xopigun/Projet2A/banc-can/docs/latex/config_logicielle.tex

% ===========================================================================
%  FICHIER GÉNÉRÉ — NE PAS ÉDITER À LA MAIN
%  Produit par tools/codegen à partir des firmware/boards/*/board.h.
%  Regénérer :  python -m tools.codegen
% ===========================================================================

\begin{table}[H]
\centering\small
\begin{tabular}{lc}
\toprule
\textbf{Paramètre} & \textbf{N1--N4 (STM32G431)} \\
\midrule
Périphérique & FDCAN1, mode \emph{Classic} \\
Référence d'horloge & HSE \SI{24}{MHz} (quartz, \SI{20}{ppm}) \\
Horloge noyau CAN & \SI{80}{MHz} \\
Prescaler & 10 \\
Durée du bit & 16 tq \\
Segments (sync + 1 + 2) & 1 + 13 + 2 \\
SJW & 2 \\
Point d'échantillonnage & \SI{87.50}{\percent} \\
Tolérance d'oscillateur & \SI{0.485}{\percent} \\
Débit & \SI{500}{kbit/s} \\
\midrule
Filtres d'acceptation & aucun \\
Retransmission automatique & activée \\
Reprise après \emph{bus-off} & logicielle (\texttt{CCCR.INIT}) \\
Mode silencieux & \texttt{CCCR.MON} \\
Bouclage interne & \texttt{FDCAN\_MODE\_INTERNAL\_LOOPBACK} \\
\bottomrule
\end{tabular}
\caption{Configuration retenue du contrôleur CAN, commune aux quatre nœuds. Valeurs relues dans le \texttt{board.h} de la Nucleo-G431KB et vérifiées par \texttt{scripts/bit\_timing.py}.}
\label{tab:config-logicielle}
\end{table}
