xopigun/Projet2A/banc-can/docs/presentation/Avancement_Bus_CAN_G69.pptx

## Banc de test CAN

Point d'avancement du projet — G69-BANC-001

Groupe 69 — Conception d'une Électronique Modulaire (Bus CAN)
Samuel Gomri · Dylan Kiati · Hugo Mathoux
ENSEA — Projet 2A · novembre 2026

Notes: Présentation de l'avancement du banc de test CAN G69-BANC-001 devant l'équipe enseignante. Déroulé : où on en est, le planning, puis le détail technique (ICD, matériel, firmwares, outils, démonstration, adaptateur USB-CAN), les difficultés et la suite.

## Le besoin : un banc de test CAN générique

- Outil commun pour valider le standard CAN et les ICD écrits avec les groupes partenaires
- Aucun code propre à un partenaire : tout passe par la configuration
- Quatre projets traités au même niveau

Cobot RMD-X

Ecomarathon

Formula Student

MIR1000

Sept tests de validation

T1

Couche physique

T2

Débit et temps de bit

T3

Arbitrage ARM/GO

T4

Encodage ICD

T5

Fautes physiques

T6

Fautes logicielles

T7

Isolation galvanique

Notes: Le banc sert à tous les groupes partenaires : il ne contient rien de spécifique à l'un d'eux. Paramètres choisis : 500 kbit/s, CAN 2.0A, échantillonnage à 87,5 %. La tolérance d'horloge de 0,485 % est ce qui nous a obligés à utiliser le quartz (voir mise en route). Sept tests, de la couche physique à l'isolation galvanique ; T3, T4 et T6 sont automatisés par canbench.

## L'ICD : une seule source pour tout le monde

Code C
des firmwares

- Aucune recopie à la main : un test de CI vérifie que le code généré est à jour
- 248 vecteurs de référence : tous les encodeurs donnent le même résultat
- Formulaire ICD distribué aux groupes partenaires

bench_icd.yaml

identifiants, signaux, encodages

Générateur

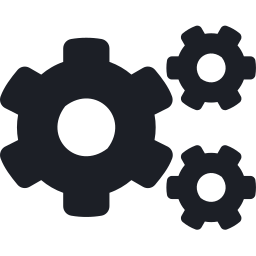
[picture p5: figure]

Python
des outils PC

Fichier DBC
pour les logiciels CAN

Tableaux LaTeX
du dossier

Exemple d'application : schéma du bus du Cobot (dossier Cobot/).

Notes: Point clé de la conception : l'ICD est décrite une seule fois, dans un fichier YAML. Un générateur en tire le code C, le Python, un DBC et les tableaux LaTeX du dossier. On ne recopie jamais d'identifiant à la main, et la CI échoue si le code généré n'est plus à jour.

## Le matériel du banc

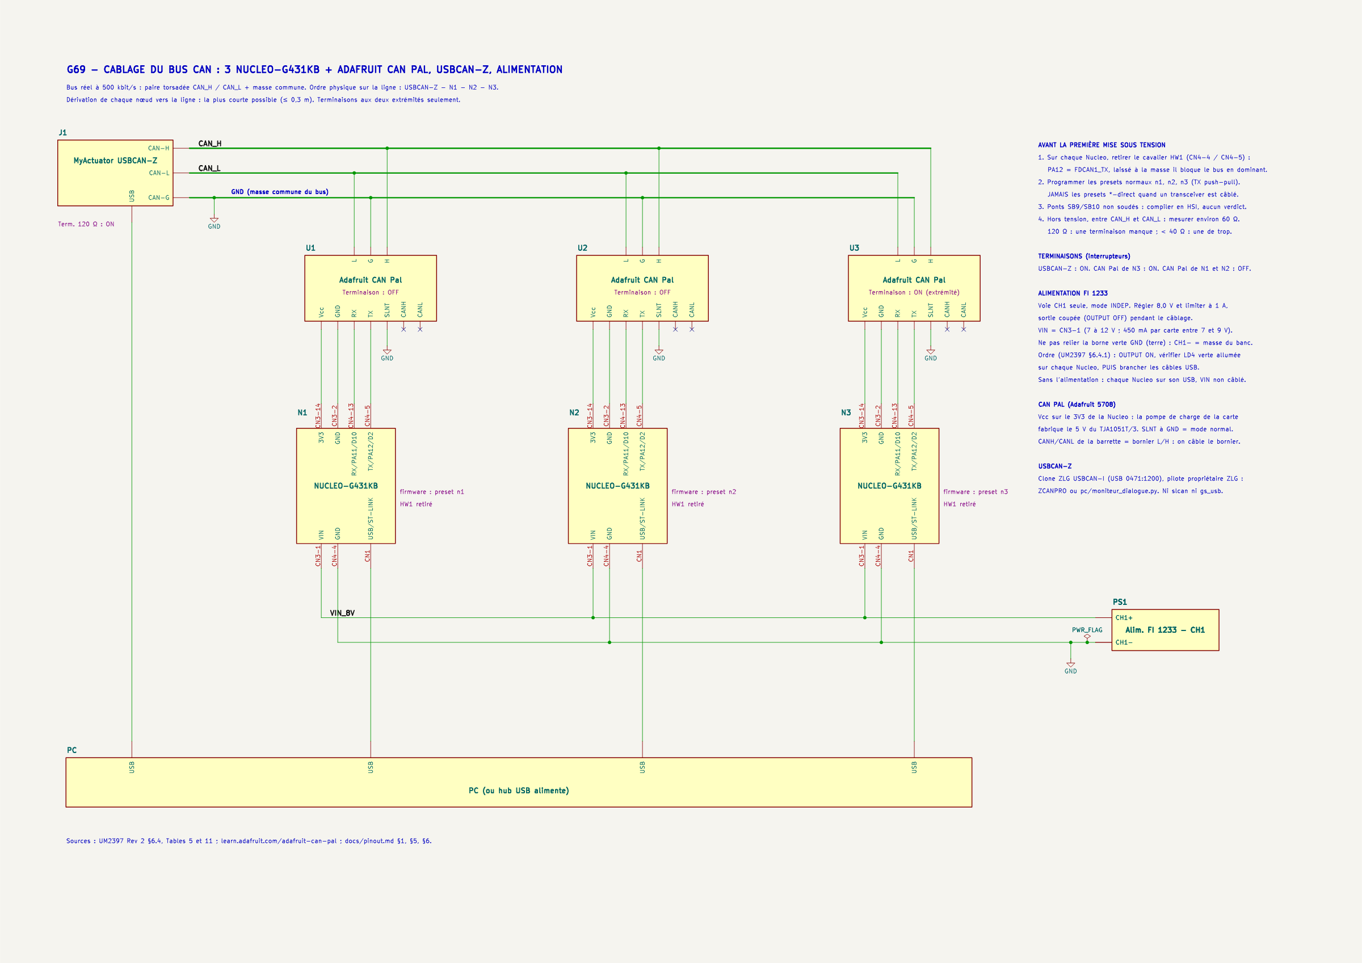
[picture p6: figure]
Schéma de câblage du bus CAN du banc (KiCad)

- 3 × NUCLEO-G431KB (N1, N2, N3), chacune avec un transceiver CAN Pal (TJA1051T/3)
- Paire torsadée CAN_H / CAN_L et masse commune
- Interface PC : USBCAN-Z, à une extrémité du bus
- 120 Ω aux deux extrémités, résistances intégrées activées par interrupteur : USBCAN-Z et CAN Pal de N3
- 4ᵉ nœud prévu : Blue Pill STM32F103 ; firmware aussi pour la Nucleo-L476RG

Notes: Schéma de câblage complet, fait sous KiCad, ERC sans erreur. Trois Nucleo G431KB avec un transceiver chacune, l'USBCAN-Z côté PC. Les deux terminaisons de 120 ohms sont bien aux deux extrémités physiques de la ligne.

## Deux modifications sur chaque Nucleo

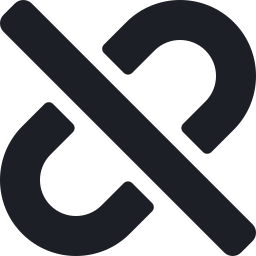
[picture p7: figure]

Retirer le cavalier HW1

Il relie PA12 (FDCAN1_TX) à la masse : le bus reste bloqué en état dominant, et le symptôme ressemble à une panne.

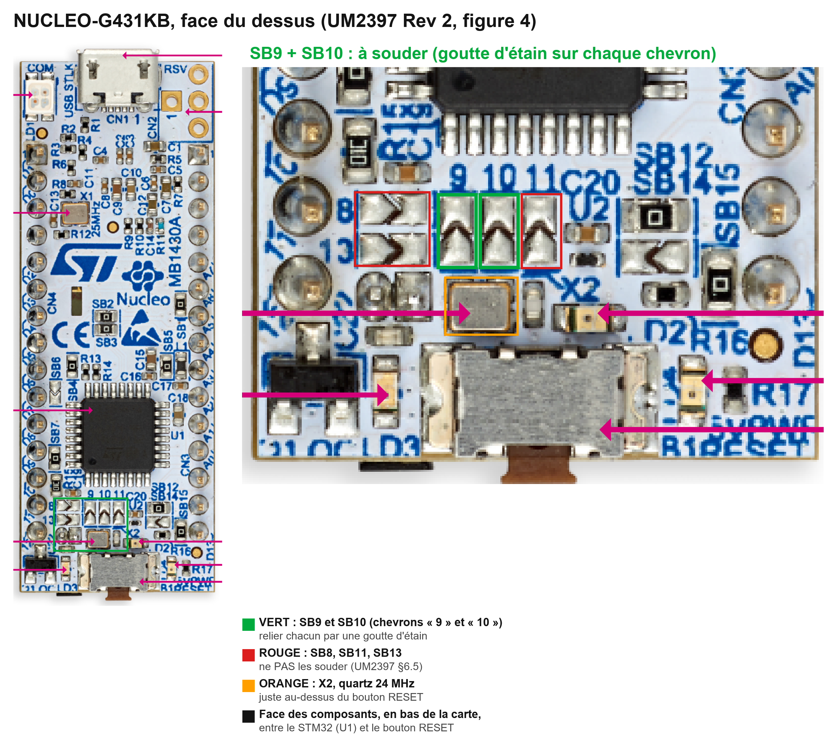
[picture p8: figure]
Emplacement des ponts SB9 et SB10
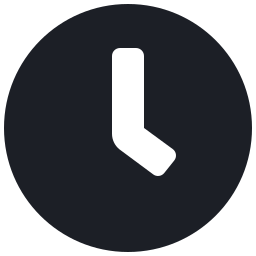
[picture p9: figure]

Souder les ponts SB9 et SB10

Ils branchent le quartz 24 MHz. L'oscillateur interne (±1 %) dépasse la tolérance CAN de 0,485 %. Fait et vérifié sur les 3 cartes : PLL à 160 MHz.

Trouvé en lisant le manuel de ST (UM2397), avant la première mise sous tension.

Notes: Deux pièges trouvés dans la documentation de ST. HW1 est un cavalier livré fermé qui met la broche TX du CAN à la masse. Et la carte démarre sur l'oscillateur interne, trop imprécis pour le CAN à 500 kbit/s : on a soudé SB9 et SB10 pour utiliser le quartz.

## Une mise en route par étapes

1

29/09 Bouclage interne

Le contrôleur CAN se parle à lui-même : 8 trames sur 8, aucune erreur. Horloge, temps de bit et encodage validés sans câblage.

20F · DLC 4 · 54 65 73 74 = « Test », CRC 1C62

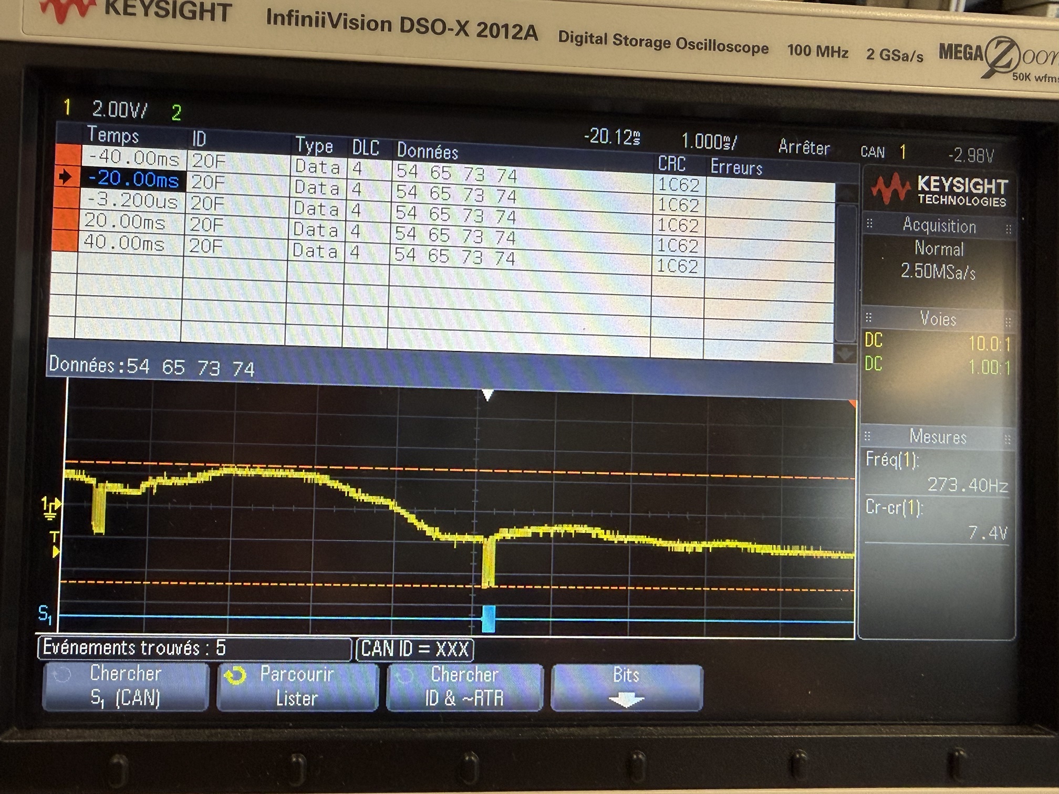
[picture p10: figure]
Oscilloscope décodant la trame CAN 0x20F « Test »

2

20/10 Bus direct + oscilloscope

Deux Nucleo reliées fil à fil, sans transceiver. La trame « Test » est décodée par l'oscilloscope.

3

03/11 Banc réel

Transceivers, paire torsadée, USBCAN-Z : dialogue entre les nœuds et appels depuis le PC.

Notes: On a avancé par étapes pour isoler les problèmes. D'abord le bouclage interne, qui valide le contrôleur sans aucun câble. Puis un bus direct entre deux cartes, observé à l'oscilloscope : on décode la trame 0x20F avec les données « Test ». Enfin le banc réel avec transceivers, le 3 novembre.

## Les firmwares : une architecture en couches

Application commune
heartbeat · arbitrage ARM/GO · fautes BENCH_CFG · afficheurs LCD

- Autotest de mise en route : bouclage interne, puis ping/pong sur le bus
- Tests unitaires sur PC, sans matériel
- Un preset CMake par nœud et par mode : autotest, scope, dialogue…
- Afficheurs LCD 16×2 : dernière trame reçue et état du contrôleur

Interface CAN abstraite
can_if.h : même API sur tous les microcontrôleurs

FDCAN
STM32G431

bxCAN
STM32F103

bxCAN
STM32L476

board.h : tout le brochage d'une carte dans un seul fichier

Notes: Architecture en couches : le code applicatif ne connaît pas le microcontrôleur. Une seule interface CAN, réalisée trois fois : FDCAN pour le G431, bxCAN pour le F103 et le L476. Le brochage est centralisé dans board.h. Le code commun est testé sur PC sans matériel.

## Les outils PC

canbench

Ligne de commande : moniteur, tests d'arbitrage, d'encodage et de fautes, charge du bus, rapports datés.

BancCAN.exe

Interface graphique : bus en direct, état des nœuds, trames décodées, tests T3, T4, T6, chronogrammes.

Moniteur de dialogue

Trames émises et reçues avec leur transcription, utilisé pour la démonstration du 03/11.

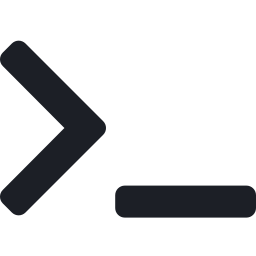
[picture p11: figure]
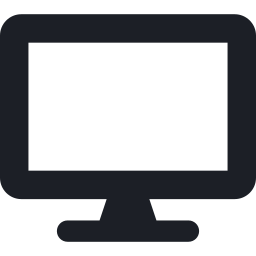
[picture p12: figure]
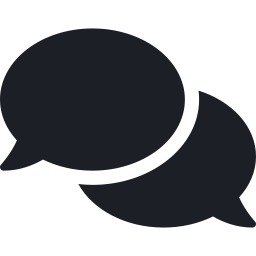
[picture p13: figure]
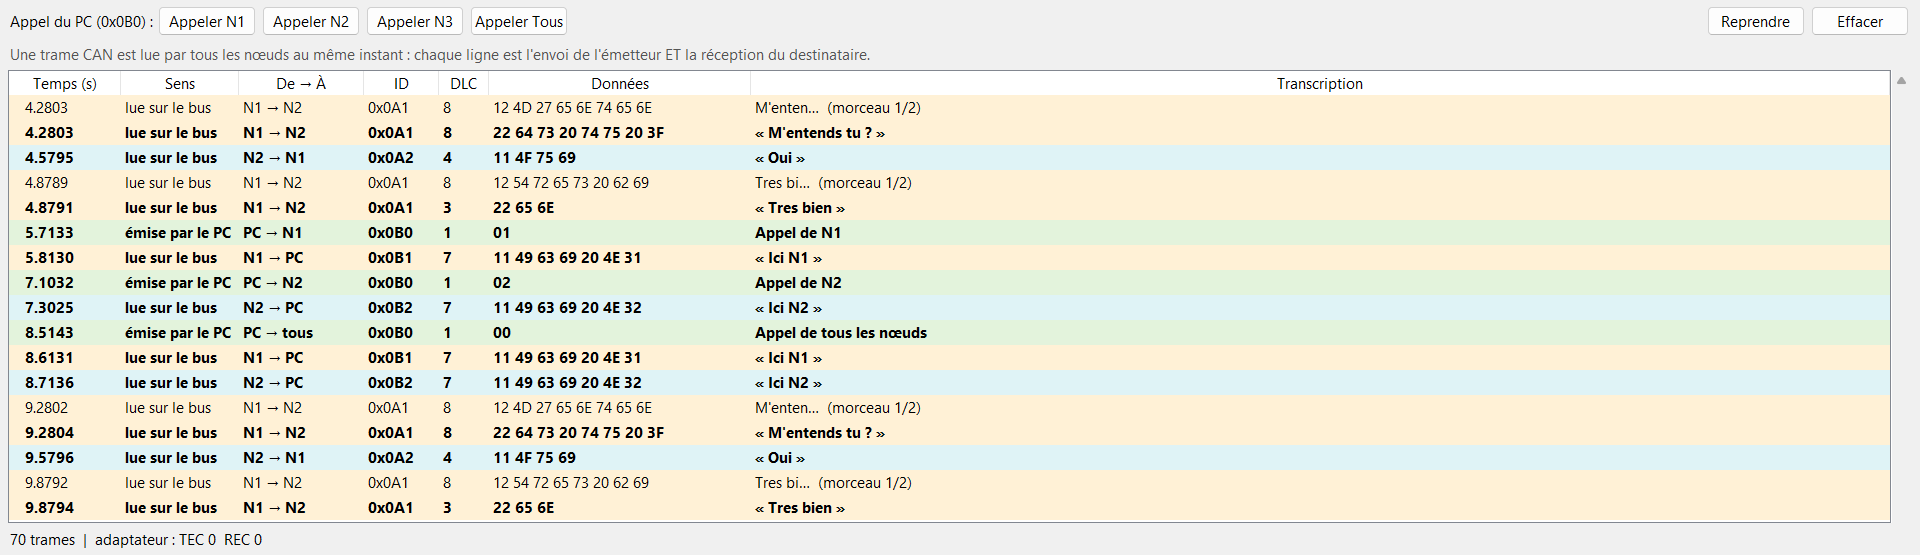
[picture p14: figure]
Moniteur de dialogue

Notes: Trois outils. canbench en ligne de commande pour les tests automatisés, avec des rapports datés et le hash git du firmware. BancCAN.exe pour piloter le banc sans ligne de commande. Tout fonctionne aussi sur un bus virtuel, mais aucun verdict n'y est prononcé.

## Démonstration du 03/11 sur le banc réel

N1 → N2 0x0A1

« M'entends tu ? »

N2 → N1 0x0A2

« Oui »

N1 → N2 0x0A1

« Tres bien »

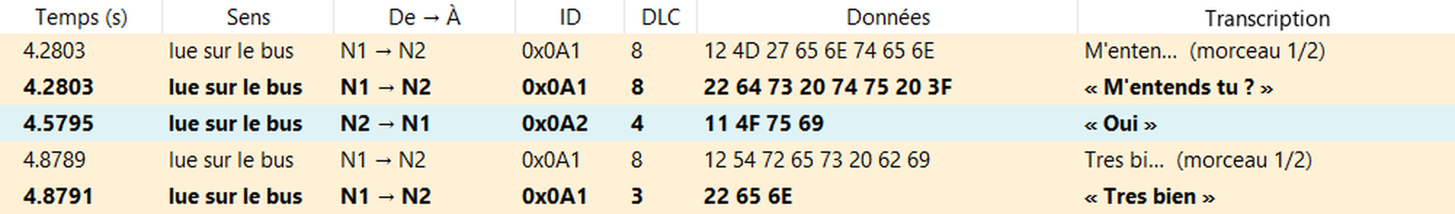
[picture p15: figure]
Dialogue entre N1 et N2

Messages découpés
7 caractères de texte par trame

Réponse en 300 ms
4,280 s → 4,580 s → 4,879 s

Appels du PC
« Ici Nn » sur 0x0B0 + n

0 erreur
TEC = REC = 0

Notes: Le 3 novembre, sur le vrai bus à 500 kbit/s : N1 demande « M'entends tu ? », N2 répond « Oui », N1 conclut. Les messages de plus de 7 caractères sont découpés en plusieurs trames. Le PC peut aussi appeler un nœud, qui répond « Ici N1 », « Ici N2 »... On a constaté les heartbeats, l'arbitrage et le dialogue, avec des compteurs d'erreurs à zéro.

## La simulation 3D du banc

- Banc complet dans le navigateur, avec les vrais modèles 3D KiCad
- Moteur CAN 2.0A au bit près : CRC-15, bourrage, arbitrage, ACK, TEC/REC, bus-off
- Interactif : interrupteurs de faute SW1 à SW3, BENCH_CFG, test T3
- Vérifiée par les 248 vecteurs et 7 scénarios rejoués

Utile pour une démonstration en direct, sans matériel.

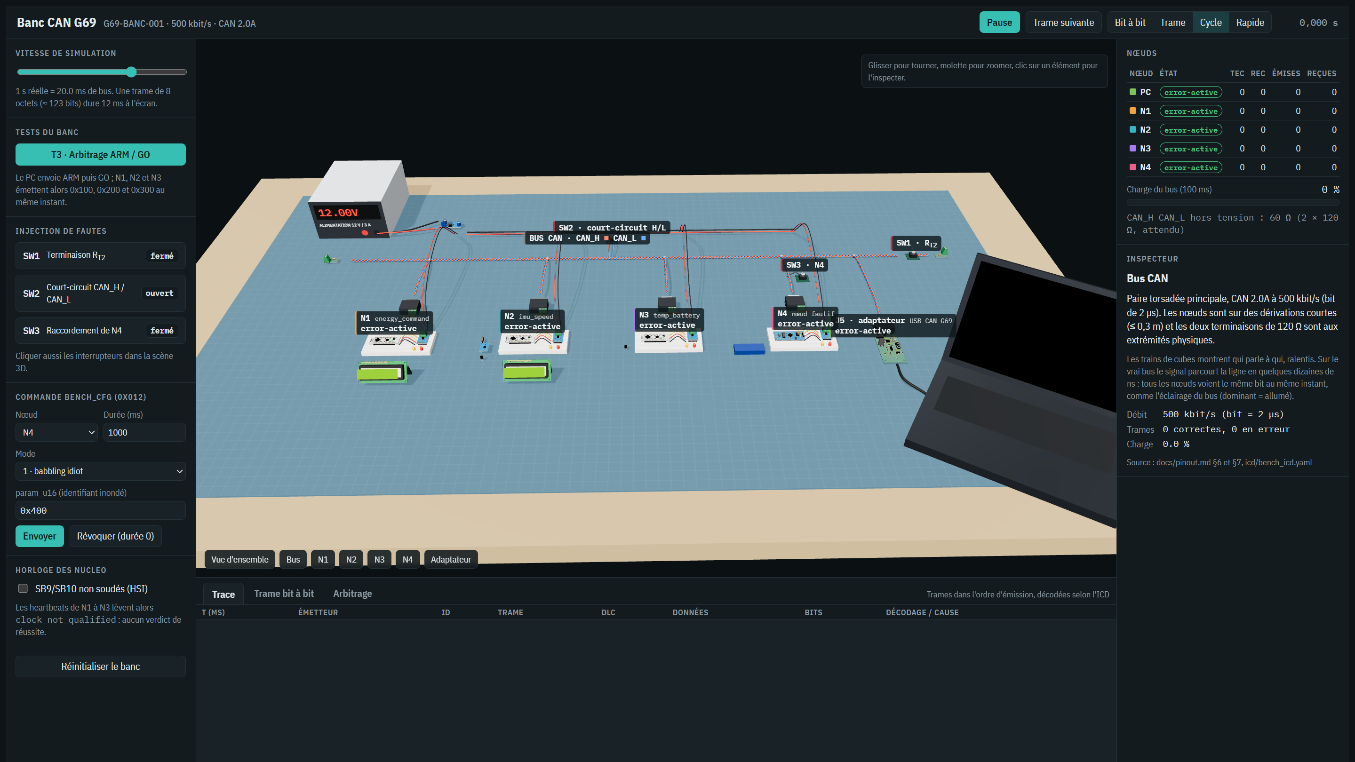
[picture p16: figure]
Simulation 3D du banc

Notes: La simulation reproduit le banc en 3D avec un vrai moteur CAN au niveau du bit. On peut provoquer des fautes et lancer le test d'arbitrage. Elle est vérifiée avec les mêmes vecteurs de référence que les firmwares. On peut la lancer en direct si vous le souhaitez.

## Notre adaptateur USB-CAN, conçu sous KiCad

Pourquoi : le CANable 2.0 prévu ne pouvait pas être commandé. On a conçu une carte équivalente, fabricable à la factory de l'ENSEA.

USB-B

ESD USBLC6

CH340C

STM32G431

TJA1051T/3

DB9

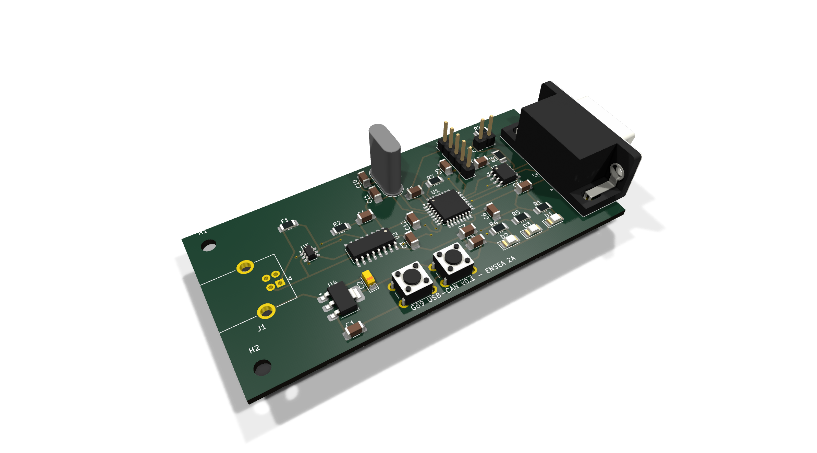
[picture p17: figure]
Vue 3D de l'adaptateur USB-CAN

87,7 × 41 mm
PCB 2 couches, règles de la factory

0 erreur
ERC et DRC

Dossier complet
Gerber, perçages, nomenclature, PCB à l'échelle 1:1

Notes: Faute de CANable, on a conçu notre propre interface USB-CAN : USB, protection ESD, pont USB-série CH340C, un STM32G431 avec son FDCAN, le transceiver et un DB9 au brochage CiA 303-1. PCB de 87,7 par 41 mm aux règles de la factory, ERC et DRC sans erreur, chaque composant vérifié contre sa datasheet. Le dossier de fabrication est prêt.

## Difficultés rencontrées et résolues

Débordement de tampon

La HAL copiait 64 octets dans un tampon de 8. Corrigé.

Nœuds figés au démarrage

Gestionnaire SysTick absent. Ajouté, vérifié à l'édition de liens.

Horodatages figés

Compteur DWT arrêté après déconnexion du débogueur. Corrigé.

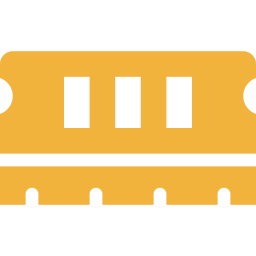
[picture p18: figure]
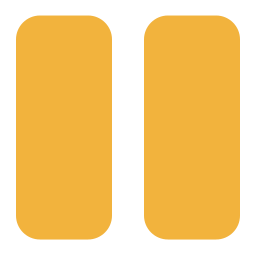
[picture p19: figure]
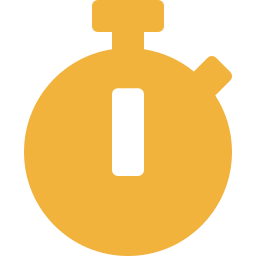
[picture p20: figure]

Problème de brochage

PB9 absent du boîtier, PA2 déjà pris par le port COM : brochage revu.

Horloge trop imprécise

HSI à ±1 % pour 0,485 % admis : passage sur le quartz (SB9/SB10).

CANable non commandable

USBCAN-Z en attendant, et adaptateur USB-CAN conçu par le groupe.

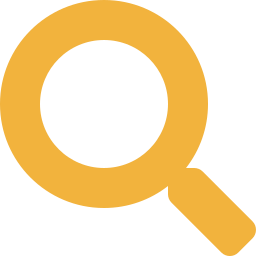
[picture p21: figure]
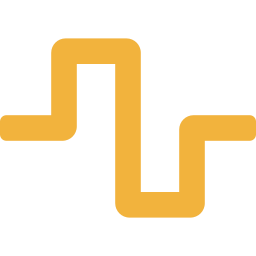
[picture p22: figure]
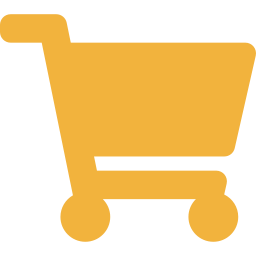
[picture p23: figure]

Notes: Les principales difficultés, toutes résolues et tracées dans le CHANGELOG. Plusieurs viennent d'écarts entre le dossier v0.1 et la réalité de la carte, trouvés en relisant la documentation de ST.

## Merci

Questions ?

Dépôt : github.com/xopigun/Projet2A

Notes: Proposer une démonstration en direct de la simulation 3D ou de BancCAN.exe si le temps le permet.
