xopigun/Projet2A/Management/RACI.pdf

Groupe 69 — Conception d’une électronique modulaire (bus CAN) | G69-GP-001 v0.1 — 22/09/2026

# Matrice RACI

Projet 2A «Conception d’une électronique modulaire (bus CAN)» — module MANAGEMENT_PROJET_S7

Référence | G69-GP-001
Version | 0.1 — proposition à valider en équipe
Date | 22 septembre 2026
Équipe | Samuel Gomri, Dylan Kiati, Hugo Mathoux
Encadrants | Yves Heckel, Julien Seigneurbieux — Référent module : Nicolas Papazoglou

# 1. Objet

Ce document formalise la matrice RACI du projet : pour chaque activité, il fixe qui la réalise, qui en répond, qui est consulté et qui est informé (compétence MC3). C’est un document vivant, revu à chaque point d’équipe et versionné à chaque évolution. Les activités reprennent le découpage en lots du planning v4.0 (L0 à L5); les risques associés sont suivis dans le registre G69-GP-002.

# 2. Matrice RACI

Légende. R Réalise — effectue le travail. | A Répond — porte la responsabilité finale et valide le résultat. | R/A réalise et répond. | C Consulté — avis sollicité
avant décision. | I Informé — tenu au courant du résultat. – non concerné.

Règles appliquées.
- Une activité a un seul A et au moins un R. Exception assumée : pour l’activité 1.6, chaque référent partenaire est A pour l’ICD de son propre projet; le groupe 69 accompagne mais ne décide pas à sa place.
- Les quatre groupes partenaires sont listés par ordre alphabétique et reçoivent des rôles identiques sur chaque ligne (parité stricte).
- Les membres de l’équipe sont listés par ordre alphabétique. Les couleurs d’en-tête reprennent le code du GANTT. La répartition proposée est équilibrée : chaque membre porte le rôle A de 9 activités.

Référents des groupes partenaires (à compléter lors du premier point de synchronisation, ordre alphabétique) :

Groupe partenaire | Référent CAN | Contact
Cobot industriel à actionneurs intégrés (RMD-X)

Ecomarathon
Formula Student
Retrofit MIR1000

1

Groupe 69 — Conception d’une électronique modulaire (bus CAN) | G69-GP-001 v0.1 — 22/09/2026
Équipe G69 | Encadrement | Référents des groupes partenaires
ID | Activité | Gomri | Kiati | Mathoux
Encadrants
Heckel,
Seigneurbieux

Réf.
module

Cobot

RMD-X | Ecomarathon Formula
Student | MIR1000

L0 — Pilotage
0.1 | Mise à jour du GANTT et suivi d’avancement | R | R/A | R | I | I | – | – | – | –
0.2 | Organisation des points de synchronisation avec les
| partenaires | R/A | C | C | I | – | C | C | C | C
0.3 | Tenue et revue du registre de risques | R | R | R/A | C | I | – | – | – | –
0.4 | Préparation des points d’avancement avec les encadrants | R/A | R | R | C | – | – | – | – | –
L1 — Standard commun et ICD
1.1 | Contraintes communes (norme CAN 2.0A, 500 kbit/s,
| topologie, terminaisons) | C | R/A | C | C | – | I | I | I | I
1.2 | Spécification transceiver (références retenues et proscrites) | C | C | R/A | C | – | I | I | I | I
1.3 | Modèle d’ICD (LaTeX, PDF remplissable, table d’encodage
| unifiée) | C | C | R/A | C | – | C | C | C | C
1.4 | Présentation du bus CAN aux groupes partenaires (réalisé) | R/A | R | R | I | – | I | I | I | I
1.5 | Diffusion de l’ICD aux groupes partenaires | R/A | I | I | I | – | I | I | I | I
1.6 | Recueil des besoins et remplissage de l’ICD de chaque projet | R | C | C | I | – | R/A | R/A | R/A | R/A
1.7 | Intégration des retours et versionnement des ICD | R | R/A | R | I | – | C | C | C | C
1.8 | Réservation des identifiants 0x010 (ARM) et 0x011 (GO)
| dans chaque ICD | C | C | R/A | I | – | C | C | C | C

L2 — Banc de test
2.1 | Dossier de définition du banc (G69-BANC-001), dont
| corrections v0.2 | C | R | R/A | C | – | – | – | – | –
2.2 | Budget et commande du matériel | R | R | R | A | I | – | – | – | –
2.3 | Assemblage physique et câblage (platine, points de mesure,
| terminaisons amovibles) | R | R/A | R | I | – | – | – | – | –
2.4 | Mise en route des cartes (phases 1 à 3 de la procédure) | R/A | R | C | I | – | – | – | – | –
L3 — Briques logicielles
3.1 | Dépôt logiciel et générateur de code depuis l’ICD du banc | C | C | R/A | I | – | – | – | – | –
3.2 | Firmware des nœuds N1 à N3 (Nucleo-G431KB) | C | R | R/A | I | – | – | – | – | –
3.3 | Firmware du nœud N4 (Blue Pill STM32F103) | C | R/A | R | I | – | – | – | – | –
3.4 | Outil PC canbench (utilisation, maintenance) | R/A | C | C | I | – | – | – | – | –
L4 — Mesures
4.1 | Bit timing FDCAN et point d’échantillonnage à 500 kbit/s | C | R/A | C | C | – | I | I | I | I
4.2 | Exécution du protocole de validation (tests T1 à T7) | R | R/A | R | I | – | I | I | I | I
4.3 | Comparatif mesuré TJA1051T/3 et SN65HVD230 | C | C | R/A | C | – | I | I | I | I
4.4 | Tests d’injection de fautes (nœud N4) | C | R/A | R | I | – | – | – | – | –
L5 — Livrables
5.1 | Rapport écrit | R/A | R | R | C | I | – | – | – | –
5.2 | Support et présentation orale | R | R/A | R | C | I | – | – | – | –
5.3 | Artefacts de gestion : RACI, registre de risques, CBDD / ACV | R | R | R/A | C | I | – | – | – | –
5.4 | Document de clôture formelle du projet | R/A | R | R | C | I | I | I | I | I
5.5 | Transfert final aux partenaires (ICD finales, protocole
| ARM/GO, recette) | R/A | R | R | I | – | I | I | I | I

2
