xopigun/Projet2A/banc-can/docs/nucleo_broches_banc.png

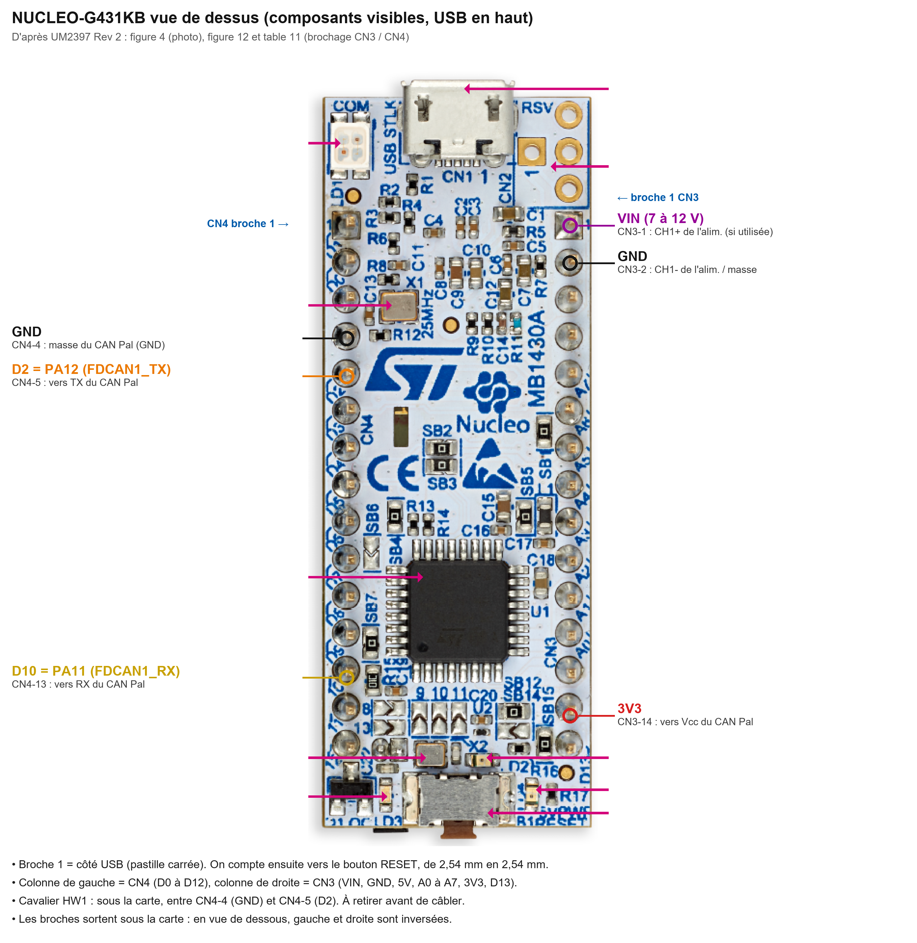
banc-can/docs/nucleo_broches_banc.png
