xopigun/Projet2A/banc-can/docs/presentation/captures/03_gros_plan_appels_du_PC.png

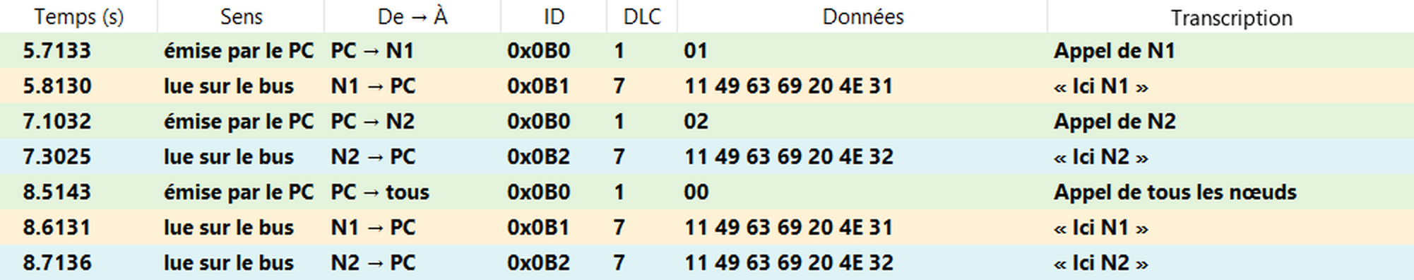
banc-can/docs/presentation/captures/03_gros_plan_appels_du_PC.png
