xopigun/Projet2A/banc-can/docs/presentation/captures/04_zcanpro_trames_brutes.jpg

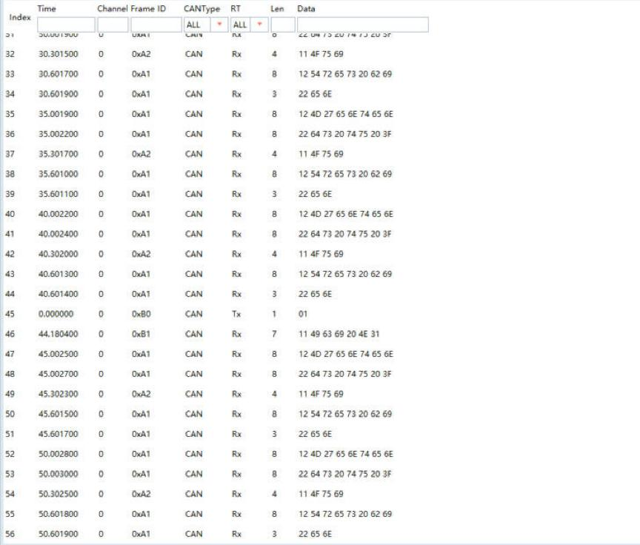
banc-can/docs/presentation/captures/04_zcanpro_trames_brutes.jpg
