xopigun/Projet2A/banc-can/docs/presentation/images/adaptateur_3d_dessous.png

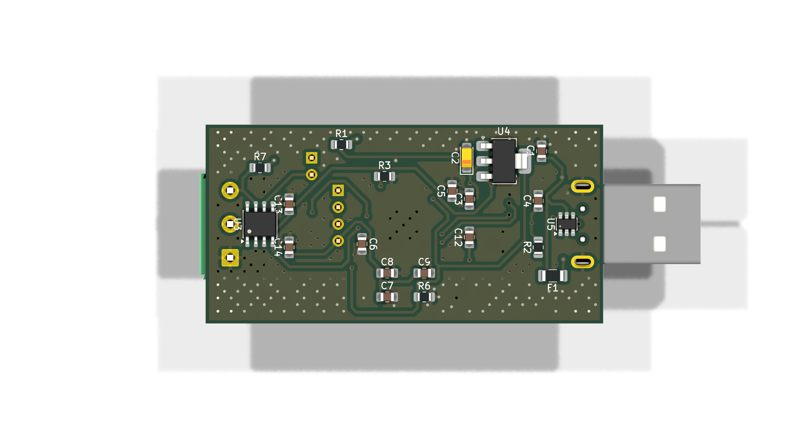
banc-can/docs/presentation/images/adaptateur_3d_dessous.png
