xopigun/Projet2A/banc-can/docs/presentation/images/adaptateur_3d_dessus.png

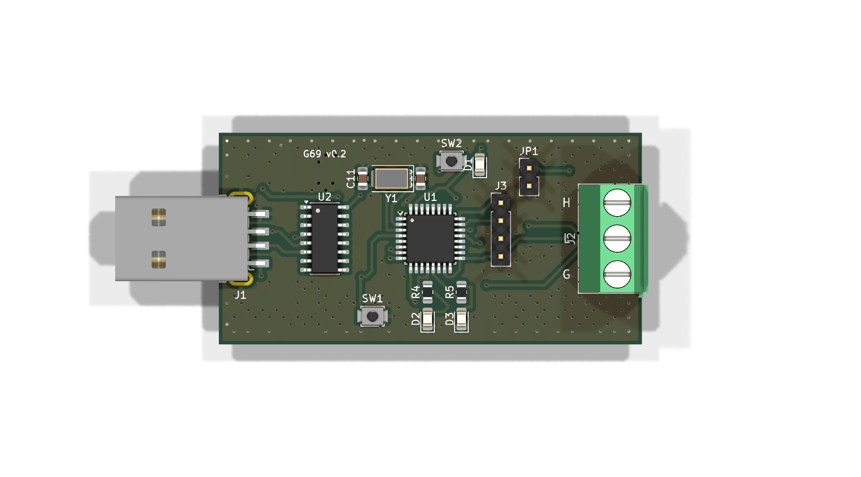
banc-can/docs/presentation/images/adaptateur_3d_dessus.png
