xopigun/Projet2A/banc-can/docs/presentation/images/adaptateur_pcb.png

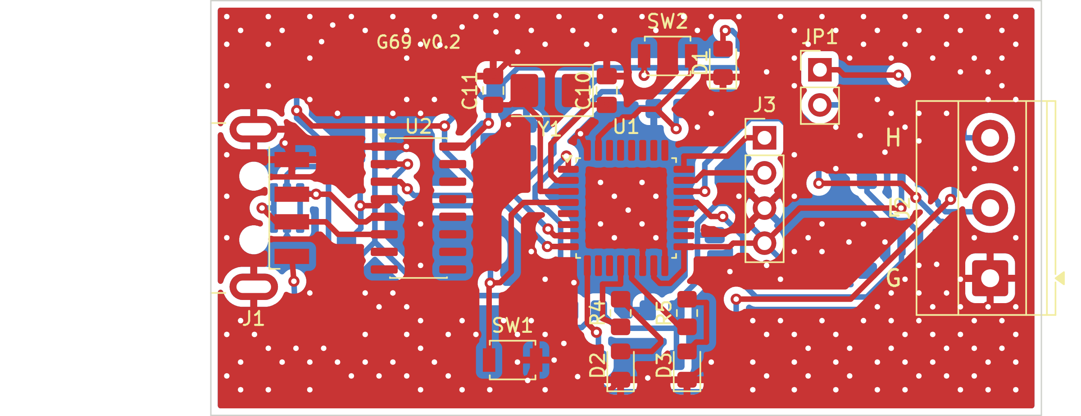
banc-can/docs/presentation/images/adaptateur_pcb.png
