xopigun/Projet2A/banc-can/docs/presentation/images/adaptateur_schema.png

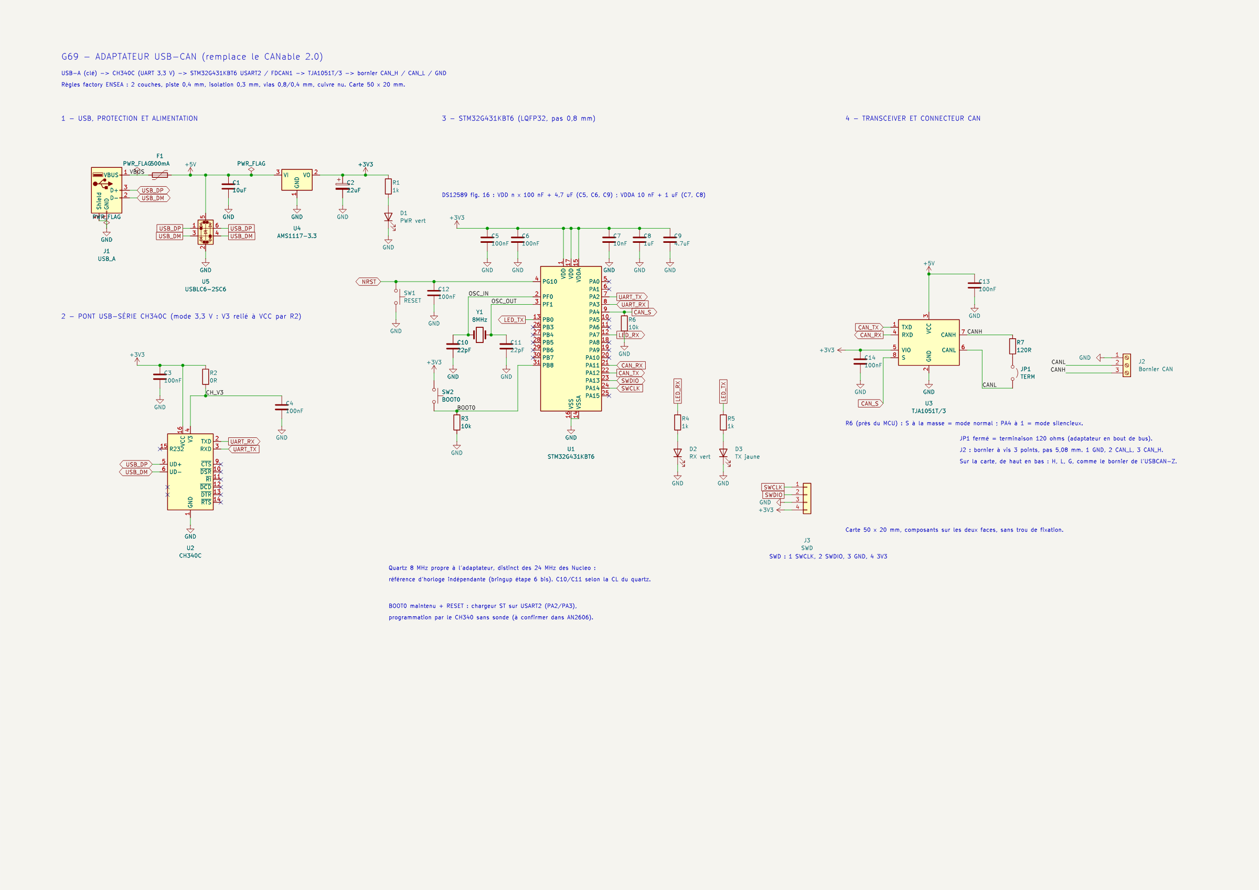
banc-can/docs/presentation/images/adaptateur_schema.png
