xopigun/Projet2A/banc-can/schema/preview.png

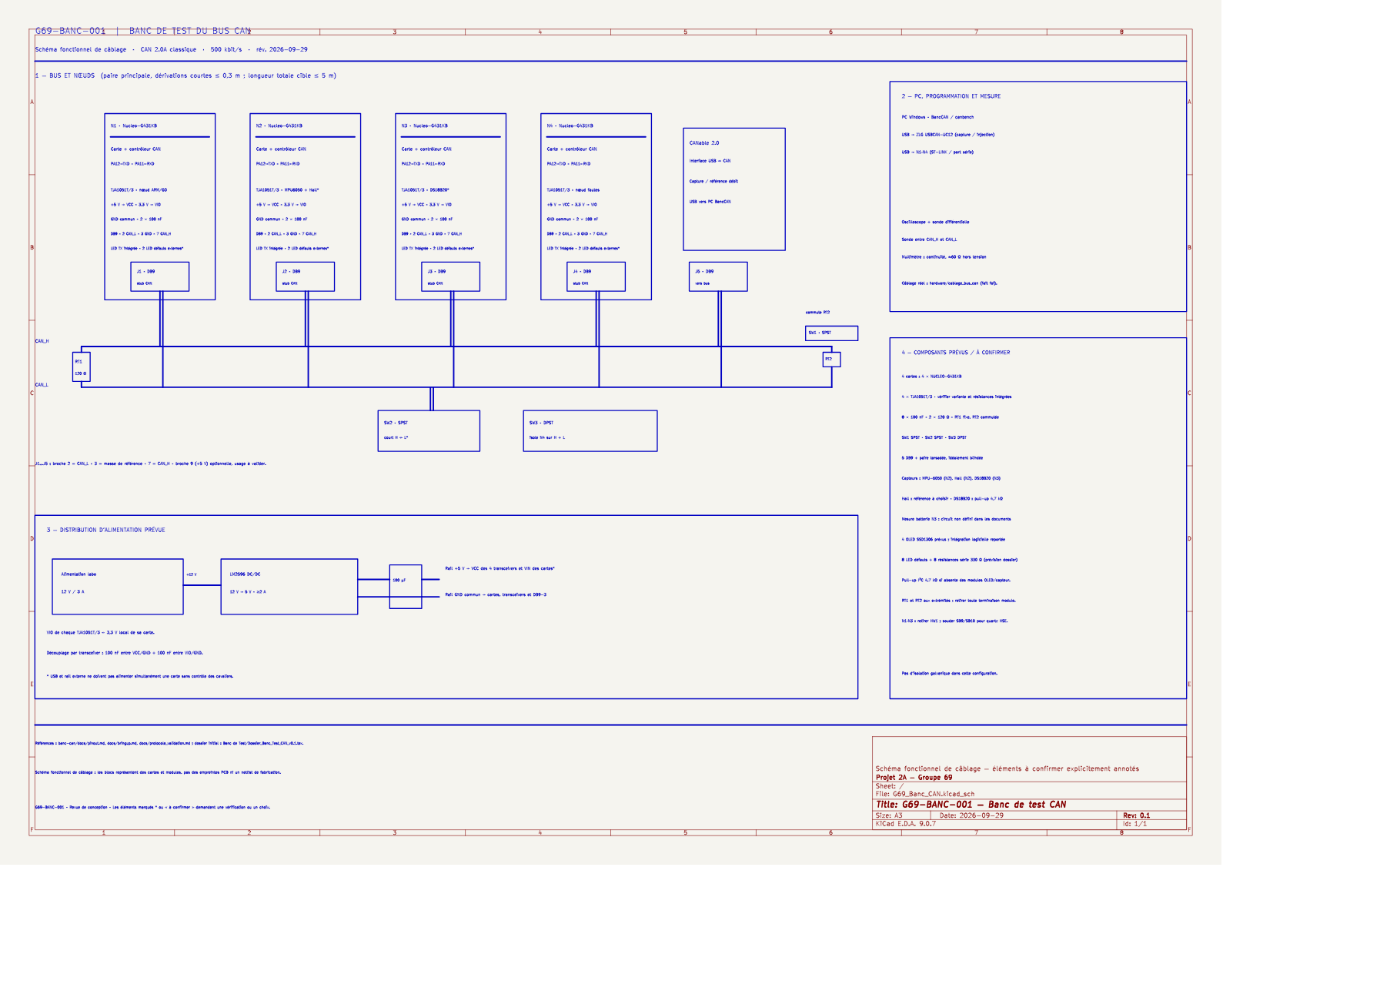
banc-can/schema/preview.png
