xopigun/Projet2A/Cobot/schema_bus_cobot.png

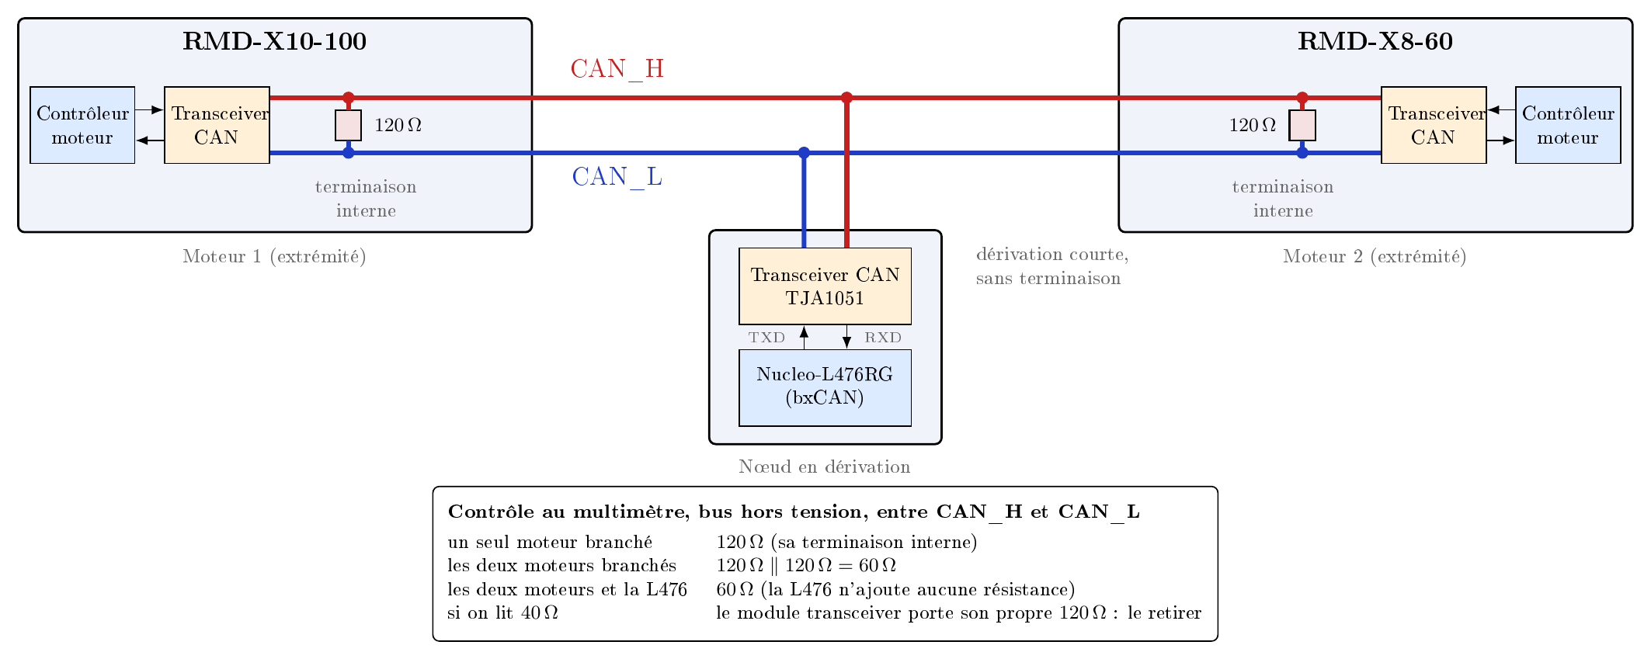
Cobot/schema_bus_cobot.png
