xopigun/Projet2A/banc-can/hardware/adaptateur_usb_can/fabrication/adaptateur_usb_can_commande.xlsx

Sheet: Composants
Adaptateur USB-CAN G69 : composants à commander
Nombre de cartes à produire |  |  | 2 | ← case jaune à modifier (les quantités totales en dépendent)
Repères | Qté / carte | Qté à commander | Désignation | Valeur | Boîtier | Fabricant | Réf. fabricant | Remarque | Farnell France | RS Components France | Mouser France | DigiKey France
C1 | 1 |  | Condensateur céramique X5R 16 V | 10uF | 0805 | au choix |  | entrée 5 V du régulateur | Rechercher (https://fr.farnell.com/search?st=condensateur+ceramique+10uF+0805) | Rechercher (https://fr.rs-online.com/web/c/?searchTerm=condensateur+ceramique+10uF+0805) | Rechercher (https://www.mouser.fr/c/?q=condensateur+ceramique+10uF+0805) | Rechercher (https://www.digikey.fr/fr/products/result?keywords=condensateur+ceramique+10uF+0805)
C10, C11 | 2 |  | Condensateur céramique C0G/NP0 50 V | 22pF | 0805 | au choix |  | à ajuster selon la CL du quartz | Rechercher (https://fr.farnell.com/search?st=condensateur+ceramique+22pF+0805) | Rechercher (https://fr.rs-online.com/web/c/?searchTerm=condensateur+ceramique+22pF+0805) | Rechercher (https://www.mouser.fr/c/?q=condensateur+ceramique+22pF+0805) | Rechercher (https://www.digikey.fr/fr/products/result?keywords=condensateur+ceramique+22pF+0805)
C2 | 1 |  | Condensateur tantale solide 22 µF 10 V, boîtier A (3216-18), polarisé | 22uF | tantale A (3216) | au choix |  | sortie de l'AMS1117 : tantale exigé pour la stabilité; polarisé : respecter le + sur la carte | Rechercher (https://fr.farnell.com/search?st=condensateur+tantale+22uF+10V+boitier+A+3216) | Rechercher (https://fr.rs-online.com/web/c/?searchTerm=condensateur+tantale+22uF+10V+boitier+A+3216) | Rechercher (https://www.mouser.fr/c/?q=condensateur+tantale+22uF+10V+boitier+A+3216) | Rechercher (https://www.digikey.fr/fr/products/result?keywords=condensateur+tantale+22uF+10V+boitier+A+3216)
C3, C4, C5, C6, C12, C13, C14 | 7 |  | Condensateur céramique X7R 50 V | 100nF | 0805 | au choix |  | découplage | Rechercher (https://fr.farnell.com/search?st=condensateur+ceramique+100nF+0805) | Rechercher (https://fr.rs-online.com/web/c/?searchTerm=condensateur+ceramique+100nF+0805) | Rechercher (https://www.mouser.fr/c/?q=condensateur+ceramique+100nF+0805) | Rechercher (https://www.digikey.fr/fr/products/result?keywords=condensateur+ceramique+100nF+0805)
C7 | 1 |  | Condensateur céramique X7R 50 V | 10nF | 0805 | au choix |  | VDDA, avec C8 | Rechercher (https://fr.farnell.com/search?st=condensateur+ceramique+10nF+0805) | Rechercher (https://fr.rs-online.com/web/c/?searchTerm=condensateur+ceramique+10nF+0805) | Rechercher (https://www.mouser.fr/c/?q=condensateur+ceramique+10nF+0805) | Rechercher (https://www.digikey.fr/fr/products/result?keywords=condensateur+ceramique+10nF+0805)
C8 | 1 |  | Condensateur céramique X7R 16 V | 1uF | 0805 | au choix |  | VDDA | Rechercher (https://fr.farnell.com/search?st=condensateur+ceramique+1uF+0805) | Rechercher (https://fr.rs-online.com/web/c/?searchTerm=condensateur+ceramique+1uF+0805) | Rechercher (https://www.mouser.fr/c/?q=condensateur+ceramique+1uF+0805) | Rechercher (https://www.digikey.fr/fr/products/result?keywords=condensateur+ceramique+1uF+0805)
C9 | 1 |  | Condensateur céramique X5R 10 V | 4.7uF | 0805 | au choix |  | réservoir 3,3 V | Rechercher (https://fr.farnell.com/search?st=condensateur+ceramique+4.7uF+0805) | Rechercher (https://fr.rs-online.com/web/c/?searchTerm=condensateur+ceramique+4.7uF+0805) | Rechercher (https://www.mouser.fr/c/?q=condensateur+ceramique+4.7uF+0805) | Rechercher (https://www.digikey.fr/fr/products/result?keywords=condensateur+ceramique+4.7uF+0805)
D1 | 1 |  | LED verte | PWR vert | 0805 | au choix |  |  | Rechercher (https://fr.farnell.com/search?st=LED+verte+0805) | Rechercher (https://fr.rs-online.com/web/c/?searchTerm=LED+verte+0805) | Rechercher (https://www.mouser.fr/c/?q=LED+verte+0805) | Rechercher (https://www.digikey.fr/fr/products/result?keywords=LED+verte+0805)
D2 | 1 |  | LED verte | RX vert | 0805 | au choix |  |  | Rechercher (https://fr.farnell.com/search?st=LED+verte+0805) | Rechercher (https://fr.rs-online.com/web/c/?searchTerm=LED+verte+0805) | Rechercher (https://www.mouser.fr/c/?q=LED+verte+0805) | Rechercher (https://www.digikey.fr/fr/products/result?keywords=LED+verte+0805)
D3 | 1 |  | LED jaune | TX jaune | 0805 | au choix |  |  | Rechercher (https://fr.farnell.com/search?st=LED+jaune+0805) | Rechercher (https://fr.rs-online.com/web/c/?searchTerm=LED+jaune+0805) | Rechercher (https://www.mouser.fr/c/?q=LED+jaune+0805) | Rechercher (https://www.digikey.fr/fr/products/result?keywords=LED+jaune+0805)
F1 | 1 |  | Fusible réarmable PTC, 500 mA maintenu, 6 V mini | 500mA | 1206 | Bourns | MF-NSMF050-2 | ou tout PTC 1206 0,5 A maintenu, ≥ 6 V | Rechercher (https://fr.farnell.com/search?st=MF-NSMF050-2) | Rechercher (https://fr.rs-online.com/web/c/?searchTerm=MF-NSMF050-2) | Rechercher (https://www.mouser.fr/c/?q=MF-NSMF050-2) | Rechercher (https://www.digikey.fr/fr/products/result?keywords=MF-NSMF050-2)
J1 | 1 |  | Fiche USB type A mâle coudée, pour CI (CNCTech 1001-011-01101) | USB_A | traversant | CNCTech | 1001-011-01101 | branchement direct sur le PC; fiche USB-A mâle coudée ; pattes de blindage dans des fentes de 2,5 × 0,9 mm | Rechercher (https://fr.farnell.com/search?st=1001-011-01101) | Rechercher (https://fr.rs-online.com/web/c/?searchTerm=1001-011-01101) | Rechercher (https://www.mouser.fr/c/?q=1001-011-01101) | Rechercher (https://www.digikey.fr/fr/products/result?keywords=1001-011-01101)
J2 | 1 |  | Bornier à vis 3 points, pas 5,08 mm, pour CI (type Phoenix MKDS 1,5/3-5,08) | Bornier CAN | traversant | Phoenix Contact | MKDS 1,5/ 3-5,08 | bus CAN : H, L, G; tout bornier 3 points au pas de 5,08 mm convient (perçages 1,3 mm) | Rechercher (https://fr.farnell.com/search?st=bornier+a+vis+3+points+5.08mm) | Rechercher (https://fr.rs-online.com/web/c/?searchTerm=bornier+a+vis+3+points+5.08mm) | Rechercher (https://www.mouser.fr/c/?q=bornier+a+vis+3+points+5.08mm) | Rechercher (https://www.digikey.fr/fr/products/result?keywords=bornier+a+vis+3+points+5.08mm)
J3 | 1 |  | Barrette mâle sécable 1 × 4, pas 2,54 mm | SWD | traversant | au choix |  | SWCLK, SWDIO, GND, 3V3; une barrette sécable couvre J3 et JP1 | Rechercher (https://fr.farnell.com/search?st=barrette+secable+male+2.54mm) | Rechercher (https://fr.rs-online.com/web/c/?searchTerm=barrette+secable+male+2.54mm) | Rechercher (https://www.mouser.fr/c/?q=barrette+secable+male+2.54mm) | Rechercher (https://www.digikey.fr/fr/products/result?keywords=barrette+secable+male+2.54mm)
JP1 | 1 |  | Barrette mâle 1 × 2, pas 2,54 mm + cavalier | TERM | traversant | au choix |  | terminaison 120 Ω; + 1 cavalier 2,54 mm | Rechercher (https://fr.farnell.com/search?st=barrette+secable+male+2.54mm) | Rechercher (https://fr.rs-online.com/web/c/?searchTerm=barrette+secable+male+2.54mm) | Rechercher (https://www.mouser.fr/c/?q=barrette+secable+male+2.54mm) | Rechercher (https://www.digikey.fr/fr/products/result?keywords=barrette+secable+male+2.54mm)
R1, R4, R5 | 3 |  | Résistance 1 %, 1/8 W | 1k | 0805 | au choix |  |  | Rechercher (https://fr.farnell.com/search?st=resistance+1k+0805) | Rechercher (https://fr.rs-online.com/web/c/?searchTerm=resistance+1k+0805) | Rechercher (https://www.mouser.fr/c/?q=resistance+1k+0805) | Rechercher (https://www.digikey.fr/fr/products/result?keywords=resistance+1k+0805)
R2 | 1 |  | Résistance 0 Ω (ou strap) | 0R | 0805 | au choix |  | CH340C en mode 3,3 V | Rechercher (https://fr.farnell.com/search?st=resistance+0R+0805) | Rechercher (https://fr.rs-online.com/web/c/?searchTerm=resistance+0R+0805) | Rechercher (https://www.mouser.fr/c/?q=resistance+0R+0805) | Rechercher (https://www.digikey.fr/fr/products/result?keywords=resistance+0R+0805)
R3, R6 | 2 |  | Résistance 1 %, 1/8 W | 10k | 0805 | au choix |  |  | Rechercher (https://fr.farnell.com/search?st=resistance+10k+0805) | Rechercher (https://fr.rs-online.com/web/c/?searchTerm=resistance+10k+0805) | Rechercher (https://www.mouser.fr/c/?q=resistance+10k+0805) | Rechercher (https://www.digikey.fr/fr/products/result?keywords=resistance+10k+0805)
R7 | 1 |  | Résistance 1 %, 1/8 W | 120R | 0805 | au choix |  | terminaison CAN | Rechercher (https://fr.farnell.com/search?st=resistance+120R+0805) | Rechercher (https://fr.rs-online.com/web/c/?searchTerm=resistance+120R+0805) | Rechercher (https://www.mouser.fr/c/?q=resistance+120R+0805) | Rechercher (https://www.digikey.fr/fr/products/result?keywords=resistance+120R+0805)
SW1 | 1 |  | Bouton poussoir CMS 3 × 2,5 mm (Omron B3U-1000P) | RESET | B3U | Omron | B3U-1000P | face avant; bouton CMS 3 × 2,5 mm | Rechercher (https://fr.farnell.com/search?st=B3U-1000P) | Rechercher (https://fr.rs-online.com/web/c/?searchTerm=B3U-1000P) | Rechercher (https://www.mouser.fr/c/?q=B3U-1000P) | Rechercher (https://www.digikey.fr/fr/products/result?keywords=B3U-1000P)
SW2 | 1 |  | Bouton poussoir CMS 3 × 2,5 mm (Omron B3U-1000P) | BOOT0 | B3U | Omron | B3U-1000P | face avant; bouton CMS 3 × 2,5 mm | Rechercher (https://fr.farnell.com/search?st=B3U-1000P) | Rechercher (https://fr.rs-online.com/web/c/?searchTerm=B3U-1000P) | Rechercher (https://www.mouser.fr/c/?q=B3U-1000P) | Rechercher (https://www.digikey.fr/fr/products/result?keywords=B3U-1000P)
U1 | 1 |  | Microcontrôleur STM32G431KBT6, LQFP32 | STM32G431KBT6 | LQFP-32 | STMicroelectronics | STM32G431KBT6 | pas 0,8 mm; boîtier LQFP32 (T6) obligatoire | Rechercher (https://fr.farnell.com/search?st=STM32G431KBT6) | Rechercher (https://fr.rs-online.com/web/c/?searchTerm=STM32G431KBT6) | Rechercher (https://www.mouser.fr/c/?q=STM32G431KBT6) | Rechercher (https://www.digikey.fr/fr/products/result?keywords=STM32G431KBT6)
U2 | 1 |  | Pont USB-UART CH340C, SOIC-16 | CH340C | SOIC-16 | WCH (Nanjing Qinheng) | CH340C | version C : sans quartz externe; peu distribué en France : LCSC (réf. C84681) si absent ailleurs | Rechercher (https://fr.farnell.com/search?st=CH340C) | Rechercher (https://fr.rs-online.com/web/c/?searchTerm=CH340C) | Rechercher (https://www.mouser.fr/c/?q=CH340C) | Rechercher (https://www.digikey.fr/fr/products/result?keywords=CH340C)
U3 | 1 |  | Transceiver CAN TJA1051T/3, SOIC-8 | TJA1051T/3 | SOIC-8 | NXP | TJA1051T/3 | suffixe /3 : broche VIO; suffixe /3 indispensable (broche VIO) | Rechercher (https://fr.farnell.com/search?st=TJA1051T%2F3) | Rechercher (https://fr.rs-online.com/web/c/?searchTerm=TJA1051T%2F3) | Rechercher (https://www.mouser.fr/c/?q=TJA1051T%2F3) | Rechercher (https://www.digikey.fr/fr/products/result?keywords=TJA1051T%2F3)
U4 | 1 |  | Régulateur linéaire 3,3 V AMS1117-3.3, SOT-223 | AMS1117-3.3 | SOT-223 | Advanced Monolithic Systems | AMS1117-3.3 | SOT-223 | Rechercher (https://fr.farnell.com/search?st=AMS1117-3.3) | Rechercher (https://fr.rs-online.com/web/c/?searchTerm=AMS1117-3.3) | Rechercher (https://www.mouser.fr/c/?q=AMS1117-3.3) | Rechercher (https://www.digikey.fr/fr/products/result?keywords=AMS1117-3.3)
U5 | 1 |  | Protection ESD USB USBLC6-2SC6, SOT-23-6 | USBLC6-2SC6 | SOT-23-6 | STMicroelectronics | USBLC6-2SC6 |  | Rechercher (https://fr.farnell.com/search?st=USBLC6-2SC6) | Rechercher (https://fr.rs-online.com/web/c/?searchTerm=USBLC6-2SC6) | Rechercher (https://www.mouser.fr/c/?q=USBLC6-2SC6) | Rechercher (https://www.digikey.fr/fr/products/result?keywords=USBLC6-2SC6)
Y1 | 1 |  | Quartz 8 MHz CMS 5 × 3,2 mm, 2 pastilles | 8MHz | 5032 | au choix |  | noter sa capacité de charge CL; boîtier 5 × 3,2 mm à 2 pastilles ; noter la capacité de charge CL (calcul de C10/C11) | Rechercher (https://fr.farnell.com/search?st=quartz+8+MHz+5032+CMS) | Rechercher (https://fr.rs-online.com/web/c/?searchTerm=quartz+8+MHz+5032+CMS) | Rechercher (https://www.mouser.fr/c/?q=quartz+8+MHz+5032+CMS) | Rechercher (https://www.digikey.fr/fr/products/result?keywords=quartz+8+MHz+5032+CMS)
Total composants
Liens « Rechercher » : recherche de la référence fabricant (ou de la description pour les composants génériques) chez chaque distributeur. Stock et prix non vérifiés. Le guide factory demande de privilégier les composants disponibles au magasin.

Sheet: Fournisseurs
Sites français où commander
Site | Adresse | Usage
Farnell France | https://fr.farnell.com | distributeur professionnel
RS Components France | https://fr.rs-online.com | distributeur professionnel ; proposé dans le ticket GLPI de commande
Mouser France | https://www.mouser.fr | distributeur professionnel
DigiKey France | https://www.digikey.fr | distributeur professionnel
Conrad France | https://www.conrad.fr | passifs, connecteurs, boutons
Gotronic | https://www.gotronic.fr | boutique française, composants courants
LCSC (Chine) | https://www.lcsc.com | fabricant-distributeur du CH340C (réf. C84681), livre en France
Rappel : Amazon Business est refusé par l'école pour les articles non vendus par Amazon (ticket GLPI 0015779).
