xopigun/Projet2A/banc-can/hardware/carte_porteuse/fabrication/carte_porteuse_commande.xlsx

Sheet: Composants
Carte porteuse G69 : composants à commander
Nombre de cartes à produire |  |  | 4 | ← case jaune à modifier (les quantités totales en dépendent)
Repères | Qté / carte | Qté à commander | Désignation | Valeur | Boîtier | Fabricant | Réf. fabricant | Remarque | Farnell France | RS Components France | Mouser France | DigiKey France
C1, C2 | 2 |  | Condensateur céramique X7R 50 V | 100nF | 0805 | au choix |  | découplage VCC et VIO du transceiver | Rechercher (https://fr.farnell.com/search?st=condensateur+ceramique+100nF+0805) | Rechercher (https://fr.rs-online.com/web/c/?searchTerm=condensateur+ceramique+100nF+0805) | Rechercher (https://www.mouser.fr/c/?q=condensateur+ceramique+100nF+0805) | Rechercher (https://www.digikey.fr/fr/products/result?keywords=condensateur+ceramique+100nF+0805)
D1 | 1 |  | LED rouge | ERR rouge | 0805 | Würth Elektronik | 150080RS75000 | error-passive; ou toute LED rouge 0805 | Rechercher (https://fr.farnell.com/search?st=150080RS75000) | Rechercher (https://fr.rs-online.com/web/c/?searchTerm=150080RS75000) | Rechercher (https://www.mouser.fr/c/?q=150080RS75000) | Rechercher (https://www.digikey.fr/fr/products/result?keywords=150080RS75000)
D2 | 1 |  | LED jaune | BUS-OFF jaune | 0805 | Würth Elektronik | 150080YS75000 | bus-off; ou toute LED jaune 0805 | Rechercher (https://fr.farnell.com/search?st=150080YS75000) | Rechercher (https://fr.rs-online.com/web/c/?searchTerm=150080YS75000) | Rechercher (https://www.mouser.fr/c/?q=150080YS75000) | Rechercher (https://www.digikey.fr/fr/products/result?keywords=150080YS75000)
J1 | 1 |  | Bornier à vis 3 points, pas 5,08 mm (type Phoenix MKDS 1,5/3-5,08) | Bus entrée | traversant | Phoenix Contact | MKDS 1,5/ 3-5,08 | bus CAN : H, L, G; tout bornier 3 points au pas de 5,08 mm convient (perçages 1,3 mm) | Rechercher (https://fr.farnell.com/search?st=bornier+a+vis+3+points+5.08mm) | Rechercher (https://fr.rs-online.com/web/c/?searchTerm=bornier+a+vis+3+points+5.08mm) | Rechercher (https://www.mouser.fr/c/?q=bornier+a+vis+3+points+5.08mm) | Rechercher (https://www.digikey.fr/fr/products/result?keywords=bornier+a+vis+3+points+5.08mm)
J2 | 1 |  | Bornier à vis 3 points, pas 5,08 mm (type Phoenix MKDS 1,5/3-5,08) | Bus sortie | traversant | Phoenix Contact | MKDS 1,5/ 3-5,08 | bus CAN : H, L, G; tout bornier 3 points au pas de 5,08 mm convient (perçages 1,3 mm) | Rechercher (https://fr.farnell.com/search?st=bornier+a+vis+3+points+5.08mm) | Rechercher (https://fr.rs-online.com/web/c/?searchTerm=bornier+a+vis+3+points+5.08mm) | Rechercher (https://www.mouser.fr/c/?q=bornier+a+vis+3+points+5.08mm) | Rechercher (https://www.digikey.fr/fr/products/result?keywords=bornier+a+vis+3+points+5.08mm)
J3 | 1 |  | Barrette femelle 1 x 15, pas 2,54 mm | Nucleo CN3 | traversant | au choix |  | reçoit la Nucleo-G431KB; ou barrette femelle sécable coupée à 15 | Rechercher (https://fr.farnell.com/search?st=barrette+femelle+15+points+2.54mm) | Rechercher (https://fr.rs-online.com/web/c/?searchTerm=barrette+femelle+15+points+2.54mm) | Rechercher (https://www.mouser.fr/c/?q=barrette+femelle+15+points+2.54mm) | Rechercher (https://www.digikey.fr/fr/products/result?keywords=barrette+femelle+15+points+2.54mm)
J4 | 1 |  | Barrette femelle 1 x 15, pas 2,54 mm | Nucleo CN4 | traversant | au choix |  | reçoit la Nucleo-G431KB; ou barrette femelle sécable coupée à 15 | Rechercher (https://fr.farnell.com/search?st=barrette+femelle+15+points+2.54mm) | Rechercher (https://fr.rs-online.com/web/c/?searchTerm=barrette+femelle+15+points+2.54mm) | Rechercher (https://www.mouser.fr/c/?q=barrette+femelle+15+points+2.54mm) | Rechercher (https://www.digikey.fr/fr/products/result?keywords=barrette+femelle+15+points+2.54mm)
J5 | 1 |  | Barrette femelle coudée 1 x 4, pas 2,54 mm | OLED coudé | traversant | au choix |  | écran OLED SSD1306 0,96" debout au bord avant; coudée à 90° : l'écran tient debout | Rechercher (https://fr.farnell.com/search?st=barrette+femelle+coudee+4+points+2.54mm) | Rechercher (https://fr.rs-online.com/web/c/?searchTerm=barrette+femelle+coudee+4+points+2.54mm) | Rechercher (https://www.mouser.fr/c/?q=barrette+femelle+coudee+4+points+2.54mm) | Rechercher (https://www.digikey.fr/fr/products/result?keywords=barrette+femelle+coudee+4+points+2.54mm)
J6 | 1 |  | Barrette femelle coudée 1 x 8, pas 2,54 mm | MPU-6050 coudé | traversant | au choix |  | module GY-521 debout au bord gauche, N2 seulement; coudée à 90° ; N2 seulement | Rechercher (https://fr.farnell.com/search?st=barrette+femelle+coudee+8+points+2.54mm) | Rechercher (https://fr.rs-online.com/web/c/?searchTerm=barrette+femelle+coudee+8+points+2.54mm) | Rechercher (https://www.mouser.fr/c/?q=barrette+femelle+coudee+8+points+2.54mm) | Rechercher (https://www.digikey.fr/fr/products/result?keywords=barrette+femelle+coudee+8+points+2.54mm)
J7 | 1 |  | Barrette mâle 1 x 2, pas 2,54 mm + cavalier | TERM | traversant | au choix |  | terminaison 120 ohms ; sur N4, câblée vers SW1; + 1 cavalier 2,54 mm (N4 : câble vers SW1) | Rechercher (https://fr.farnell.com/search?st=barrette+secable+male+2.54mm) | Rechercher (https://fr.rs-online.com/web/c/?searchTerm=barrette+secable+male+2.54mm) | Rechercher (https://www.mouser.fr/c/?q=barrette+secable+male+2.54mm) | Rechercher (https://www.digikey.fr/fr/products/result?keywords=barrette+secable+male+2.54mm)
R1 | 1 |  | Résistance 1 %, 1/8 W | 120R | 0805 | au choix |  | terminaison CAN, active avec un cavalier sur TERM | Rechercher (https://fr.farnell.com/search?st=resistance+120R+0805) | Rechercher (https://fr.rs-online.com/web/c/?searchTerm=resistance+120R+0805) | Rechercher (https://www.mouser.fr/c/?q=resistance+120R+0805) | Rechercher (https://www.digikey.fr/fr/products/result?keywords=resistance+120R+0805)
R2, R3 | 2 |  | Résistance 1 %, 1/8 W | 1k | 0805 | au choix |  | LED | Rechercher (https://fr.farnell.com/search?st=resistance+1k+0805) | Rechercher (https://fr.rs-online.com/web/c/?searchTerm=resistance+1k+0805) | Rechercher (https://www.mouser.fr/c/?q=resistance+1k+0805) | Rechercher (https://www.digikey.fr/fr/products/result?keywords=resistance+1k+0805)
R7, R9, R10 | 3 |  | Résistance 0 ohm (ou strap) | 0R | 0805 | au choix |  | R7 : broche S à la masse ; R9, R10 : ordre GND/VCC de l'OLED (à vérifier) | Rechercher (https://fr.farnell.com/search?st=resistance+0R+0805) | Rechercher (https://fr.rs-online.com/web/c/?searchTerm=resistance+0R+0805) | Rechercher (https://www.mouser.fr/c/?q=resistance+0R+0805) | Rechercher (https://www.digikey.fr/fr/products/result?keywords=resistance+0R+0805)
U1 | 1 |  | Transceiver CAN TJA1051T/3, SOIC-8 | TJA1051T/3 | SOIC-8 | NXP | TJA1051T/3 | suffixe /3 : broche VIO (3,3 V); 6 en stock (10 reçus, 4 sur les adaptateurs SOP8) : rien à commander pour 4 cartes | Rechercher (https://fr.farnell.com/search?st=TJA1051T%2F3) | Rechercher (https://fr.rs-online.com/web/c/?searchTerm=TJA1051T%2F3) | Rechercher (https://www.mouser.fr/c/?q=TJA1051T%2F3) | Rechercher (https://www.digikey.fr/fr/products/result?keywords=TJA1051T%2F3)
Total composants
Liens « Rechercher » : recherche de la référence fabricant (ou de la description pour les composants génériques) chez chaque distributeur. Stock et prix non vérifiés. Le guide factory demande de privilégier les composants disponibles au magasin.

Sheet: Fournisseurs
Sites français où commander
Site | Adresse | Usage
Farnell France | https://fr.farnell.com | distributeur professionnel
RS Components France | https://fr.rs-online.com | distributeur professionnel ; proposé dans le ticket GLPI de commande
Mouser France | https://www.mouser.fr | distributeur professionnel
DigiKey France | https://www.digikey.fr | distributeur professionnel
Conrad France | https://www.conrad.fr | passifs, connecteurs, boutons
Gotronic | https://www.gotronic.fr | boutique française, composants courants
LCSC (Chine) | https://www.lcsc.com | fabricant-distributeur du CH340C (réf. C84681), livre en France
Rappel : Amazon Business est refusé par l'école pour les articles non vendus par Amazon (ticket GLPI 0015779).
