xopigun/Projet2A/banc-can/hardware/adaptateur_usb_can/boitier/fond.stl

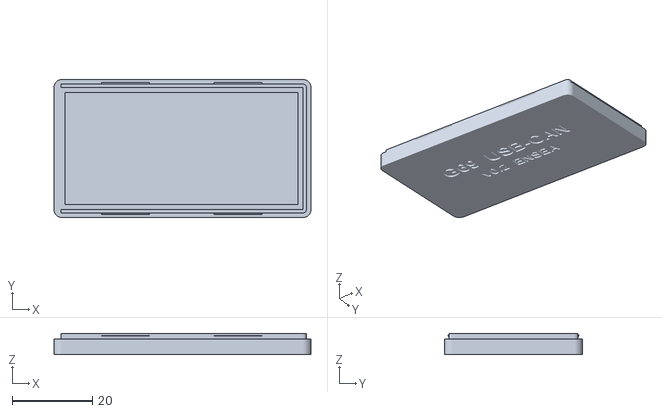
[picture p36: CAD file, 2026-11-13]
banc-can/hardware/adaptateur_usb_can/boitier/fond.stl
64.0 x 34.4 x 5.30
