xopigun/Projet2A/banc-can/hardware/adaptateur_usb_can/boitier/capot.stl

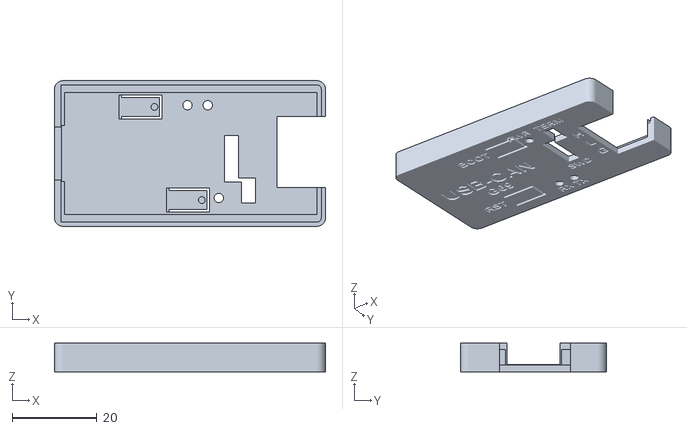
[picture p37: CAD file, 2026-11-13]
banc-can/hardware/adaptateur_usb_can/boitier/capot.stl
64.0 x 34.4 x 6.80
