xopigun/Projet2A/banc-can/hardware/adaptateur_usb_can/boitier/boitier_X1C_PLA.3mf

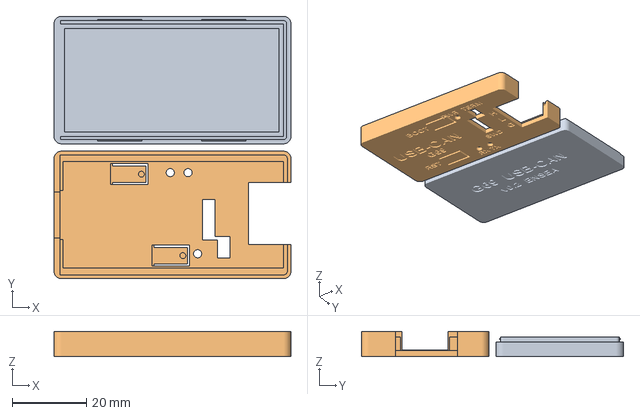
[picture p38: CAD file, 2026-11-13]
banc-can/hardware/adaptateur_usb_can/boitier/boitier_X1C_PLA.3mf
64.0 x 70.8 x 6.80 mm
fond.stl
capot.stl
