xopigun/Projet2A/Dossier_Banc_Test_CAN_v0.1.pdf

ENSEA 2e année MANAGEMENT_PROJET_S7

Projet 2A Conception d'une Électronique Modulaire (Bus CAN)

# Dossier de dénition

### Banc de test CAN

Référence | G69-BANC-001
Version | v0.1
Date | 22/09/2026
Statut | Brouillon schémas uniquement
Groupe | 69
Auteurs | Samuel GOMRI, Dylan KIATI, Hugo MATHOUX
Encadrants | Yves HECKEL, Julien SEIGNEURBIEUX

Documents liés ICD des groupes partenaires (documents distincts, cycles de vie propres)

Ce document décrit l'outil interne du groupe 69 servant à valider le standard CAN commun et les ICD produits avec les groupes partenaires. Il est distinct des ICD : ceux-ci décrivent l'interface convenue avec chaque projet, tandis que le présent dossier dénit le moyen de la vérier. Le banc est générique et ne privilégie aucun projet : chaque groupe partenaire est traité au même niveau, les besoins spéciques étant couverts par des variantes de conguration et non par une conception dédiée. Document vivant, versionné à chaque évolution.

Banc de test CAN Dossier de dénition | G69-BANC-001 v0.1

## Contents

1 Objet et périmètre | 1
2 Architecture de principe | 1
3 Nomenclature | 2
4 Schémas électriques | 2
5 Tableau de câblage | 7
6 Conguration logicielle minimale | 7
7 Protocole de validation | 7
8 Historique des versions | 7
Groupe 69 ENSEA 2A | Page i/7

## 1 Objet et périmètre

[À rédiger : rédaction complète du périmètre]
| Le banc de test doit permettre de démontrer les six fonctions suivantes, qui structurent le pro-
tocole de validation (7) :
1. Validation de la couche physique (niveaux diérentiels, terminaisons, débit 500 kbit/s) ;
2. Démonstration de l'arbitrage entre au moins trois n÷uds émetteurs simultanés ;
3. Validation de l'encodage des messages dénis dans l'ICD ;
4. Tests de robustesse par injection de fautes ;
5. Démonstration pédagogique à destination de l'ensemble des groupes partenaires, sans distinc-
| tion de projet ;
6. Validation de l'isolation galvanique, pour toute intégration à proximité d'électronique de puis-
| sance.
2 | Architecture de principe

Le banc est constitué d'un noyau fonctionnel (n÷uds + couche physique + câblage) sur lequel se greent des équipements de mesure et de visualisation branchés en dérivation.

2.1 Schéma bloc

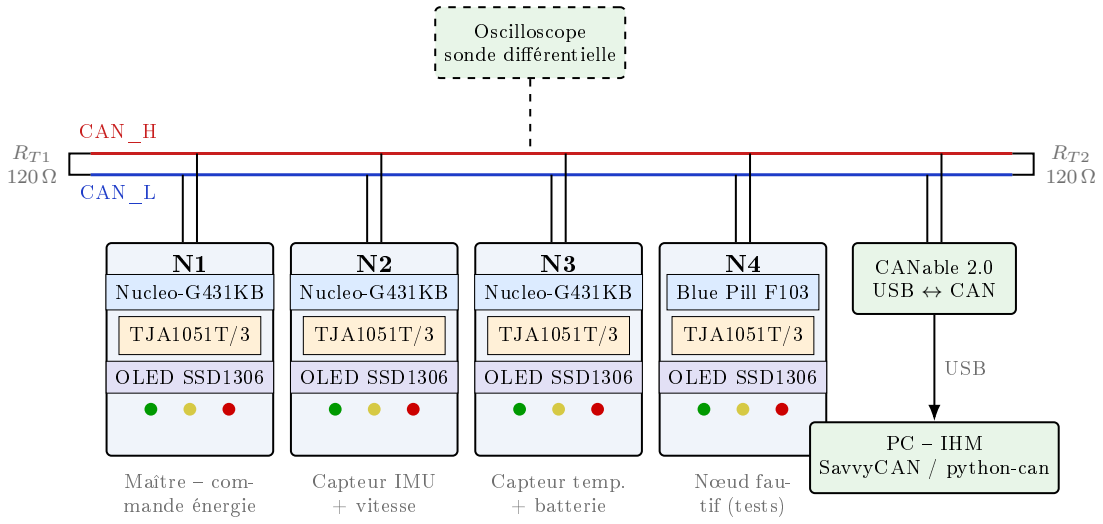
[picture p39: figure]
CAN_H; CAN_L; Nucleo-G431KB; TJA1051T/3; OLED SSD1306; Maître  com- mande énergie; Capteur IMU + vitesse; Capteur temp. + batterie; Blue Pill F103; N÷ud fau- tif (tests); CANable 2.0 USB ↔ CAN; PC  IHM SavvyCAN / python-can; USB; Oscilloscope sonde diérentielle

Légende | CAN_H | CAN_L | MCU | Transceiver
IHM locale (écran) | • TX • erreur • bus-o | Instrument branché en dérivation

Figure 1: Architecture de principe du banc : quatre n÷uds sur un bus terminé aux deux extrémités. Chaque n÷ud porte sa propre IHM locale (écran et LEDs) ; instrumentation et IHM PC sont en dérivation.

2.2 Principe de lecture

Chaque n÷ud est composé d'un microcontrôleur (contrôleur CAN intégré) et d'un transceiver qui réalise l'interface électrique avec le bus.
Le bus est une paire torsadée terminée par 120 Ω à chacune de ses deux extrémités, et uniquement là.
Groupe 69 ENSEA 2A | Page 1/7

Le snier CANable est un n÷ud passif supplémentaire : il acquitte les trames mais n'en émet pas hors phases d'injection volontaire.
L'oscilloscope observe le signal diérentiel sans charger le bus.

2.3 Choix des composants structurants

Microcontrôleur STM32 (Nucleo-G431KB), aligné sur la cible des groupes partenaires. Le périphérique FDCAN est conguré en mode Classic (CAN 2.0A, identiants 11 bits, 500 kbit/s) ; la capacité CAN FD reste disponible sans changement matériel.
Transceiver TJA1051T/3 : alimentation VCC = 5 V pour des niveaux diérentiels conformes ISO 11898-2, broche VIO = 3,3 V pour une interface logique directe avec le STM32 sans adaptation de niveau. Ce choix répond au point soulevé par l'encadrement sur la tension d'alimentation.

## 3 Nomenclature

[À rédiger : BOM détaillée par lot avec références fournisseur et coûts]

## 4 Schémas électriques

4.1 Schéma type d'un n÷ud (Nucleo-G431KB + TJA1051T/3)

Le schéma ci-dessous est identique pour N1, N2 et N3. Le n÷ud N4 (Blue Pill STM32F103) suit le même principe avec les broches PA11/PA12 du bxCAN.

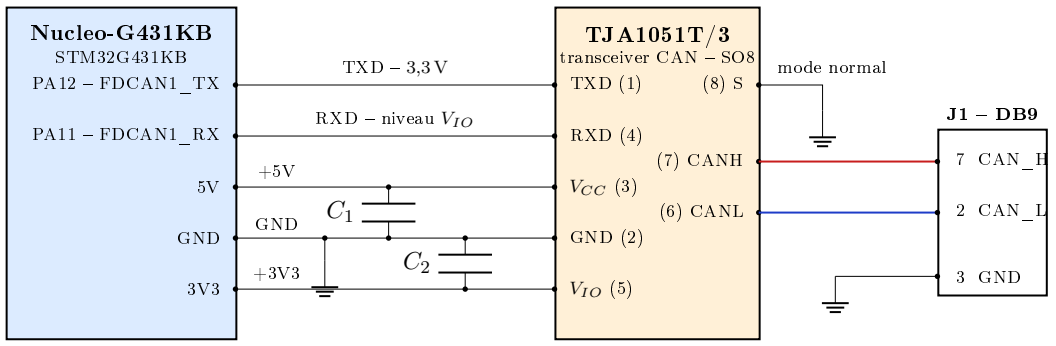
[picture p40: figure]
Nucleo-G431KB; STM32G431KB; PA12  FDCAN1_TX; PA11  FDCAN1_RX; GND; TJA1051T/3; transceiver CAN  SO8; TXD (1); RXD (4); VCC (3); GND (2); VIO (5); (7) CANH; (6) CANL; TXD  3,3 V; RXD  niveau VIO; mode normal; 7 CAN_H; 2 CAN_L; 3 GND

Figure 2: Schéma électrique d'un n÷ud : le STM32 dialogue en 3,3 V avec le transceiver via VIO ; le transceiver est alimenté en 5 V côté bus. Broche S à la masse pour le mode normal (haute vitesse).

Nucleo-G431KB | TJA1051T/3 | Fonction | Remarque
PA12 (FDCAN1_TX) | 1 TXD | Données MCU → bus | niveau 3,3 V
PA11 (FDCAN1_RX) | 4 RXD | Données bus → MCU | niveau VIO
3V3 | 5 VIO | Référence logique | xe le seuil TXD/RXD
5V | 3 VCC | Alimentation étage bus | 4,5 V à 5,5 V
GND | 2 GND | Masse commune | reliée au GND du bus (DB9-3)
| 8 S | Sélection de mode | à GND = normal ; à VIO = silencieux
| 7 CANH | Bus | DB9 broche 7
| 6 CANL | Bus | DB9 broche 2

Table 1: Correspondance des broches pour un n÷ud. Les repères Arduino Nano des broches PA11/PA12 sur la Nucleo-32 sont à conrmer sur le manuel UM2397 avant câblage.

Points de conception.
La broche S permet, si elle est reliée à une GPIO au lieu de GND, de placer le n÷ud en mode silencieux (écoute seule) par logiciel : utile pour le protocole de validation (n÷ud témoin) sans recâblage.
Les condensateurs de découplage C1 (sur VCC) et C2 (sur VIO) valent 100 nF chacun et sont placés au plus près des broches du transceiver.
Le 5 V peut être pris sur la broche 5V du Nucleo (alimenté par USB) ou sur le rail 5 V du banc (4.3). Ne pas connecter les deux sources simultanément.

4.2 Schéma du bus complet

CAN_H

CAN_L

RT1 120 Ω | RT2 120 Ω
J1 DB9 | J2 DB9 | J3 DB9 | J4 DB9 | J5 DB9
N1 | N2 | N3 | N4 | CANable

longueur totale L ≤ 5 m (banc) Lmax = 100 m à 500 kbit/s

stubs ≤ 0,3 m

Blindage / GND de référence relié à la masse en un seul point

Figure 3: Topologie du bus : ligne principale terminée aux deux extrémités, cinq points de raccordement en dérivation courte. Le CANable occupe le dernier connecteur.

Brochage DB9 (CiA 303-1). Tous les connecteurs du banc utilisent le même brochage an qu'un n÷ud puisse être branché sur n'importe quel point sans risque d'erreur.

Broche DB9 | Signal | Couleur préconisée
2 | CAN_L | bleu
3 | GND (référence) | noir
7 | CAN_H | rouge (ou blanc)
9 | +5V (optionnel, alimentation d'un n÷ud) | rouge
1, 4, 5, 6, 8 | non connectés |

Table 2: Brochage des connecteurs J1 à J5.

Règles de topologie.
Deux terminaisons exactement, aux deux extrémités physiques de la ligne.
Dérivations (stubs) les plus courtes possible ; aucun n÷ud en bout de stub long .
Le blindage du câble est relié à la masse en un seul point (éviter les boucles de masse) ; ce point est à reprendre au cas par cas lors de chaque intégration (isolation galvanique).

4.3 Distribution d'alimentation

Bilan de puissance (ordre de grandeur). Les valeurs ci-dessous sont des estimations à con-rmer par la mesure lors de la recette du banc.

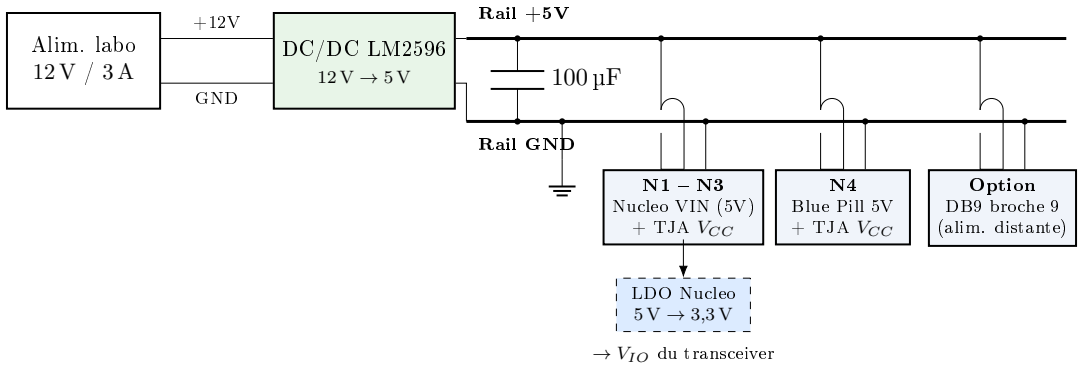
[picture p41: figure]
Alim. labo 12 V / 3 A; GND; Rail +5V; Rail GND; N1  N3 Nucleo VIN (5V) + TJA VCC; N4 Blue Pill 5V + TJA VCC; Option DB9 broche 9 (alim. distante); LDO Nucleo 5 V → 3,3 V; → VIO du transceiver

Figure 4: Distribution d'alimentation : un rail 5 V unique issu d'un convertisseur DC/DC, le 3,3 V de chaque n÷ud est produit localement par le régulateur de sa carte.

Consommateur | Courant typ. | Qté | Total
Nucleo-G431KB (5 V) | 60 mA | 3 | 180 mA
Blue Pill F103 (5 V) | 40 mA | 1 | 40 mA
TJA1051T/3 en émission | 50 mA | 4 | 200 mA
Capteurs (IMU, Hall, DS18B20) | 20 mA | | 40 mA
Total estimé | ≈ 0,5 A

Table 3: Bilan de puissance : un convertisseur 2 A ore une marge confortable.

Règles.
Un n÷ud est alimenté soit par le rail 5 V du banc (VIN), soit par son USB (programmation/débogage), jamais les deux à la fois. Sur Nucleo, retirer le cavalier idoine si les deux sources doivent coexister (voir UM2397).
Masse unique : le GND du rail d'alimentation est aussi le GND de référence du bus (DB9 broche 3).
Pour l'étude d'isolation galvanique, un n÷ud sera doté d'un transceiver isolé (ISO1050 / ADM3053) avec alimentation séparée ; cette variante sera ajoutée en v0.1+1.

4.4 Circuit d'injection de fautes

Trois interrupteurs à bascule permettent de reproduire les défauts les plus courants d'un bus CAN sans démonter le banc. Ils sont regroupés sur un boîtier de commande à l'extrémité RT2.

Rep. | Faute simulée | Position nominale | Eet attendu (à mesurer)
SW1 | Perte d'une terminaison | fermé | Dégradation du signal, hausse du taux d'erreur
SW2 | Court-circuit CAN_H/CAN_L | ouvert | Erreurs de bit, passage des n÷uds en bus-o
SW3 | Retrait d'un n÷ud à chaud | fermé | Le reste du bus continue de fonctionner

Table 4: Fonctions d'injection de fautes. Les critères de réussite sont détaillés au 7.

Précautions. SW2 ne doit être fermé que brièvement : le TJA1051T/3 est protégé contre les courts-circuits sur le bus (limitation de courant interne) mais le maintien prolongé échaue le composant. Ne jamais actionner SW2 pendant que le n÷ud isolé galvaniquement (variante future) est sous tension côté puissance.

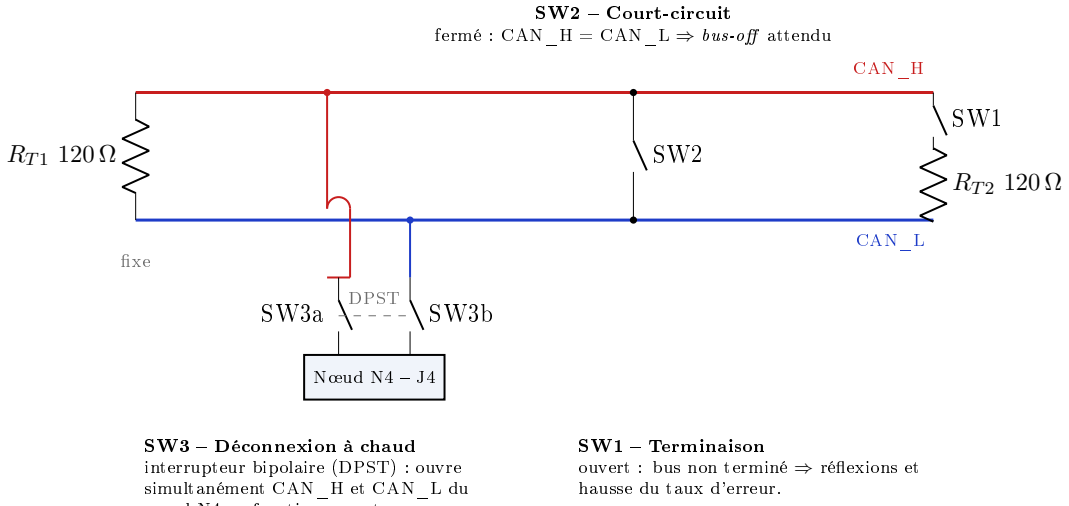
[picture p42: figure]
CAN_H; CAN_L; SW3b DPST; SW2  Court-circuit fermé : CAN_H = CAN_L ⇒ bus-o attendu; SW3  Déconnexion à chaud interrupteur bipolaire (DPST) : ouvre simultanément CAN_H et CAN_L du; SW1  Terminaison ouvert : bus non terminé ⇒ réexions et hausse du taux d'erreur.

n÷ud N4 en fonctionnement.

Figure 5: Circuit d'injection de fautes : SW1 retire la terminaison RT2, SW2 court-circuite les deux lignes, SW3 (bipolaire) déconnecte le n÷ud N4 en fonctionnement.

4.5 IHM locale d'un n÷ud

Chaque n÷ud porte son propre acheur et ses propres indicateurs. Cette IHM locale est ce qui permet de prouver qu'un n÷ud donné a bien reçu et décodé un message : l'IHM PC, branchée en dérivation, ne démontre que le passage de la trame sur le bus.

+3V3 (Rp 4,7 kW si absentes des modules)

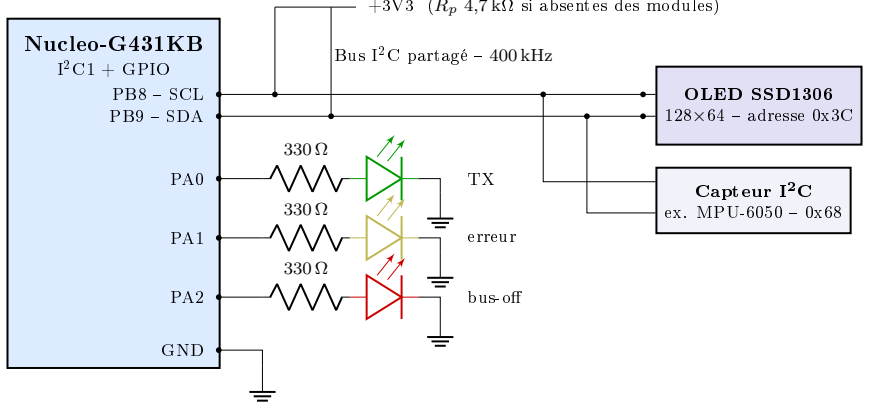
[picture p43: figure]
Nucleo-G431KB; 2C1 + GPIO; PB8  SCL PB9  SDA; GND; Bus I²C partagé  400 kHz; OLED SSD1306 128×64  adresse 0x3C; Capteur I²C ex. MPU-6050  0x68; erreur; bus-o

Figure 6: IHM locale : l'écran OLED partage le bus I²C avec le capteur du n÷ud (adresses distinctes), ce qui ne consomme aucune broche supplémentaire. Trois LEDs donnent l'état en temps réel.

Contenu aché. L'écran est organisé en trois zones, dont le contenu constitue la preuve visuelle recherchée pour chaque test du 7 :

Zone | Contenu | Ce que cela démontre
Identité | Nom du n÷ud, débit, état du
| contrôleur (error-active / error-
| passive / bus-o ) | Le n÷ud est conguré comme prévu et
| | son état d'erreur est observable sans PC
Dernier reçu | Identiant, octets bruts, puis
| valeur décodée selon l'ICD | L'encodage octet par octet de l'ICD est
| | correct de bout en bout
Compteurs | Trames émises et reçues, TEC,
| REC, arbitrages perdus, ARM
| reçus | Comportement cumulé : arbitrage et
| | gestion d'erreur

Table 5: Organisation de l'achage local.

Sources des informations. L'état du contrôleur et les compteurs d'erreur TEC/REC sont lus directement dans les registres du périphérique FDCAN (registres PSR et ECR) : aucune logique de comptage n'est à écrire, ce qui garantit que l'achage reète le comportement réel du matériel et non une interprétation logicielle.

Contrainte de temps d'exécution. Le rafraîchissement d'une image complète en I²C à 400 kHz demande environ 10 ms, soit l'équivalent d'une vingtaine de trames à 500 kbit/s. Le rafraîchissement ne doit donc jamais être eectué dans la routine d'interruption de réception : celle-ci se limite à recopier la trame dans un tampon, la boucle principale rafraîchissant l'écran à cadence xe (5 Hz to 10 Hz). Faute de quoi la le de réception déborde et le banc mesure ses propres défauts logiciels au lieu du comportement du bus.

4.6 Protocole de synchronisation ARM/GO

Pour que le test d'arbitrage ait valeur de preuve, les n÷uds contendants doivent émettre réellement au même instant. Trois programmes indépendants émettant à peu près en même temps ne démontrent rien.
La synchronisation est obtenue par le bus lui-même, sans aucun signal externe, en exploitant une propriété du contrôleur CAN : lorsque plusieurs n÷uds ont une trame en attente dans leur boîte d'émission alors que le bus est occupé, tous démarrent leur émission au même bit dès que le bus redevient libre, après les trois bits d'intermission. L'alignement est réalisé par le matériel, pas par le logiciel.

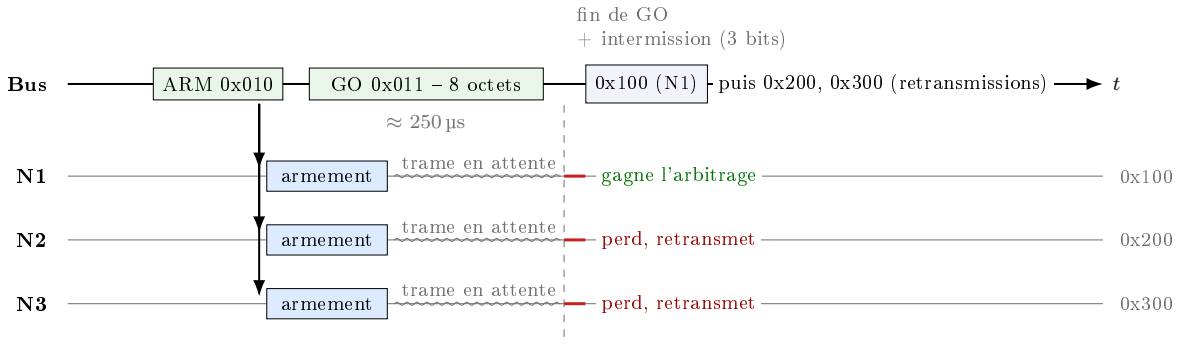
[picture p44: figure]
Bus; ARM 0x010; GO 0x011  8 octets; n de GO + intermission (3 bits); puis 0x200, 0x300 (retransmissions); armement; trame en attente; gagne l'arbitrage; perd, retransmet

Les trois n÷uds arment leur émission pendant que la trame GO occupe le bus. La durée de GO (≈ 250 µs) est supérieure de deux ordres de grandeur à la latence d'interruption, ce qui garantit que tous sont armés avant la libération du bus. Le départ simultané est alors imposé par le
matériel.

Figure 7: Protocole ARM/GO : la trame GO sert de fenêtre d'occupation du bus, pendant laquelle les contendants arment leur émission. L'arbitrage qui suit est donc réel.

Identiant | Nom | Rôle
0x010 | ARM | Ordre d'armement. À sa réception, chaque contendant
place sa trame de test dans sa boîte d'émission et incrémente son compteur ARM reçus.
0x011 | GO | Trame de 8 octets sans contenu utile : elle occupe le
bus le temps que tous les contendants aient armé.

Table 6: Identiants de service à réserver. Ces deux identiants doivent être déclarés comme réservés dans les ICD, faute de quoi un groupe partenaire pourrait les réutiliser pour un signal applicatif.

Contrôle de validité du test. Si un n÷ud arme trop tard (interruption masquée, traitement bloquant), il rate la fenêtre et émet seul juste après : il apparaîtrait alors comme vainqueur sans avoir aronté personne, et le résultat serait faux sans que rien ne le signale. La parade est le compteur ARM reçus aché sur chaque écran : avant de lire le classement, on vérie que tous les contendants achent la même valeur. En cas d'écart, le test est invalide et doit être rejoué.

Résultat attendu. Après 1000 cycles, les acheurs doivent montrer un classement conforme à l'ordre des identiants, l'identiant le plus faible étant le plus prioritaire :

N÷ud | Identiant | Gagnés | Perdus | ARM reçus
N1 | 0x100 | 1000 | 0 | 1000
N2 | 0x200 | 0 | 1000 | 1000
N3 | 0x300 | 0 | 1000 | 1000

Table 7: Résultat attendu du test d'arbitrage. Tout écart sur la colonne ARM reçus invalide le test.

Réutilisabilité. Le protocole ARM/GO n'utilise que des trames CAN standard et aucun signal hors bus. Il constitue donc une brique que les groupes partenaires peuvent reprendre telle quelle pour vérier l'arbitrage sur leur propre réseau.

## 5 Tableau de câblage

[À rédiger : tableau exhaustif broche à broche pour les cinq connecteurs et le boîtier de fautes]

## 6 Conguration logicielle minimale

[À rédiger : paramètres FDCAN pour 500 kbit/s en mode Classic (horloge, prescaler, segments), broches, bibliothèque HAL]

## 7 Protocole de validation

[À rédiger : sept tests au format objectif / montage / procédure / critère de réussite / résultat]

8 | Historique des versions
Version | Date | Modications
v0.1 | 22/09/2026 | Création. Architecture de principe et schémas électriques (2, 4). Autres sections en squelette.
