xopigun/Projet2A/banc-can/hardware/adaptateur_usb_can/fabrication/schema.pdf

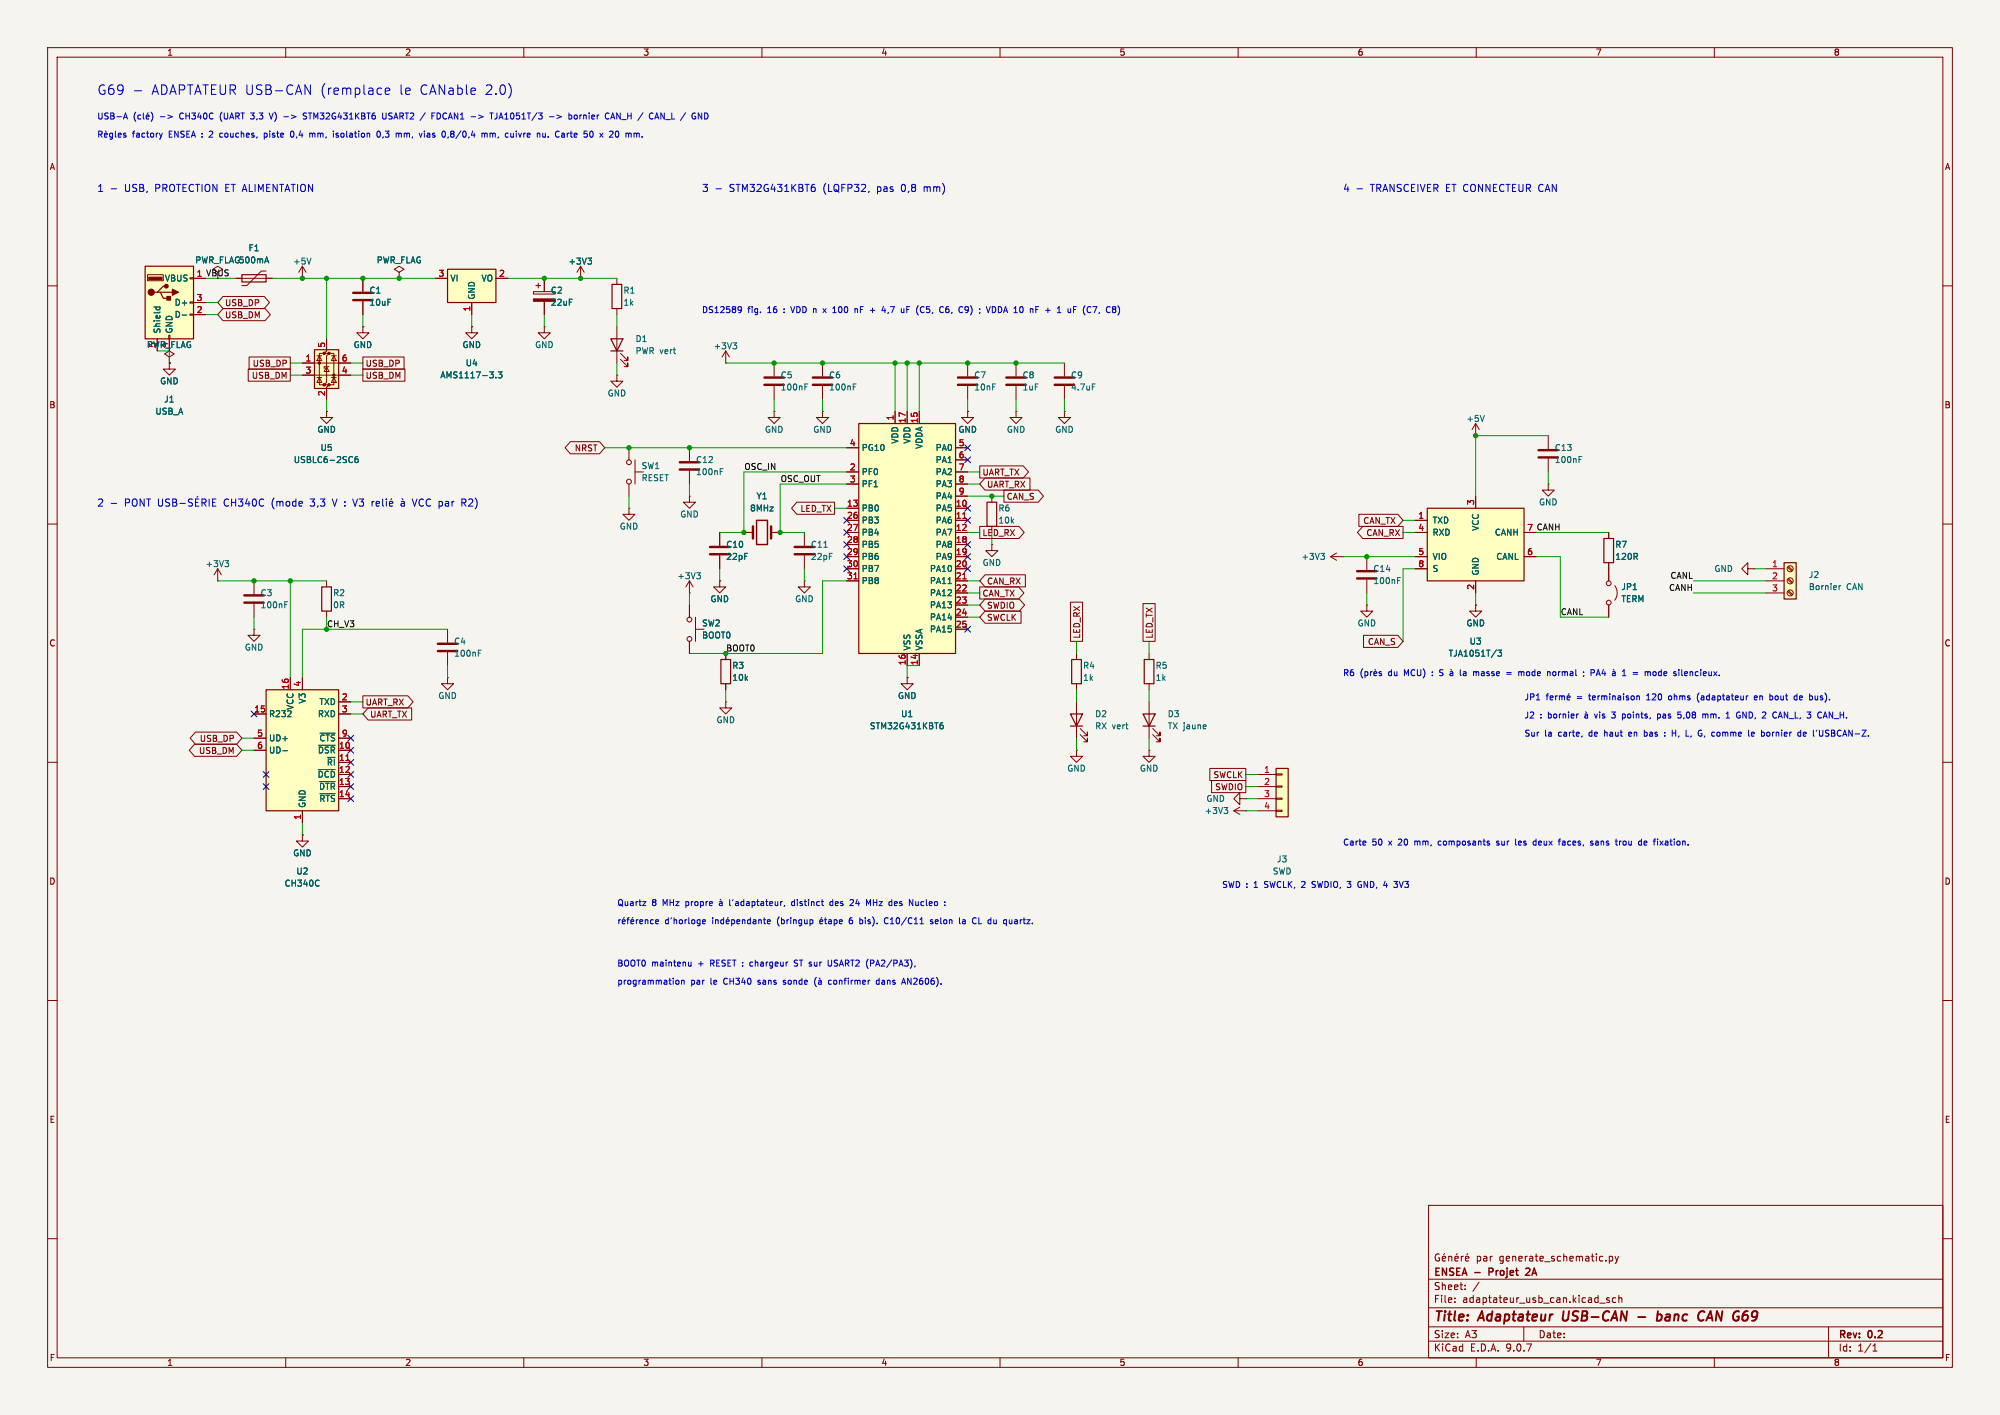
[picture p48: page 1]

2 - PONT þÿUSB-SÉRIE CH340C (mode 3,3 V : V3 þÿrelié þÿàVCC par R2) 1 - USB, PROTECTION ET ALIMENTATION

DS12589 fig. 16 : VDD n x 100 nF + 4,7 uF (C5, C6, C9) ; VDDA 10 nF + 1 uF (C7, C8)

1 VDD 17 VSS 16 VDDA 15 VSSA 14 PA0 5 PA1 6 PA2 7 PA3 8 PA4 9 PA5 10 PA6 11 PA7 12 PA8 18 PA9 19 PA10 20 PA11 21 PA12 22 PA13 23 PA14 24 PA15 25 U1 STM32G431KBT6 GND

1 VDD 17 VSS 16 VDDA 15 VSSA 14 PA0 5 PA1 6 PA2 7 PA3 8 PA4 9 PA5 10 PA6 11 PA7 12 PA8 18 PA9 19 PA10 20 PA11 21 PA12 22 PA13 23 PA14 24 PA15 25GND

1 TXD 2 RXD 3 ~{CTS}9 ~{DSR} 10 ~{RI} 11 ~{DCD} 12 ~{DTR} 13 ~{RTS} 14 SW2 BOOT0 R3

1 TXD 2 RXD 3 ~{CTS}9 ~{DSR} 10 ~{RI} 11 ~{DCD} 12 ~{DTR} 13 ~{RTS} 14 U2 CH340C

SWD : 1 SWCLK, 2 SWDIO, 3 GND, 4 3V3

Id: 1/1 Title: Adaptateur USB-CAN - banc CAN G69
