xopigun/Projet2A/banc-can/hardware/carte_porteuse/fabrication/pcb_echelle_1.pdf

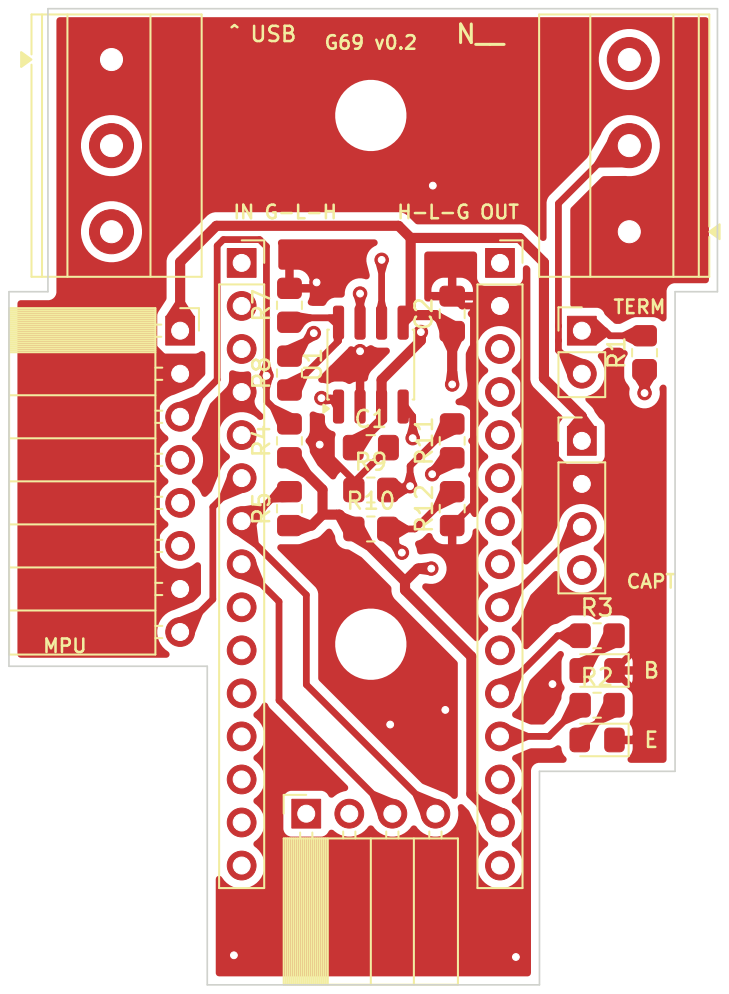
[picture p49: page 1]
D Date: KiCad; E.D.A. 9.0.7 Size: A4; Rev:; N__ MPU; ^ USB; TERM; OUT; CAPT R¹¹ R⁷; R¹²R10 C1

Id: 1/1 Title: File: carte_porteuse.kicad_pcb Sheet:

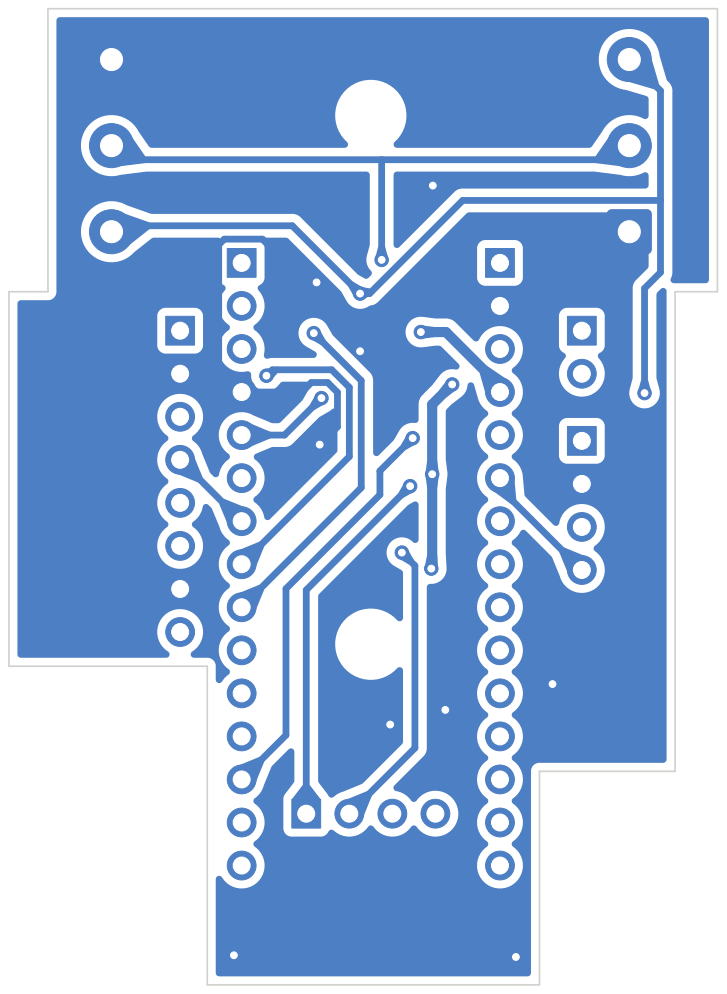
[picture p50: page 2]
D Date: KiCad; E.D.A. 9.0.7 Size: A4; Rev:

Id: 1/1 Title: File: carte_porteuse.kicad_pcb Sheet:
