xopigun/Projet2A/banc-can/hardware/carte_porteuse/fabrication/schema.pdf

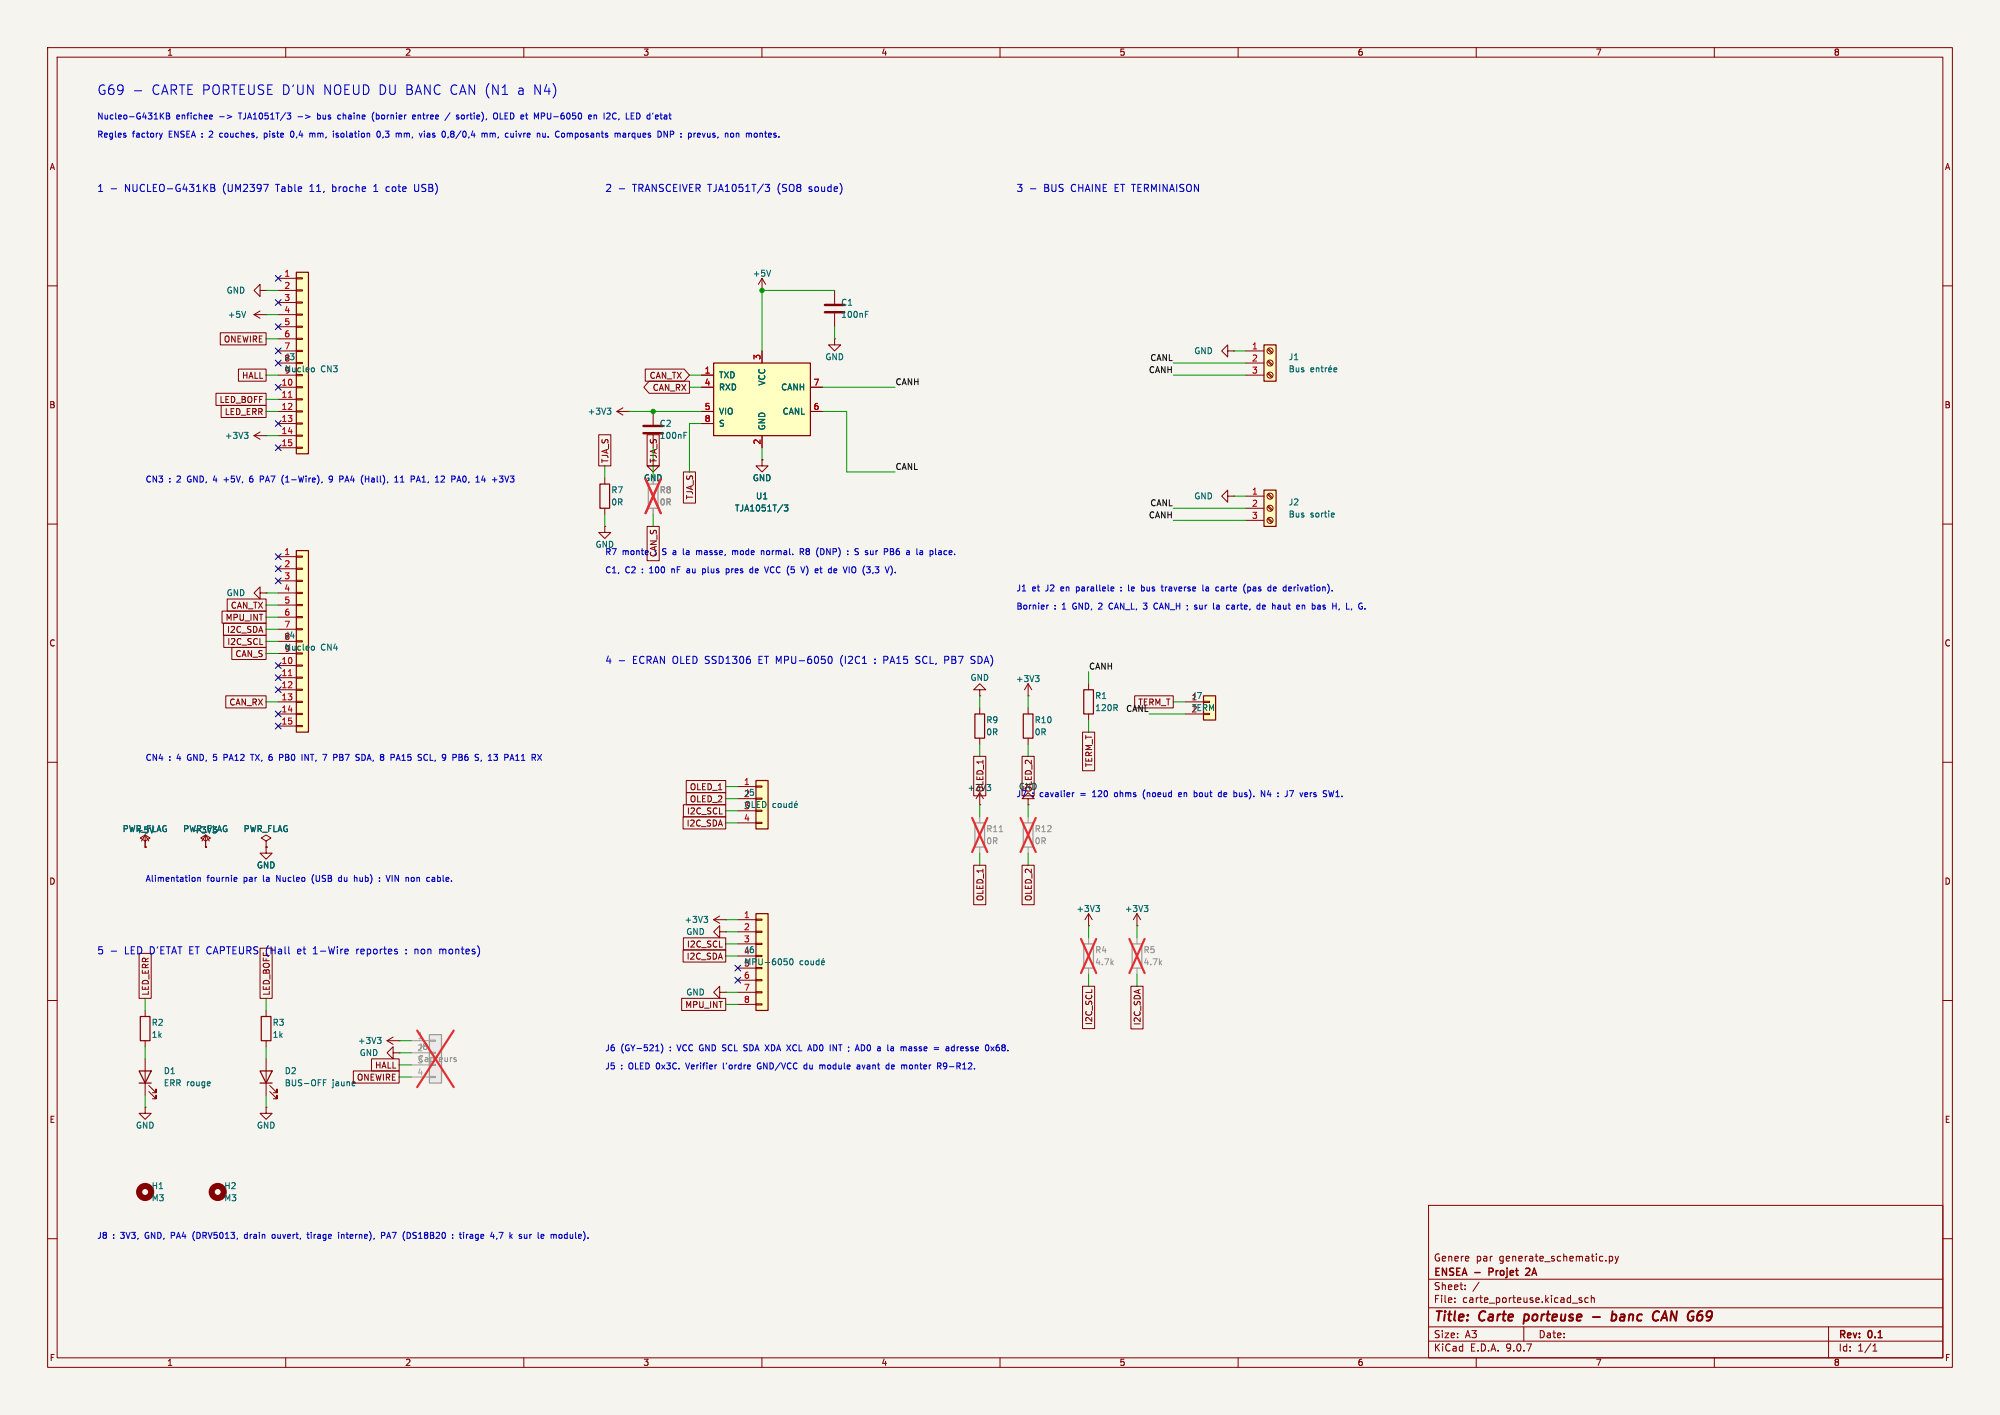
[picture p51: page 1]

3 - BUS CHAINE ET TERMINAISON

2 CANH 7 CANL 6 GND GND GND

Id: 1/1 Title: Carte porteuse - banc CAN G69
