xopigun/Projet2A/banc-can/hardware/adaptateur_usb_can/fabrication/pcb_echelle_1.pdf

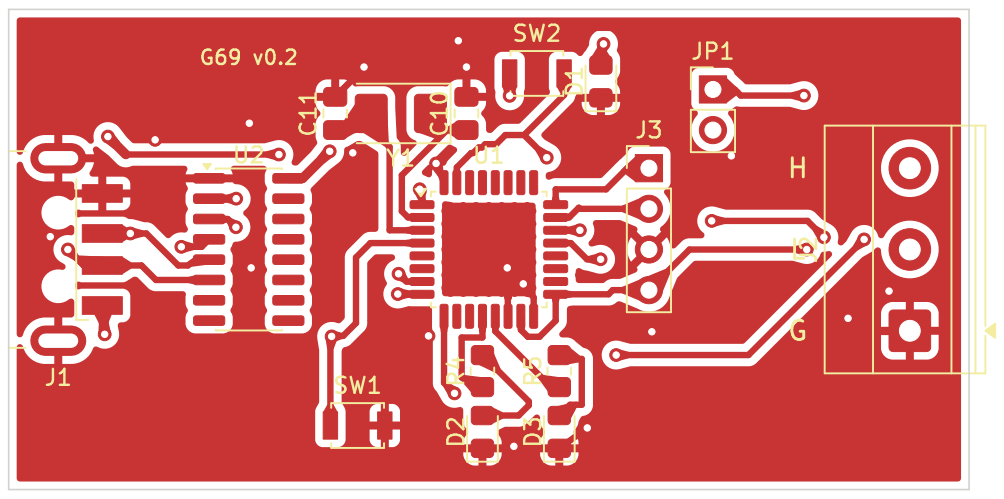
[picture p52: page 1]

Id: 1/1 Title: File: adaptateur_usb_can.kicad_pcb Sheet: G

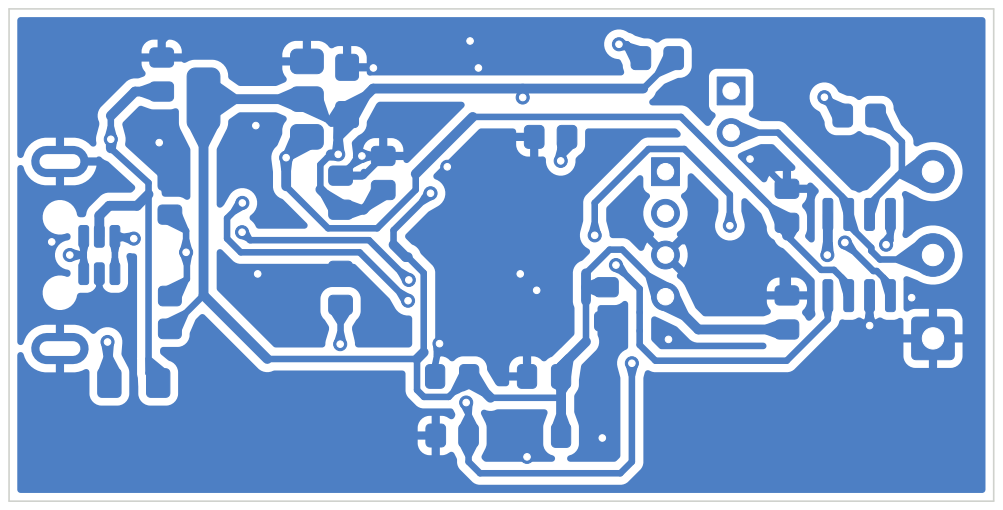
[picture p53: page 2]
D Date: KiCad; E.D.A. 9.0.7 Size: A4; Rev:

Id: 1/1 Title: File: adaptateur_usb_can.kicad_pcb Sheet:
