xopigun/Projet2A/banc-can/hardware/adaptateur_usb_can/fabrication/implantation.pdf

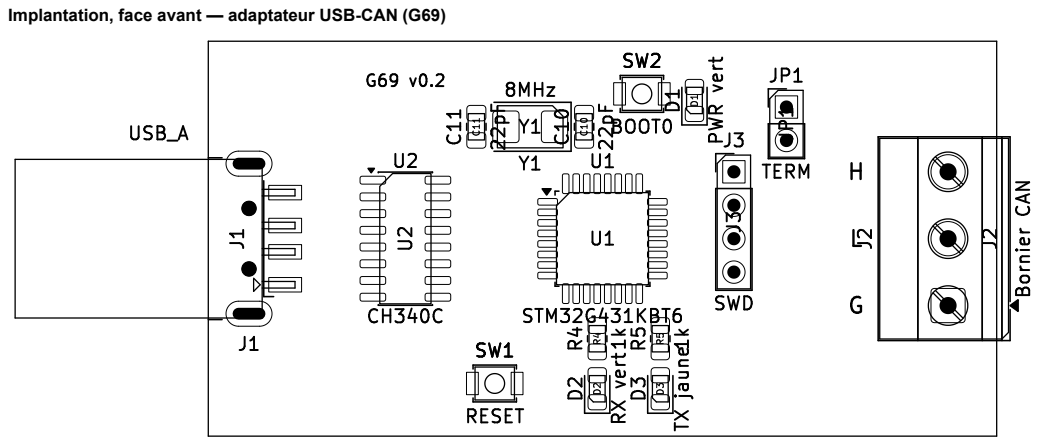
[picture p54: page 1]

Implantation, face avant — adaptateur USB-CAN (G69)
