xopigun/Projet2A/banc-can/hardware/carte_porteuse/fabrication/implantation.pdf

Implantation, face avant — carte porteuse (G69)

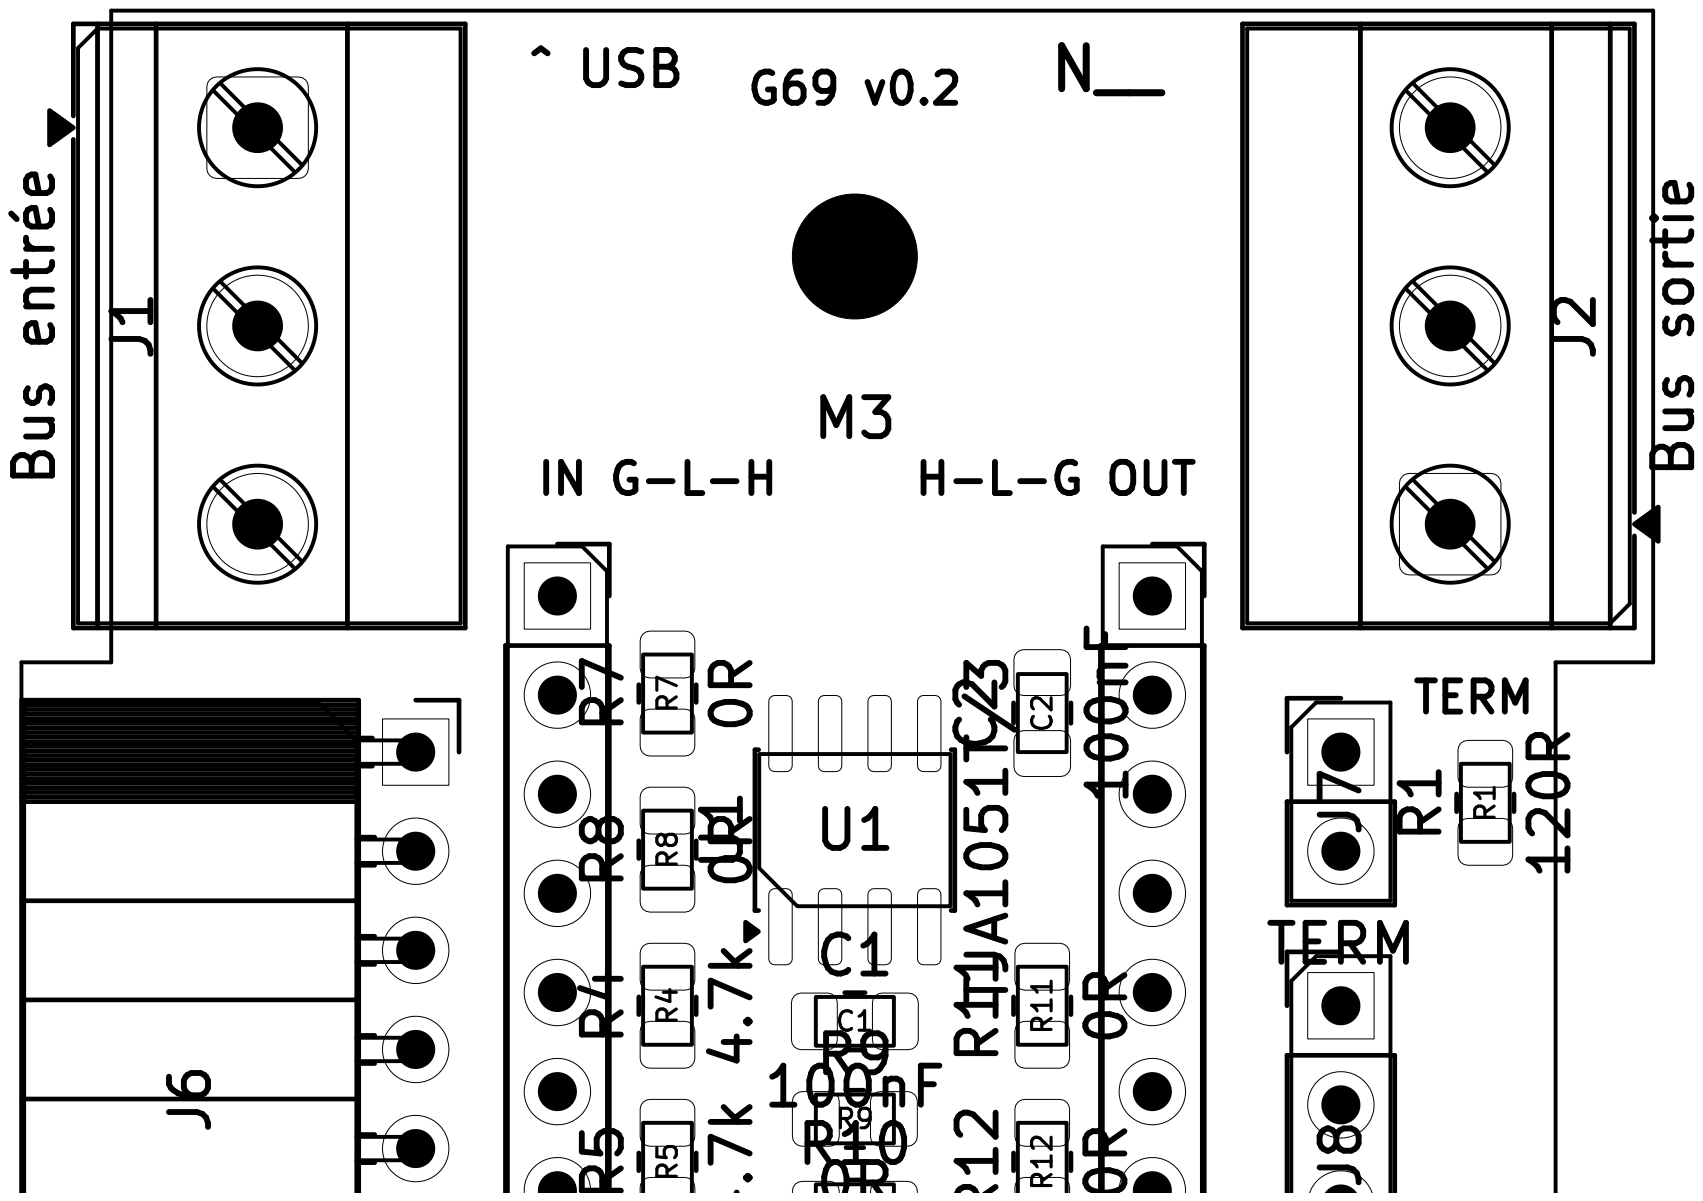
[picture p55: page 2]

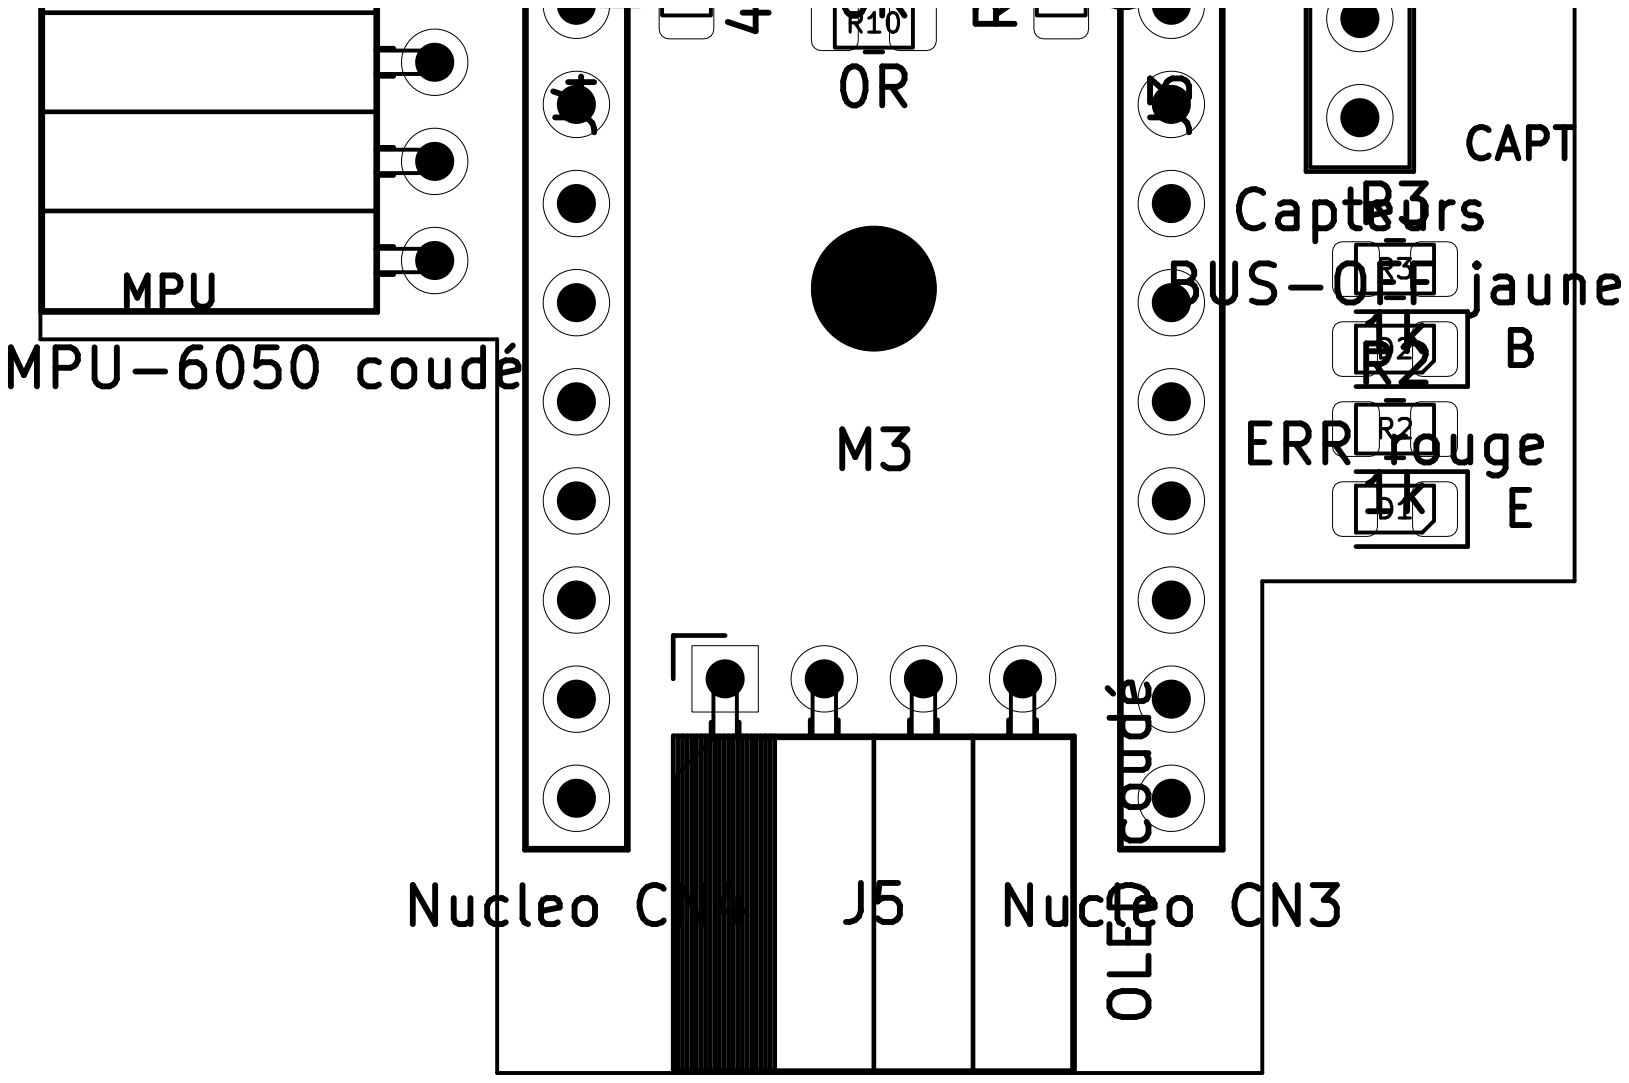
[picture p56: page 3]
