xopigun/Projet2A/Cobot/schema_bus_cobot.pdf

### CAN_H

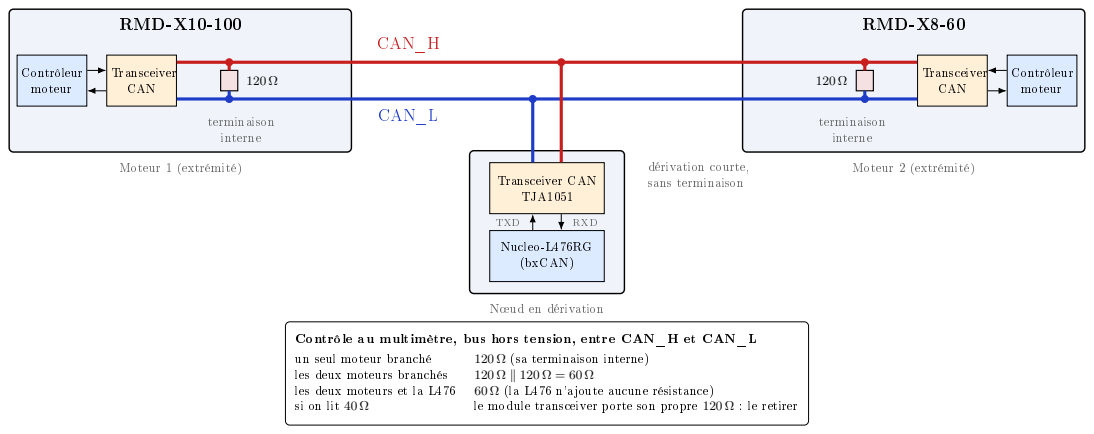
[picture p57: page 1]
RMD-X10-100; Contrôleur moteur; Transceiver CAN; RMD-X8-60; Moteur 1 (extrémité); Moteur 2 (extrémité); terminaison interne; Transceiver CAN TJA1051; Nucleo-L476RG (bxCAN); TXD; RXD; CAN_L; dérivation courte, sans terminaison; un seul moteur branché; 120 Ω (sa terminaison interne); les deux moteurs branchés; les deux moteurs et la L476; 60 Ω (la L476 n'ajoute aucune résistance); si on lit 40 Ω; le module transceiver porte son propre 120 Ω : le retirer

N÷ud en dérivation

Contrôle au multimètre, bus hors tension, entre CAN_H et CAN_L
