xopigun/Projet2A/banc-can/hardware/carte_porteuse/carte_porteuse.kicad_pcb

## KiCad design banc-can/hardware/carte_porteuse/carte_porteuse.kicad_pcb (2026-11-13)

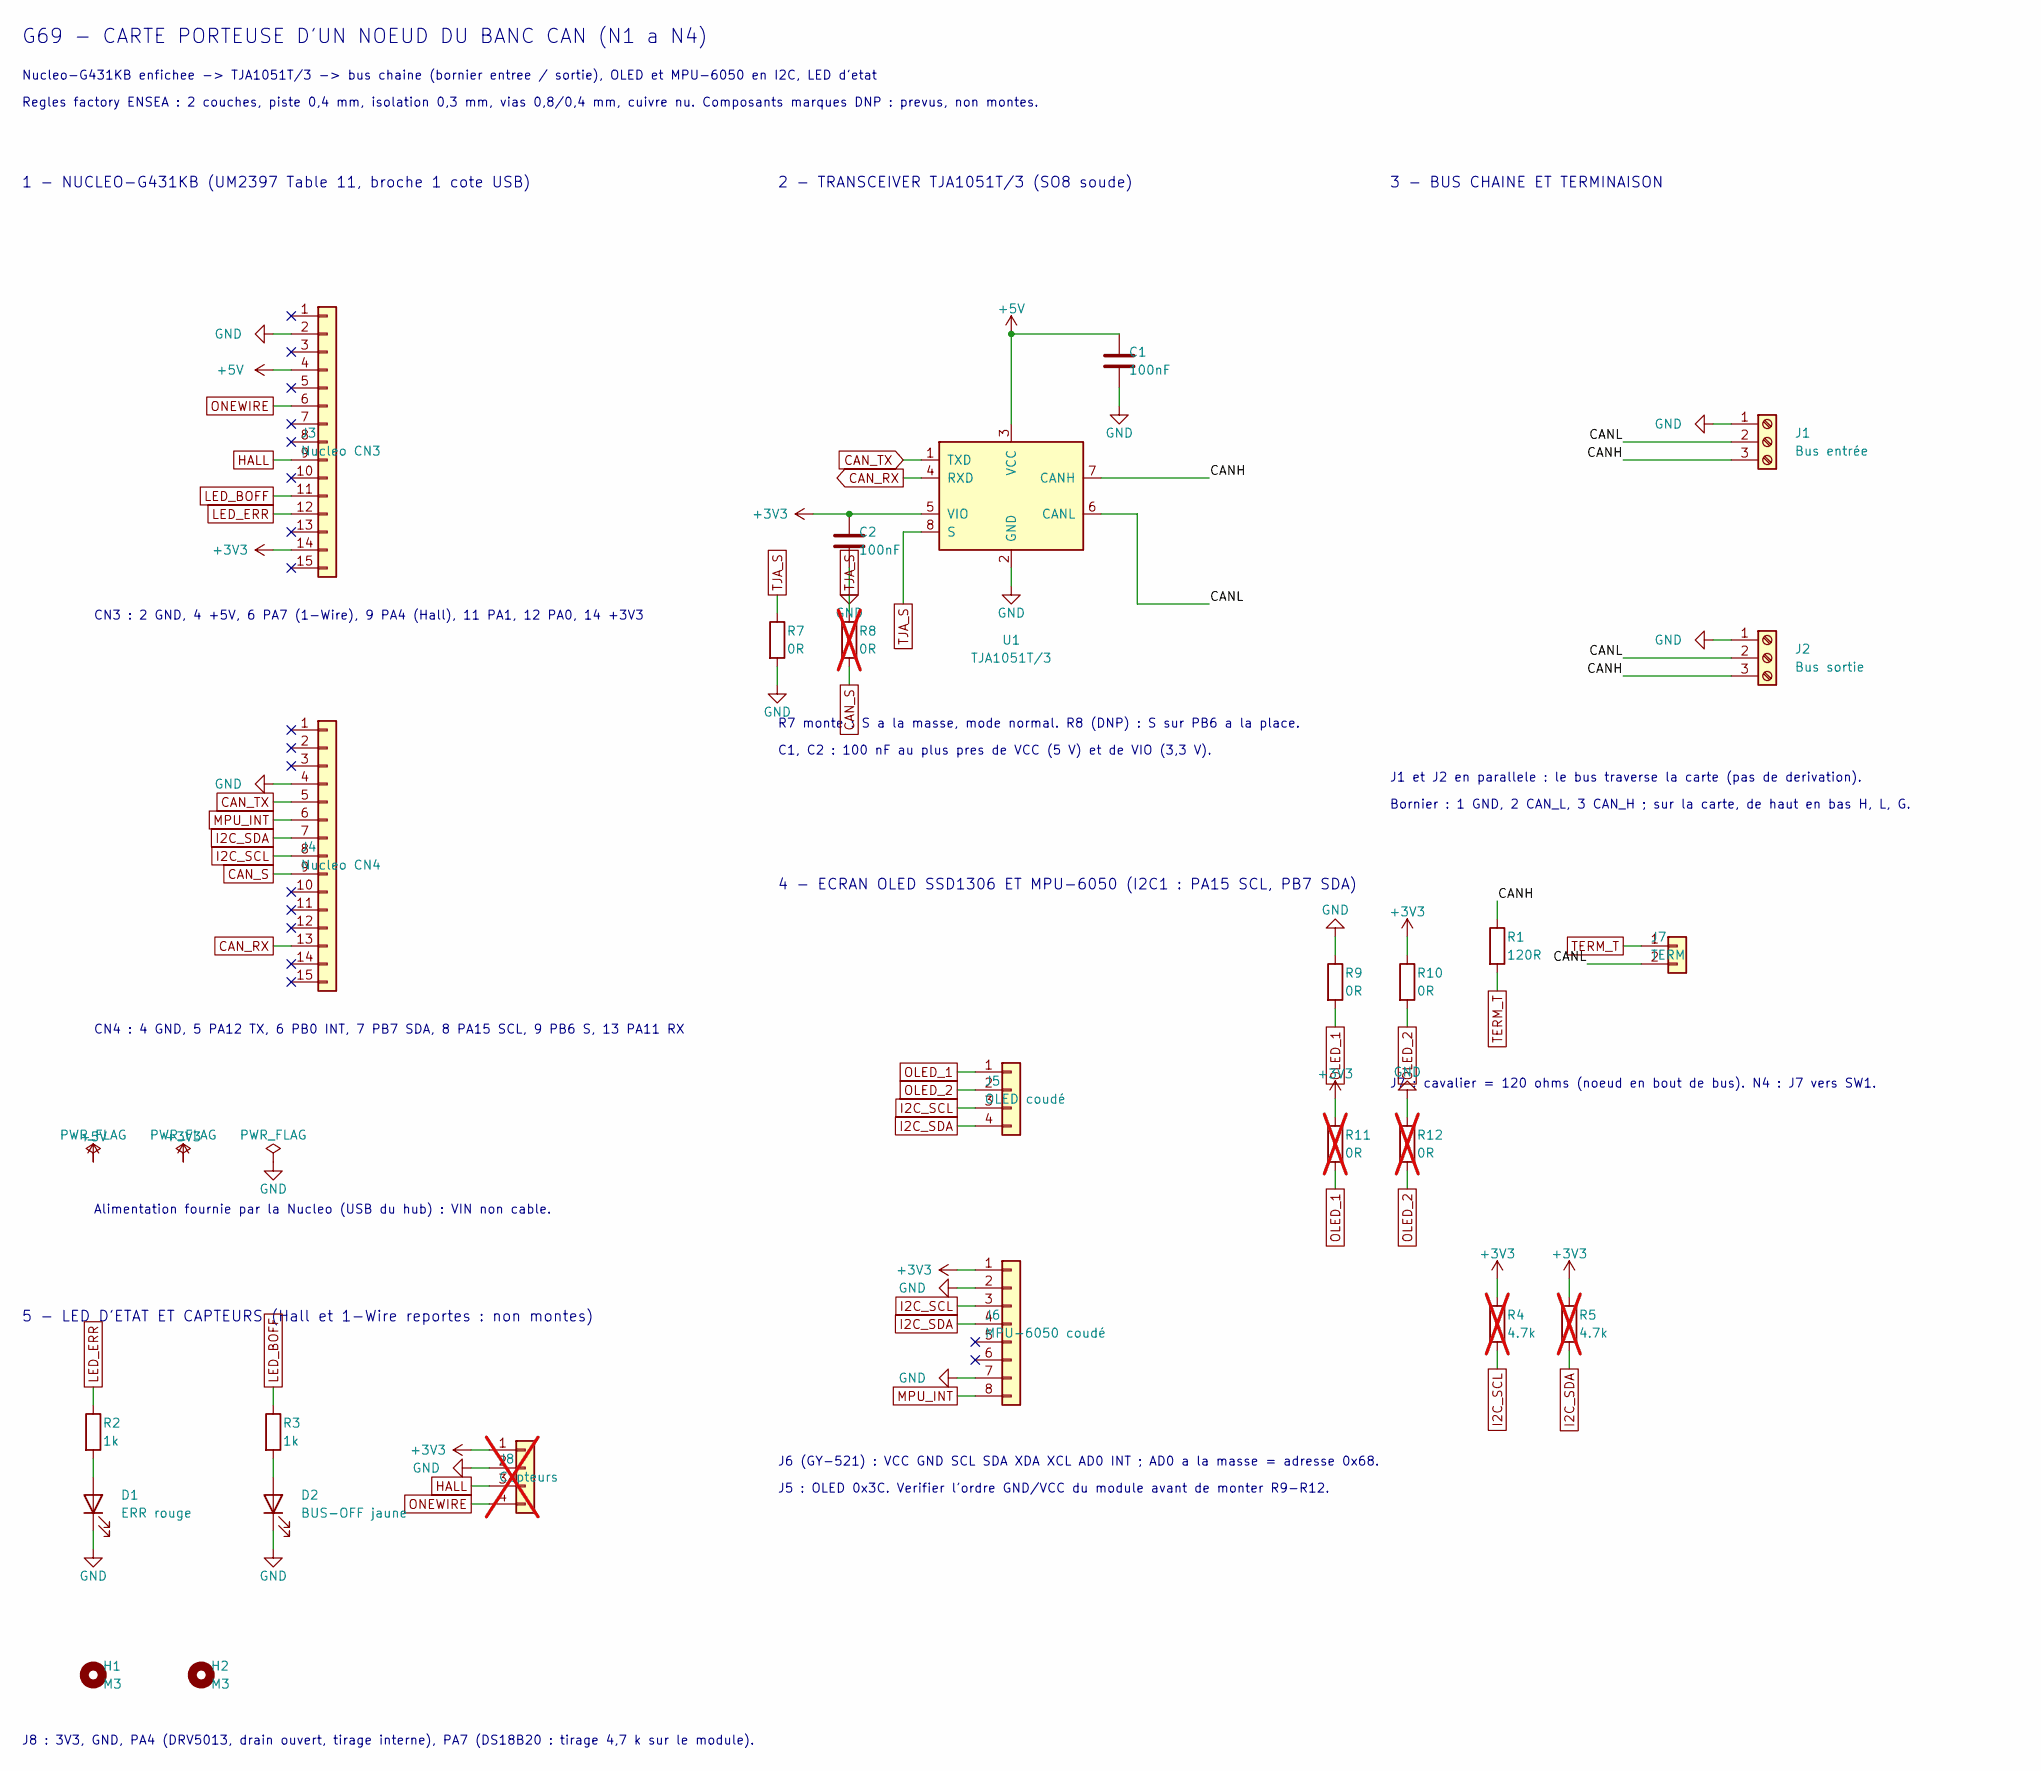
[picture p59: schematic carte_porteuse.kicad_sch, Carte porteuse - banc CAN G69]

Parts:
C1, C2: 100nF; C_0805_2012Metric_Pad1.18x1.45mm_HandSolder; MPN CL21B104KBCNNNC
D1: ERR rouge; LED_0805_2012Metric_Pad1.15x1.40mm_HandSolder; MPN 150080RS75000
D2: BUS-OFF jaune; LED_0805_2012Metric_Pad1.15x1.40mm_HandSolder; MPN 150080YS75000
H1, H2: M3; MountingHole_3.2mm_M3; MPN trou de fixation 3,2 mm, vis M3
J1: Bus entrée; TerminalBlock_Phoenix_MKDS-1,5-3-5.08_1x03_P5.08mm_Horizont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; MPN 1729131 (MKDS 1,5/ 3-5,08)
J2: Bus sortie; TerminalBlock_Phoenix_MKDS-1,5-3-5.08_1x03_P5.08mm_Horizont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; MPN 1729131 (MKDS 1,5/ 3-5,08)
J3: Nucleo CN3; PinSocket_1x15_P2.54mm_Vertical; MPN barrette femelle 1 x 15, pas 2,54 mm
J4: Nucleo CN4; PinSocket_1x15_P2.54mm_Vertical; MPN barrette femelle 1 x 15, pas 2,54 mm
J5: OLED coudé; PinSocket_1x04_P2.54mm_Horizontal; MPN barrette femelle coudée 1 x 4, pas 2,54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
J6: MPU-6050 coudé; PinSocket_1x08_P2.54mm_Horizontal; MPN barrette femelle coudée 1 x 8, pas 2,54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
J7: TERM; PinHeader_1x02_P2.54mm_Vertical; MPN 61300211121
J8: Capteurs; PinHeader_1x04_P2.54mm_Vertical; MPN barrette mâle 1 x 4, pas 2,54 mm; not fitted
R1: 120R; R_0805_2012Metric_Pad1.20x1.40mm_HandSolder; MPN RC0805FR-07120RL
R2, R3: 1k; R_0805_2012Metric_Pad1.20x1.40mm_HandSolder; MPN RC0805FR-071KL
R4, R5: 4.7k; R_0805_2012Metric_Pad1.20x1.40mm_HandSolder; MPN RC0805FR-074K7L; not fitted
R7, R9, R10: 0R; R_0805_2012Metric_Pad1.20x1.40mm_HandSolder; MPN RC0805JR-070RL
R8, R11, R12: 0R; R_0805_2012Metric_Pad1.20x1.40mm_HandSolder; MPN RC0805JR-070RL; not fitted
U1: TJA1051T/3; SOIC-8_3.9x4.9mm_P1.27mm; MPN TJA1051T/3,118

Connections:
+3V3: C2.1, J3.14, J6.1, J8.1, R4.1, R5.1, R10.1, R11.1, U1.5 (VIO)
+5V: C1.1, J3.4, U1.3 (VCC)
/CANH: J1.3, J2.3, R1.1, U1.7 (CANH)
/CANL: J1.2, J2.2, J7.2, U1.6 (CANL)
CAN_RX: J4.13, U1.4 (RXD)
CAN_S: J4.9, R8.2
CAN_TX: J4.5, U1.1 (TXD)
GND: C1.2, C2.2, D1.1 (K), D2.1 (K), J1.1, J2.1, J3.2, J4.4, J6.2, J6.7, J8.2, R7.2, R9.1, R12.1, U1.2 (GND)
HALL: J3.9, J8.3
I2C_SCL: J4.8, J5.3, J6.3, R4.2
I2C_SDA: J4.7, J5.4, J6.4, R5.2
LED_BOFF: J3.11, R3.1
LED_ERR: J3.12, R2.1
MPU_INT: J4.6, J6.8
unnamed: D1.2 (A), R2.2
unnamed: D2.2 (A), R3.2
OLED_1: J5.1, R9.2, R11.2
OLED_2: J5.2, R10.2, R12.2
ONEWIRE: J3.6, J8.4
TERM_T: J7.1, R1.2
TJA_S: R7.1, R8.1, U1.8 (S)

Notes on the sheet:
G69 - CARTE PORTEUSE D'UN NOEUD DU BANC CAN (N1 a N4)
Nucleo-G431KB enfichee -> TJA1051T/3 -> bus chaine (bornier entree / sortie), OLED et MPU-6050 en I2C, LED d'etat
Regles factory ENSEA : 2 couches, piste 0,4 mm, isolation 0,3 mm, vias 0,8/0,4 mm, cuivre nu. Composants marques DNP : prevus, non montes.
1 - NUCLEO-G431KB (UM2397 Table 11, broche 1 cote USB)
CN3 : 2 GND, 4 +5V, 6 PA7 (1-Wire), 9 PA4 (Hall), 11 PA1, 12 PA0, 14 +3V3
CN4 : 4 GND, 5 PA12 TX, 6 PB0 INT, 7 PB7 SDA, 8 PA15 SCL, 9 PB6 S, 13 PA11 RX
Alimentation fournie par la Nucleo (USB du hub) : VIN non cable.
2 - TRANSCEIVER TJA1051T/3 (SO8 soude)
R7 monte : S a la masse, mode normal. R8 (DNP) : S sur PB6 a la place.
C1, C2 : 100 nF au plus pres de VCC (5 V) et de VIO (3,3 V).
3 - BUS CHAINE ET TERMINAISON
J1 et J2 en parallele : le bus traverse la carte (pas de derivation).
Bornier : 1 GND, 2 CAN_L, 3 CAN_H ; sur la carte, de haut en bas H, L, G.
J7 : cavalier = 120 ohms (noeud en bout de bus). N4 : J7 vers SW1.
4 - ECRAN OLED SSD1306 ET MPU-6050 (I2C1 : PA15 SCL, PB7 SDA)
J6 (GY-521) : VCC GND SCL SDA XDA XCL AD0 INT ; AD0 a la masse = adresse 0x68.
J5 : OLED 0x3C. Verifier l'ordre GND/VCC du module avant de monter R9-R12.
5 - LED D'ETAT ET CAPTEURS (Hall et 1-Wire reportes : non montes)
J8 : 3V3, GND, PA4 (DRV5013, drain ouvert, tirage interne), PA7 (DS18B20 : tirage 4,7 k sur le module).

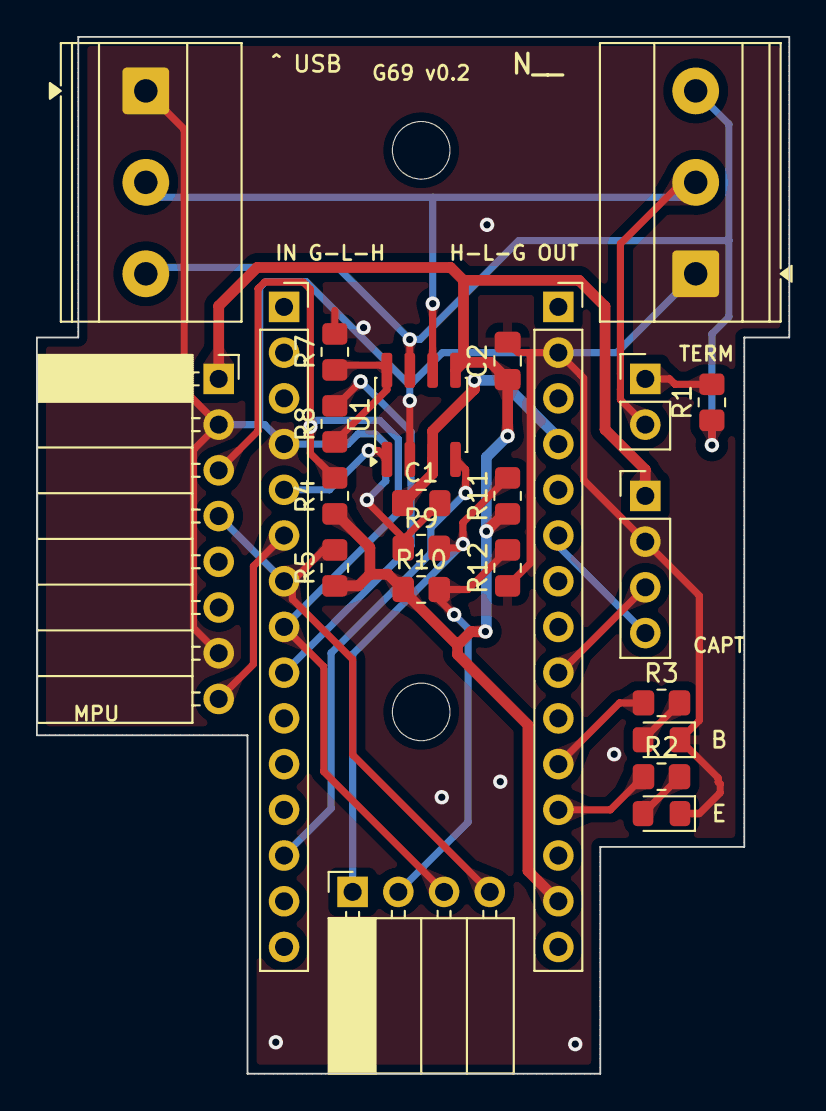
[picture p60: board carte_porteuse.kicad_pcb from above]

Board: 2 copper layers, 41.8 x 57.6 mm, 26 parts (0 on the bottom side), 21 nets.
