xopigun/Projet2A/banc-can/hardware/adaptateur_usb_can/adaptateur_usb_can.kicad_pcb

## KiCad design banc-can/hardware/adaptateur_usb_can/adaptateur_usb_can.kicad_pcb (2026-11-13)

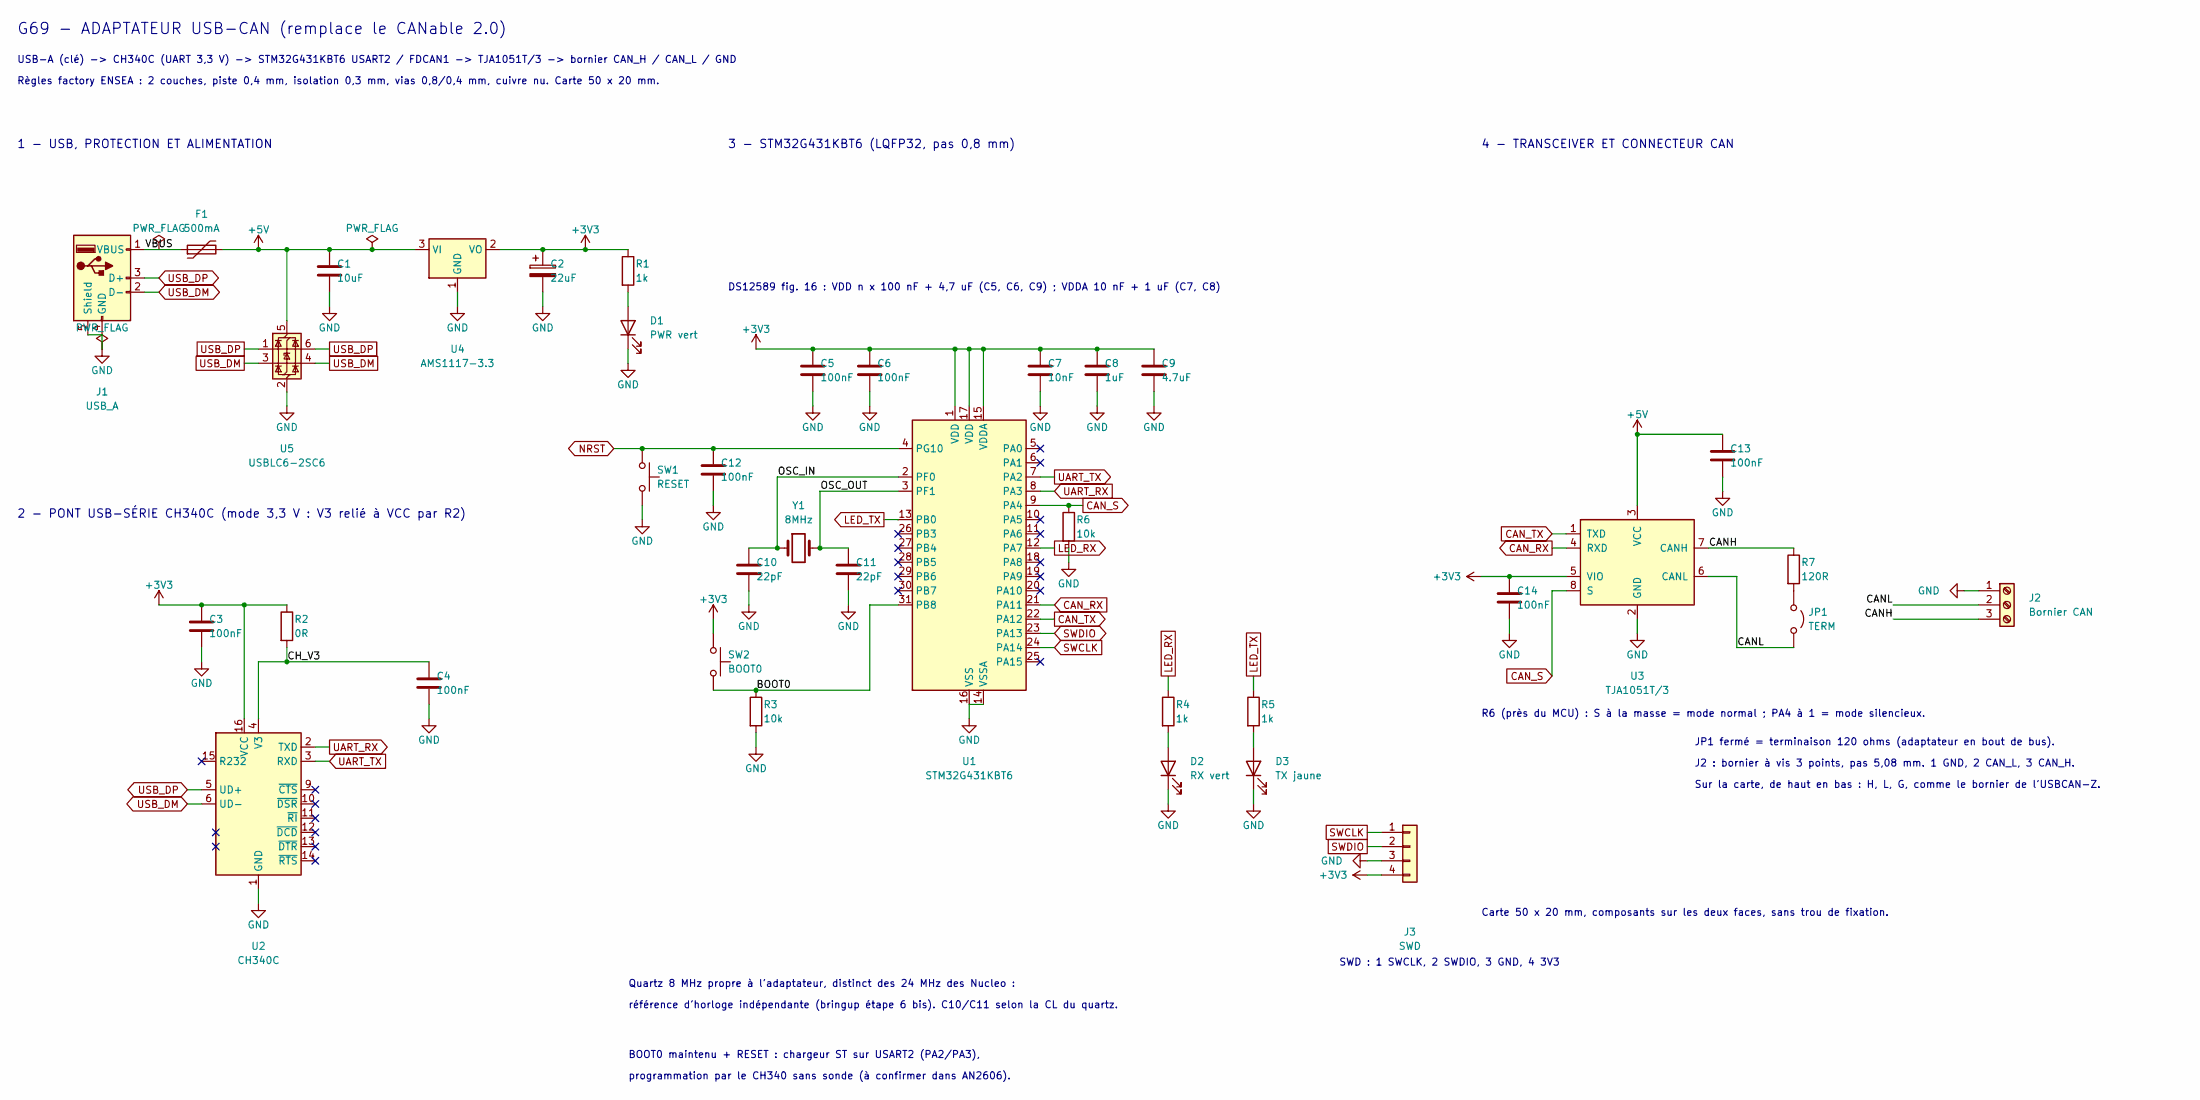
[picture p61: schematic adaptateur_usb_can.kicad_sch, Adaptateur USB-CAN - banc CAN G69]

Parts:
C1: 10uF; C_0805_2012Metric_Pad1.18x1.45mm_HandSolder; MPN CL21A106KOQNNNE
C2: 22uF; CP_EIA-3216-18_Kemet-A_HandSolder; MPN T491A226K010AT
C3, C4, C5, C6, C12, C13, C14: 100nF; C_0805_2012Metric_Pad1.18x1.45mm_HandSolder; MPN CL21B104KBCNNNC
C7: 10nF; C_0805_2012Metric_Pad1.18x1.45mm_HandSolder; MPN CL21B103KBANNNC
C8: 1uF; C_0805_2012Metric_Pad1.18x1.45mm_HandSolder; MPN CL21B105KOFNNNE
C9: 4.7uF; C_0805_2012Metric_Pad1.18x1.45mm_HandSolder; MPN CL21A475KAQNNNE
C10, C11: 22pF; C_0805_2012Metric_Pad1.18x1.45mm_HandSolder; MPN CL21C220JBANNNC
D1: PWR vert; LED_0805_2012Metric_Pad1.15x1.40mm_HandSolder; MPN 150080GS75000
D2: RX vert; LED_0805_2012Metric_Pad1.15x1.40mm_HandSolder; MPN 150080GS75000
D3: TX jaune; LED_0805_2012Metric_Pad1.15x1.40mm_HandSolder; MPN 150080YS75000
F1: 500mA; Fuse_1206_3216Metric_Pad1.42x1.75mm_HandSolder; MPN MF-NSMF050-2
J1: USB_A; USB_A_CNCTech_1001-011-01101_Horizontal; MPN 1001-011-01101
J2: Bornier CAN; TerminalBlock_Phoenix_MKDS-1,5-3-5.08_1x03_P5.08mm_Horizont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; MPN 1729131 (MKDS 1,5/ 3-5,08)
J3: SWD; PinHeader_1x04_P2.54mm_Vertical; MPN 61300411121
JP1: TERM; PinHeader_1x02_P2.54mm_Vertical; MPN 61300211121
R1, R4, R5: 1k; R_0805_2012Metric_Pad1.20x1.40mm_HandSolder; MPN RC0805FR-071KL
R2: 0R; R_0805_2012Metric_Pad1.20x1.40mm_HandSolder; MPN RC0805JR-070RL
R3, R6: 10k; R_0805_2012Metric_Pad1.20x1.40mm_HandSolder; MPN RC0805FR-0710KL
R7: 120R; R_0805_2012Metric_Pad1.20x1.40mm_HandSolder; MPN RC0805FR-07120RL
SW1: RESET; SW_SPST_B3U-1000P; MPN B3U-1000P
SW2: BOOT0; SW_SPST_B3U-1000P; MPN B3U-1000P
U1: STM32G431KBT6; LQFP-32_7x7mm_P0.8mm; MPN STM32G431KBT6
U2: CH340C; SOIC-16_3.9x9.9mm_P1.27mm; MPN CH340C
U3: TJA1051T/3; SOIC-8_3.9x4.9mm_P1.27mm; MPN TJA1051T/3,118
U4: AMS1117-3.3; SOT-223-3_TabPin2; MPN AMS1117-3.3
U5: USBLC6-2SC6; SOT-23-6; MPN USBLC6-2SC6
Y1: 8MHz; Crystal_SMD_5032-2Pin_5.0x3.2mm; MPN quartz 8 MHz 5032, CL 16 pF (C10/C11 = 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

Connections:
+3V3: C2.1, C3.1, C5.1, C6.1, C7.1, C8.1, C9.1, C14.1, J3.4, R1.1, R2.1, SW2.1, U1.1 (VDD), U1.15 (VDDA), U1.17 (VDD), U2.16 (VCC), U3.5 (VIO), U4.2 (VO)
+5V: C1.1, C13.1, F1.2, U3.3 (VCC), U4.3 (VI), U5.5 (VBUS)
/BOOT0: R3.1, SW2.2, U1.31 (PB8)
/CANH: J2.3, R7.1, U3.7 (CANH)
/CANL: J2.2, JP1.2 (B), U3.6 (CANL)
/CH_V3: C4.1, R2.2, U2.4 (V3)
/OSC_IN: C10.1, U1.2 (PF0), Y1.1
/OSC_OUT: C11.1, U1.3 (PF1), Y1.2
/VBUS: F1.1, J1.1 (VBUS)
CAN_RX: U1.21 (PA11), U3.4 (RXD)
CAN_S: R6.1, U1.9 (PA4), U3.8 (S)
CAN_TX: U1.22 (PA12), U3.1 (TXD)
GND: C1.2, C2.2, C3.2, C4.2, C5.2, C6.2, C7.2, C8.2, C9.2, C10.2, C11.2, C12.2, C13.2, C14.2, D1.1 (K), D2.1 (K), D3.1 (K), J1.4 (GND), J1.5 (Shield), J2.1, J3.3, R3.2, R6.2, SW1.2, U1.14 (VSSA), U1.16 (VSS), U1.32 (VSS), U2.1 (GND), U3.2 (GND), U4.1 (GND), U5.2 (GND)
LED_RX: R4.1, U1.12 (PA7)
LED_TX: R5.1, U1.13 (PB0)
NRST: C12.1, SW1.1, U1.4 (PG10)
unnamed: D1.2 (A), R1.2
unnamed: D2.2 (A), R4.2
unnamed: D3.2 (A), R5.2
unnamed: JP1.1 (A), R7.2
SWCLK: J3.1, U1.24 (PA14)
SWDIO: J3.2, U1.23 (PA13)
UART_RX: U1.8 (PA3), U2.2 (TXD)
UART_TX: U1.7 (PA2), U2.3 (RXD)
USB_DM: J1.2 (D-), U2.6 (UD-), U5.3 (I/O2), U5.4 (I/O2)
USB_DP: J1.3 (D+), U2.5 (UD+), U5.1 (I/O1), U5.6 (I/O1)

Notes on the sheet:
G69 - ADAPTATEUR USB-CAN (remplace le CANable 2.0)
USB-A (clé) -> CH340C (UART 3,3 V) -> STM32G431KBT6 USART2 / FDCAN1 -> TJA1051T/3 -> bornier CAN_H / CAN_L / GND
Règles factory ENSEA : 2 couches, piste 0,4 mm, isolation 0,3 mm, vias 0,8/0,4 mm, cuivre nu. Carte 50 x 20 mm.
1 - USB, PROTECTION ET ALIMENTATION
2 - PONT USB-SÉRIE CH340C (mode 3,3 V : V3 relié à VCC par R2)
3 - STM32G431KBT6 (LQFP32, pas 0,8 mm)
DS12589 fig. 16 : VDD n x 100 nF + 4,7 uF (C5, C6, C9) ; VDDA 10 nF + 1 uF (C7, C8)
Quartz 8 MHz propre à l'adaptateur, distinct des 24 MHz des Nucleo :
référence d'horloge indépendante (bringup étape 6 bis). C10/C11 selon la CL du quartz.
BOOT0 maintenu + RESET : chargeur ST sur USART2 (PA2/PA3),
programmation par le CH340 sans sonde (à confirmer dans AN2606).
SWD : 1 SWCLK, 2 SWDIO, 3 GND, 4 3V3
4 - TRANSCEIVER ET CONNECTEUR CAN
R6 (près du MCU) : S à la masse = mode normal ; PA4 à 1 = mode silencieux.
JP1 fermé = terminaison 120 ohms (adaptateur en bout de bus).
J2 : bornier à vis 3 points, pas 5,08 mm. 1 GND, 2 CAN_L, 3 CAN_H.
Sur la carte, de haut en bas : H, L, G, comme le bornier de l'USBCAN-Z.
Carte 50 x 20 mm, composants sur les deux faces, sans trou de fixation.

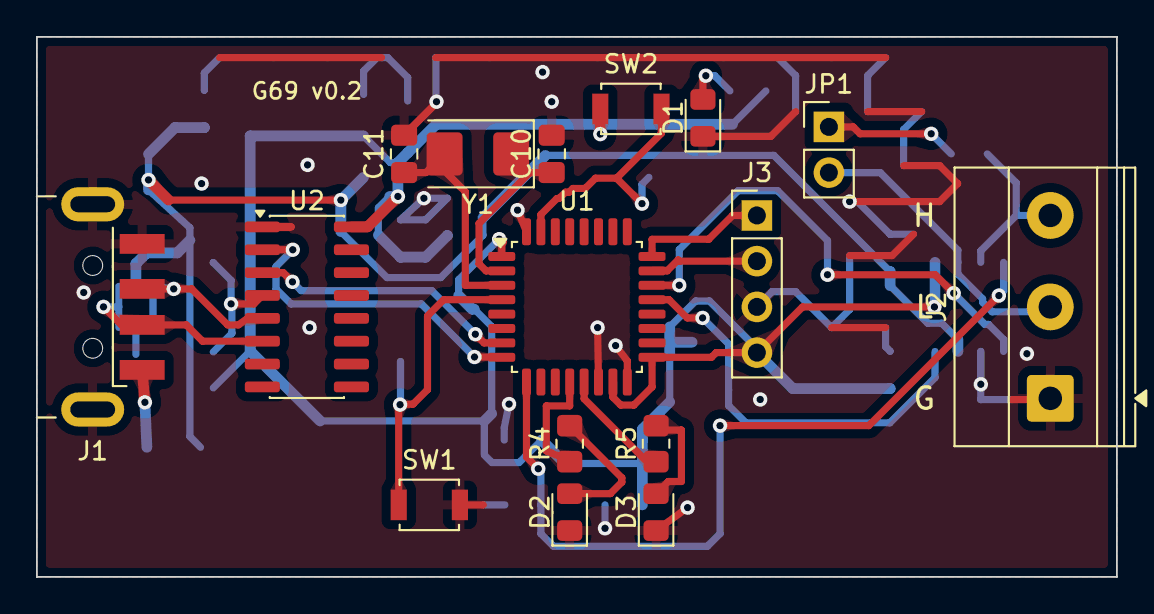
[picture p62: board adaptateur_usb_can.kicad_pcb from above]

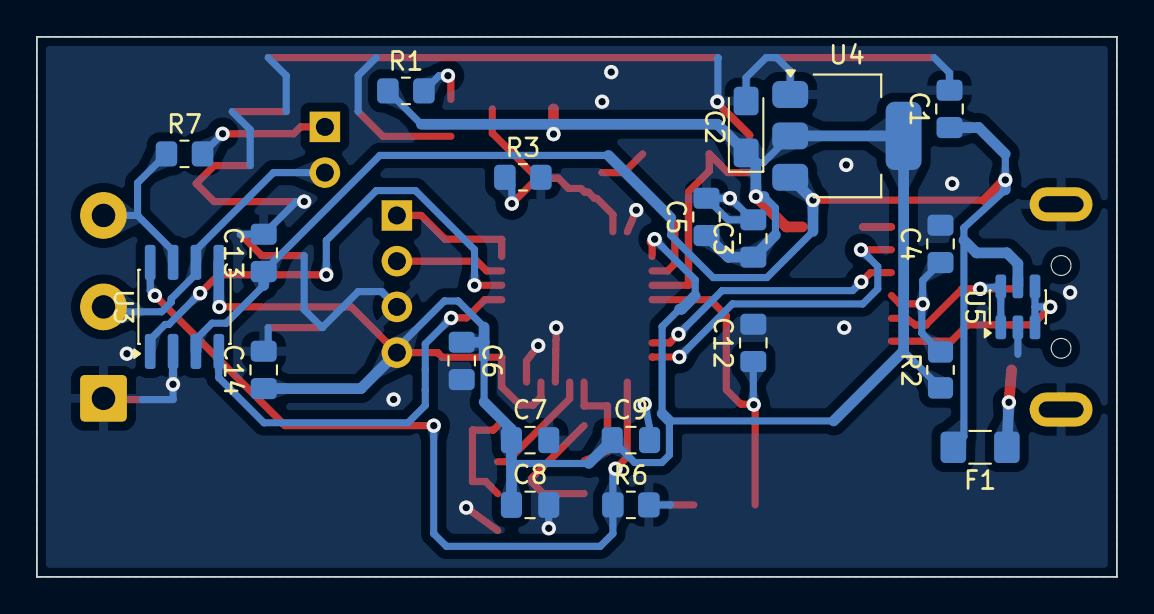
[picture p63: board adaptateur_usb_can.kicad_pcb from below]

Board: 2 copper layers, 60.0 x 30.0 mm, 37 parts (21 on the bottom side), 26 nets.
