xopigun/Projet2A/(commit log)

2026-09-22 docs: plan de phase 0 et vérification des références
    Lecture des quatre PDF fournis, vérification des sept points relevés
    dans le dossier v0.1, calcul des bit timings et découpage en lots.
    Signale l'absence du dossier de définition et le contenu hors sujet du
    PDF « Blue Pill ». Relève deux points critiques non listés : le cavalier
    HW1 qui court-circuite PA12 à la masse, et l'absence de HSE active par
    défaut sur la Nucleo-G431KB.
2026-09-22 chore(repo): socle du depot, sous-modules ST epingles et CI
    Lot 1. Configuration git (fins de ligne, PDF hors depot), style de code C,
    licence MIT avec les licences reelles des composants ST, index des documents
    de reference, CMake racine avec presets host et n1 a n4, chaine de compilation
    croisee ARM, detection automatique de STM32_Programmer_CLI et OpenOCD hors
    PATH, et workflow GitHub Actions.
    Sous-modules epingles : cmsis_core v5.9.0_20250520, cmsis_device_g4 v1.2.6,
    cmsis_device_f1 v4.3.5, stm32g4xx_hal_driver v1.2.7, stm32f1xx_hal_driver
    v1.1.10.
    Met a jour docs/PLAN.md apres lecture du dossier de definition : six fonctions,
    SW1/SW2/SW3, tableau 7, protocole ARM/GO. Releve deux erreu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
2026-09-22 feat(icd): ICD comme source unique, generateur et parite C/Python
    Lot 2. icd/bench_icd.yaml decrit identifiants, signaux et encodages ; le
    generateur produit le C, le module Python, le DBC, les tableaux LaTeX et les
    vecteurs de reference.
    Identifiants portes par des profils reseau (reponse Q3) : rien n'est en dur,
    et le heartbeat passe en 0x780+node_id, plage non attribuee par CiA 301, a
    la priorite la plus basse du bus. Le generateur verifie par profil l'absence
    de collision, l'absence de chevauchement de signaux, et la contrainte d'ordre
    ARM/GO dont depend le depart simultane de l'arbitrage.
    La parite d'encodage est verifiee entre trois implementations independantes :
    la reference Python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
2026-09-22 feat(fw-common): tampon circulaire, protocole ARM/GO et heartbeat
    Lot 3. Code commun independant du microcontroleur, avec ses tests natifs.
    can_if.h fixe l'interface CAN abstraite : les compteurs d'erreur y sont lus
    dans le materiel, jamais reimplementes en logiciel.
    Le tampon circulaire est a producteur et consommateur uniques, sans section
    critique ; en saturation il rejette la nouvelle trame au lieu d'ecraser une
    trame deja recue, ce qui fausserait l'ordre dont depend la mesure du rang.
    arbitration.c realise la machine d'etats ARM/GO et le calcul du rang. Les
    deux arguments qui garantissent le depart simultane sont documentes comme
    complementaires : l'armement pendant GO (dossier) couv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
2026-09-22 feat(fw-g431): port FDCAN, horloges et application des noeuds N1 a N3
    Lot 4. board.h porte tout le brochage et applique les corrections de la
    phase 0 : I2C1 sur PA15/PB7 (PB9 n'existe pas sur le boitier UFQFPN32, PB8
    est BOOT0), LED TX sur PB8 au lieu de PA2 qui est le TX du port COM virtuel,
    PA5 et PA6 laissees flottantes puisque SB2 et SB3 sont fermes par defaut.
    La source d'horloge est selectionnable (reponse Q2) : HSE par defaut, repli
    HSI signale par un #warning a la compilation, le libelle « HSI - NON VALIDE »
    et le bit clock_not_qualified du heartbeat.
    Le port FDCAN lit l'etat dans PSR et ECR sans reimplementer de compteur,
    distingue les pertes FIFO materielles des debordements du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
2026-09-22 feat(bringup): autotest materiel, brochage et configuration logicielle
    Prepare la mise en route sur cartes reelles, avant les lots IHM et canbench.
    Ajoute un mode autotest (presets n1-selftest a n3-selftest) en deux phases.
    La phase 1 ouvre le FDCAN en bouclage interne : elle valide l'horloge, le temps
    de bit, la chaine ISR vers tampon et l'encodage de l'ICD sans transceiver ni bus
    cable, donc avant toute soudure. La phase 2 fait un ping/pong entre noeuds avec
    compteurs et etat PSR/ECR sur le port COM virtuel. Un echec de la phase 1 designe
    la carte, un echec de la phase 2 designe le cablage.
    docs/bringup.md donne la procedure pas a pas, du retrait de HW1 au firmware
    nominal, avec les poin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
2026-09-22 fix: portee du bouclage, charge de terminaison, verrouillage CAN 2.0A
    Trois corrections.
    1. Le bouclage interne ne valide NI l'horloge NI le debit : emetteur et
    recepteur partagent la meme horloge noyau, donc une PLL fausse se boucle sur
    elle-meme sans erreur. Un echange entre deux Nucleo de configuration identique
    ne le prouve pas davantage, l'erreur commune etant invisible entre pairs.
    Corrige les affirmations correspondantes dans can_if.h, selftest.c,
    config_logicielle.md et bringup.md, et ajoute une phase 3 « reference
    independante » : echange avec le CANable, puis mesure du temps de bit a
    l'oscilloscope (2,000 us attendus, bande 1,990-2,010 us a +/- 0,485 %, mais
    2,000 us a quelques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
2026-09-22 feat(pc): canbench, entierement testable sur bus virtuel
    Lot canbench. Huit sous-commandes : monitor, arbitration, encoding, faults,
    busload, record, replay et report. Toutes tournent sur le bus virtuel avec
    --simulate, qui reproduit N1 a N4 y compris ARM/GO, heartbeat et modes de faute.
    L'interface PC est ouverte en CAN 2.0A classic (fd=False) et refuse d'emettre
    hors specification ; toute trame FD ou a identifiant 29 bits recue est comptee
    et signalee.
    arbitration mesure le rang de chaque contendant et produit aussi les colonnes
    gagnes/perdus du tableau 7, « perdus » comptant des cycles. encoding compare
    octet par octet aux sequences deterministes de l'ICD et pointe le signal
    concerne.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
2026-09-29 fix(fw-g431): codage du DLC, arret fatal visible, presets HSI
    Trois defauts trouves en relisant le port avant la premiere mise sous tension.
    Aucun n'etait visible par les tests, qui tournent sur PC sans la HAL.
    1. Codage du DLC. Dans la HAL G4 epinglee, FDCAN_DLC_BYTES_8 vaut 8 et non
    0x80000 comme dans les anciennes versions. Le decalage de 16 bits faisait
    indexer par la HAL un tableau de 16 cases avec 0x80000 a l'emission, et
    presenter chaque trame recue avec un DLC nul. Corrige, et verrouille par une
    assertion statique qui fera echouer la compilation si la HAL change encore de
    convention.
    2. Arret silencieux. Si le quartz ne demarrait pas, la carte se figeait avant
    d'avoir ouvert le por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
2026-09-29 docs(plan): consigne les defauts du chemin ARM/GO, bloquants pour T3
    Relus de bout en bout avant la premiere mise sous tension. Trois defauts, que
    la simulation masquait :
    - canbench attend 2 ms entre ARM et GO ; le bus reste libre et les noeuds armes
    emettent seuls, avant GO, ce qui annule le depart simultane ;
    - le firmware fige son rang au moment ou il arme, pas quand sa trame part :
    l'appel est ignore et les compteurs embarques restent a zero ;
    - le simulateur n'emet les contendants qu'a la reception de GO, modelisant le
    comportement voulu et non celui du firmware.
    Ne bloque pas la phase 2 de la mise en route, qui n'utilise pas ARM/GO. La
    correction prevue et la precondition mate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
2026-09-29 docs(verif): leve les TODO(verif) du G431 a partir des documents ST
    V1 AF9 du FDCAN sur PA11/PA12 (DS12589 Table 13), V2 BOOT0 lu sur PB8
    (RM0440 Table 5, FLASH_OPTR usine), V3 contraintes PLL (DS12589 Table 45),
    V4 precision du HSI16 (Table 42, pire que suppose), V10 errata FDCAN sans
    effet sur notre configuration (ES0431 §2.15), V11 cartographie memoire.
    V5/V6 : remap bxCAN confirme par RM0008, pull-up PA12 non bloquante.
2026-09-29 feat(fw-common): execution des modes de faute commandes par BENCH_CFG
    Le noeud enregistrait le mode demande sans le realiser : seul le simulateur
    le faisait. bench_faults_step() applique maintenant chaque mode au controleur
    via l'interface CAN (babbling idiot, debit errone, DLC incoherent, silencieux,
    bus-off maintenu), avec le meme comportement que le simulateur. Le parametre
    de BENCH_CFG est conserve comme identifiant de faute ; un mode inconnu est
    ignore. 10 tests natifs sur controleur simule.
2026-09-29 feat(fw-f103): noeud N4 sur Blue Pill, programme principal commun
    Port bxCAN du STM32F103C8 (lot 5), ecrit depuis DS5319 Rev 20 et RM0008 Rev 21 :
    CAN remappe sur PB8/PB9 (CAN_REMAP = 10) car l'USB et le CAN partagent leur SRAM
    et ne peuvent pas fonctionner ensemble ; journal sur USART1 ; bouclage de la
    phase 1 en mode silencieux combine, seul a laisser CANTX recessive ; filtre a
    masque nul, sans lequel bxCAN ne recoit rien ; reprise apres bus-off par ABOM.
    Temps de bit 36 MHz / 9 / 8 tq, aligne sur le G431 (87,5 %, 0,485 %).
    main.c, selftest.c et syscalls.c passent dans firmware/entry/, communs aux deux
    cartes ; chaque port expose les memes noms et son board.h ses textes propres.
    Le firmwa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
2026-09-29 fix(fw): le rang d'arbitrage est fige a la confirmation d'emission (D1, firmware)
    Le rang etait fige a l'armement, quand GO n'est pas encore passe : l'appel
    etait ignore et le noeud ne classait jamais rien. Les deux ports deposent
    maintenant un element BENCH_FRAME_OWN_TX dans le tampon de reception, depuis
    l'interruption de fin d'emission de la trame contendante : l'ordre reel du bus
    entre "ma trame est partie" et "j'ai recu celle d'un autre" est conserve.
    Une confirmation avant GO (depart anticipe) ne donne aucun rang ; un delai de
    garde de 100 ms clot le cycle comme invalide et relance le heartbeat.
    4 tests natifs (test_node), valides par mutation. Cote PC de D1 a suivre.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
2026-09-29 feat(pc): interface graphique du banc, dans le navigateur
    canbench gui (ou double-clic sur lancer_banc.bat) ouvre une page locale :
    schema du bus anime, etat des noeuds tire des heartbeats, trafic et charge,
    trames decodees par l'ICD, tests T3, T4 et T6 avec rapport Markdown, et
    injection de fautes par BENCH_CFG. Bibliotheque standard uniquement ; les
    tests appellent les memes fonctions que la ligne de commande. En simulation,
    un bandeau permanent et le verdict NON CONCLUANT rappellent que rien n'y vaut
    preuve pour le bus. 4 tests (service, API HTTP, page).
2026-09-29 feat(pc): logiciel Windows BancCAN.exe, aide integree, connexion depuis la fenetre
    pc/build_exe.py construit dist/BancCAN.exe (PyInstaller, fichier unique, sans
    console, icone dessinee par le script). Le logiciel ouvre l'interface dans une
    fenetre d'application Edge a profil dedie et s'arrete a sa fermeture ; sans
    Edge, navigateur par defaut et arret apres 15 s sans page ouverte. Journal
    dans %LOCALAPPDATA%\BancCAN.
    Connexion choisie dans la fenetre (simulation, CANable gs_usb ou slcan), avec
    retour a la simulation et message si l'ouverture echoue. Aide integree : TEC,
    REC et etats CAN, tests T1 a T7, fautes injectables. Une perte du serveur est
    signalee par un bandeau au lieu d'une page fi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
2026-09-29 feat(pc): pilotes du CANable embarques, motif affiche si une interface manque
    L'executable embarque maintenant les pilotes slcan (pyserial) et candleLight
    (gs_usb, pyusb). gs_usb exige en plus la bibliotheque systeme libusb, absente
    de Windows : la fenetre Connexion le dit au lieu de proposer une connexion
    vouee a l'echec, et si libusb-package est installe son dossier est ajoute au
    PATH pour que python-can la trouve. build_exe.py accepte un dossier de sortie,
    utile quand BancCAN.exe est ouvert et donc verrouille.
2026-09-29 fix(pc): libusb embarquee pour candleLight, un port occupe n'est plus partage
    L'executable embarque libusb-1.0.dll (libusb-package, ajoute aux dependances
    gs-usb) : le CANable en firmware candleLight est desormais utilisable.
    Sous Windows, http.server active SO_REUSEADDR, qui laisse un second programme
    ecouter sur un port deja pris : deux instances du logiciel se repondaient
    l'une a la place de l'autre. LocalServer le refuse, et la seconde instance
    prend un port libre. Test dedie, valide par mutation.
2026-09-29 fix(fw): gestionnaire SysTick absent, noeuds figes des le demarrage (D4)
    Aucun SysTick_Handler n'etait defini : l'alias faible du fichier de demarrage
    pointait sur Default_Handler, une boucle infinie. HAL_Init() activant SysTick,
    chaque firmware, autotest compris, se figeait une milliseconde apres le
    demarrage, avant tout message. Releve par une revue exterieure.
    Le gestionnaire est ajoute (entry/interrupts.c). scripts/check_vectors.py,
    lance apres chaque edition de liens, fait desormais echouer la compilation si
    un vecteur utilise pointe sur Default_Handler ; verifie en retirant le
    gestionnaire.
2026-09-29 docs(schema): schema fonctionnel de cablage du banc (KiCad)
    Ajoute schema/ : generate_schematic.py produit G69_Banc_CAN.kicad_sch, avec
    ses exports PDF, SVG et PNG. Feuille A3 en quatre blocs : bus et noeuds N1 a
    N4 (DB9, terminaisons RT1/RT2, interrupteurs SW1 a SW3), PC et instruments de
    mesure, distribution d'alimentation prevue, composants a confirmer.
    Schema fonctionnel, pas un netlist de fabrication.
2026-09-29 test(materiel): phase 1 de la mise en route reussie sur deux Nucleo
    Premier essai sur cartes reelles : N1 et N2 (NUCLEO-G431KB, HW1 retire, HSI)
    passent le bouclage interne FDCAN, 8 trames sur 8, error-active. En phase 2,
    sans transceiver, N1 passe en BUS-OFF (LEC = 5, TEC par pas de 8), comme
    attendu. Journaux bruts et synthese dans docs/resultats/. Ne valide pas le
    debit (HSI, bouclage).
2026-09-29 feat(fw-g431): option bus direct, deux Nucleo reliees sans transceiver
    Presets n1/n2/n3-selftest-direct : la sortie FDCAN1_TX passe a drain ouvert,
    TX et RX tires vers 3,3 V par les resistances internes. Reliees fil a fil, les
    cartes forment un ET cable ou le dominant l'emporte, comme sur un bus CAN.
    Permet la phase 2 de l'autotest sur table, avant la livraison des
    transceivers. Toutes les cartes reliees doivent porter ce firmware : une
    sortie push-pull en face serait un court-circuit. Verifie sur N2 : phase 1
    toujours a 8/8.
2026-09-29 feat(pc): chronogrammes de la couche physique dans l'interface
    Nouvelle section du logiciel : une trame de l'ICD suivie bit par bit, du
    microcontroleur emetteur au recepteur. Quatre chronogrammes : debut du bus
    cote emetteur (CAN_H, CAN_L, difference), entree/sortie du transceiver (TXD
    et tension differentielle), fin du bus cote recepteur avec la zone de seuil,
    et RXD reconstruit avec les points d'echantillonnage a 87,5 %. Explication du
    role du transceiver. Reglages : longueur du bus (1 a 40 m), paire torsadee ou
    non, bruit ambiant, terminaisons (2, 1 ou aucune).
    physical.py construit la trame exacte (CRC-15 valide contre la valeur de
    controle publiee 0x059E, bourrage, ACK) et porte les co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
2026-09-29 fix(gui): chronogrammes deformes, hauteur d'affichage fixee en CSS
    drawChrono() relisait l'attribut height du canevas, que l'affectation de
    c.height venait de reecrire a la resolution interne : la hauteur derivait a
    chaque trace et le navigateur deformait l'image, texte et courbes ecrases. La
    hauteur d'affichage vient maintenant de data-h et est fixee en CSS, separee de
    la resolution interne. Graphiques agrandis, police a 12 px.
2026-10-06 docs(references): versionne les PDF de reference
    A la demande de l'equipe, les 10 PDF de docs/references/ entrent dans le
    depot (82 Mo, RM0440 le plus lourd a 39 Mo) pour que chacun dispose des memes
    revisions : RM0440, RM0008, DS12589, DS5319, ES0431, UM2397, TJA1051,
    SN65HVD230, dossier v0.1. La regle .gitignore est retiree ; l'index precise
    les droits des editeurs, a reconsiderer si le depot devenait public.
2026-10-20 docs: ajoute dossier banc de test, GANTT, ICD et management
2026-10-20 chore: deplace les sous-modules vendor de banc-can a la racine
2026-10-20 docs(schema): schema electrique des ecrans LCD 16x2 sur bus CAN direct
    Deux NUCLEO-G431KB reliees en bus direct (D2/D10, tirage 2,2 kOhm vers 3V3),
    chacune pilotant un LCD HD44780 en mode 4 bits : RS=D3 (PB0), E=D9 (PA8),
    D4..D7 = D11, D12, D13, D0 (PB5, PB4, PB3, PA10), R/W a GND. Broches choisies
    parmi les libres de board.h (UM2397 Table 11), A4/A5 evitees (SB2/SB3).
    Source circuitikz et PDF compile.
2026-10-20 fix(fw): horodatages figes apres deconnexion du debogueur
    En se deconnectant apres une programmation (mode=UR puis -rst) ou une
    connexion HOTPLUG, STM32CubeProgrammer remet DEMCR a 0x00000001 : TRCENA
    efface fige DWT->CYCCNT alors que CYCCNTENA reste a 1. dwt_init() voyait
    CYCCNTENA a 1 et ne relancait rien, d'ou des now_us() et timestamp_us
    constants jusqu'a la mise hors tension suivante (constate sur carte le
    20/10/2026).
    now_us() relance TRCENA et CYCCNTENA a chaque lecture, comme cycles_now()
    du pilote LCD qui partage ce compteur, sur les ports G431, F103 et L476.
    dwt_init() disparait : le compteur n'est plus jamais remis a zero.
    timestamp_us ne quitte pas les noeuds : le pont slcan n'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
2026-10-31 feat(hardware): adaptateur USB-CAN fabricable a la factory ENSEA
    Remplace le CANable 2.0, impossible a commander (ticket GLPI 0015779).
    Le LQFP48 au pas de 0,5 mm du CANable laisse 0,2 mm entre pastilles,
    sous l'isolation de 0,3 mm de la factory : passage au STM32G431KBT6 en
    LQFP32. En 32 broches l'USB et FDCAN1 partagent PA11/PA12, d'ou un pont
    CH340C sur USART2 et le protocole slcan.
    - regles_fabrication/ : guide factory ENSEA et profils DRC ENSEA/JLCPCB
    - adaptateur_usb_can/ : projet KiCad 9 aux regles ENSEA, schema genere
    par generate_schematic.py (ERC sans violation, PCB non route)
2026-10-31 feat(hardware): placement initial du PCB de l'adaptateur USB-CAN
    - generate_pcb.py : part du gabarit DRC ENSEA, pose les 39 empreintes,
    affecte les nets de la netlist et lie chaque empreinte a son symbole
    (chemin /<uuid>), trace le contour 87,7 x 41 mm et le plan de masse
    en face arriere. Carte non routee : 88 liaisons a tracer.
    - generate_schematic.py : UUID deterministes, pour que la regeneration
    du schema conserve le lien avec les empreintes ; trous de fixation
    exclus du BOM.
    DRC ENSEA : aucune erreur, seulement des avertissements de serigraphie
    dus aux connecteurs USB-B et DB9 qui debordent du contour.
2026-10-31 chore(hardware): ignore les preferences locales KiCad
2026-10-31 feat(hardware): routage de l'adaptateur USB-CAN avec Freerouting
    Routage complet en 2 couches avec Freerouting 2.5.0 : 304 segments,
    21 vias, plan de masse GND en face arriere (75 % de la surface).
    Neckdown et fanout desactives : le premier ramenait 56 segments a
    0,3 mm, sous le minimum ENSEA de 0,4 mm.
    DRC ENSEA avec parite schema : 0 erreur, 0 liaison manquante.
    Restent 7 avertissements de serigraphie, dus a l'USB-B et au DB9
    qui debordent volontairement du contour.
    route_freerouting.py rejoue la sequence export DSN, Freerouting,
    import SES et remplissage du plan de masse.
2026-10-31 feat(hardware): dossier de fabrication factory de l'adaptateur USB-CAN
    generate_fabrication.py produit fabrication/ :
    - gerber/ : F.Cu, B.Cu, Edge.Cuts, F.Silkscreen (Gerber X2), percages
    Excellon en mm separes PTH/NPTH, plans de percage PDF
    - adaptateur_usb_can_gerber.zip a joindre au ticket factory
    - nomenclature CSV (Excel) et PDF a imprimer, 26 lignes, 37 composants
    - schema.pdf et implantation.pdf pour le cablage et la soudure
    Percages : 0,4 / 0,8 / 0,92 / 1,0 / 1,1 / 2,33 / 3,2 mm. Les 2,33 mm
    (pattes de blindage de l'USB-B) depassent la serie 0,4-2 mm de la
    factory, a valider avec elle.
2026-11-01 refactor(hardware): schema de l'adaptateur USB-CAN plus lisible
    - liaisons locales tracees en fils : rails 3,3 V et 5 V, decouplage au
    pied des broches, quartz et capacites de charge, RESET et BOOT0,
    LED, terminaison R7 + JP1, liaison TJA1051 vers DB9
    - etiquettes globales a forme orientee (entree, sortie, bidirection-
    nelle) seulement pour les liaisons entre blocs : USB, UART, CAN_TX/RX,
    CAN_S, SWD, NRST
    - tension affichee sur les symboles d'alimentation, textes des
    symboles tournes gardes a l'horizontale, aucune superposition
    - JP1 dessine en cavalier (Jumper_2_Open), meme empreinte
    Connectivite identique a la version precedente (netlists comparees
    pastille par pastille). Les ne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
2026-11-01 chore(hardware): ignore les sauvegardes auto et verrous KiCad
2026-11-01 fix(hardware): composants verifies contre leurs datasheets
    Verification des composants de l'adaptateur USB-CAN contre leurs
    datasheets, avec deux corrections :
    - C2 (sortie de l'AMS1117) passe en tantale solide 22 uF, boitier A :
    la datasheet AMS1117 (Stability, p.4) l'exige pour la stabilite.
    - C7 (VDDA) passe de 100 nF a 10 nF, comme dans DS12589 Fig. 16 p.68
    (VDDA : 10 nF + 1 uF).
    Le PCB est mis a jour (nouvelle empreinte pour C2) et reroute avec
    route_freerouting.py : 25 vias, DRC ENSEA 0 erreur, ERC 0 violation.
    - SOURCES_COMPOSANTS.md : pour chaque composant, les informations
    utilisees, leur source (page, figure ou tableau) et le statut de la
    verification. CH340C, USBLC6-2 et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
2026-11-01 feat(hardware): verifications completes et tableau de commande
    - SOURCES_COMPOSANTS.md : CH340C (WCH CH340DS1 v3D), USBLC6-2SC6
    (ST DS4260 Rev 7) et chargeur USART2 du STM32G431 (ST AN2606 Rev 70,
    Table 115 ; RM0440 Table 5) verifies dans leurs documents officiels.
    Restent ouverts : CL du quartz, percages de 2,33 mm, octets d'option
    BOOT0, dimensions de l'embase DB9.
    - generate_commande.py : tableau Excel des composants (references
    fabricant, quantites selon le nombre de cartes, liens de recherche
    Farnell, RS, Mouser et DigiKey France, autres sites).
    - generate_dossier_profs.py : ajoute le tableau et l'index des
    datasheets au .zip.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
2026-11-03 feat(simulation): banc CAN complet en 3D, interactif
    Page web (Three.js) qui montre le banc et fait circuler les trames :
    N1 a N3 sur Nucleo-G431KB, N4 sur Blue Pill, transceivers TJA1051,
    bus en paire torsadee, terminaisons, SW1 a SW3, alimentation, et
    l'adaptateur USB-CAN relie au PC.
    - bus.js : moteur sans navigateur. Arbitrage sur l'identifiant,
    acquittement, confinement d'erreurs ISO 11898-1 (TEC/REC, passif,
    bus-off, reprise apres 128 x 11 bits recessifs), ARM/GO, modes
    BENCH_CFG, fautes SW1 a SW3. Le taux d'erreur sans terminaison
    (SW1 ouvert) est un choix de modele, pas une mesure.
    - can.js : trame au bit pres (CRC-15, bourrage) et encodage des
    signaux ; test_can.mjs le ve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
2026-11-03 feat(fw): afficheurs LCD 16x2 de N1 et N2, choix de la sonde ST-LINK
    - Firmware scope : ecran d'accueil (noeud, source d'horloge,
    HSI - NON VALIDE), puis derniere trame recue, nombre de trames recues
    et etat du controleur. Pilote HD44780 4 bits non bloquant
    (ports/g431_fdcan/lcd.c), mise en forme sans HAL testee sur l'hote
    (common/app/lcd_text.c, tests_host/test_lcd_text.c).
    - BENCH_STLINK_SN : programme la sonde visee quand plusieurs cartes
    sont branchees (cmake/BenchFlash.cmake, README).
    - docs/pinout.md : brochage des LCD ; D13 est PB3, pas PB8.
2026-11-03 feat(hardware): PCB de l'adaptateur a l'echelle 1:1, a imprimer
    fabrication/pcb_echelle_1.pdf : A4 paysage, page 1 face avant (cuivre,
    serigraphie, contour), page 2 face arriere vue de dessus. Imprime en
    taille reelle, la carte mesure 87,7 x 41 mm (verifie sur le PDF
    rasterise) : on peut y poser les composants pour controler les
    empreintes. Produit par generate_fabrication.py.
2026-11-03 feat(hardware): schema de cablage du bus CAN du banc
    hardware/cablage_bus_can/ : 3 NUCLEO-G431KB avec chacune un Adafruit
    CAN Pal (TJA1051T/3), l'adaptateur MyActuator USBCAN-Z et
    l'alimentation FI 1233, sous forme de blocs avec les broches reellement
    utilisees. Schema KiCad (ERC sans erreur), PDF A3 et generateur
    generate_cablage.py.
    - CAN Pal sur le 3V3 de la Nucleo (pompe de charge 5 V integree),
    SLNT a GND, terminaisons ON aux deux extremites seulement.
    - Alimentation : VIN 8 V depuis CH1, ordre de mise sous tension
    d'UM2397 6.4.1 ; ou les Nucleo sur leur USB seul.
    - Notes : retrait de HW1, presets normaux n1 a n3 (jamais -direct),
    mesure de 60 ohms hors tension, protocole PC de l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
2026-11-03 feat: demonstration de dialogue CAN entre N1 et N2, et moniteur PC
    Firmware entry/dialogue.c (option BENCH_DIALOGUE, presets n1-dialogue
    a n3-dialogue) :
    - N1 demande "M'entends tu ?" (0x0A1) toutes les 5 s, N2 repond "Oui"
    (0x0A2), N1 conclut "Tres bien". Les textes sont decoupes en morceaux
    de 7 caracteres, octet 0 = (numero << 4) | nombre, et recolles a la
    reception. Ecran LCD : dernier message recu et dernier envoye.
    - Appel du PC : 0x0B0, octet 0 = numero du noeud (0 = tous) ; le noeud
    repond "Ici Nn" sur 0x0B0 + n.
    - Identifiants hors des plages reservees de l'ICD.
    pc/moniteur_dialogue.py : fenetre Tkinter qui lit le bus avec l'USBCAN-Z
    (bibliotheque ZLG zlgcan_x64, hors depot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
2026-11-03 feat(pc): moniteur de dialogue, mode --demo et affichage a l'echelle
    - --demo : apres un dialogue complet, appelle N1, N2 puis tous les
    noeuds et fige l'affichage (demonstrations, captures).
    - Rendu net et colonnes a la bonne largeur sur les ecrans a mise a
    l'echelle (125 %, 150 %).
    - Horloge de l'adaptateur ramenee sur celle du PC avec la plus petite
    latence USB observee : l'appel du PC ne parait plus anterieur aux
    trames deja affichees.
2026-11-03 docs: emplacement des ponts SB9/SB10 et des broches de la Nucleo
    Deux images annotees d'apres UM2397 Rev 2 (figures 4 et 12, table 11) :
    - SB9_SB10_emplacement.png : les ponts a souder pour relier le quartz
    24 MHz, et ceux a ne pas toucher (SB8, SB11, SB13) ;
    - nucleo_broches_banc.png : D2/PA12, D10/PA11, 3V3, VIN et GND utilises
    par le cablage du banc, vue de dessus.
2026-11-09 docs(presentation): captures du banc, images et sommaire technique
    - captures/ : captures de la demonstration du 03/11 (moniteur de dialogue, ZCANPRO)
    - images/ : rendus 3D, schema et PCB de l'adaptateur, schema de cablage du bus et
    simulation 3D, en PNG 2400 px, regenerables par generer_images.py
    - README.md : ce qu'il faut presenter, section par section, avec les chiffres cles
    et le chemin des sources, hors management
    - schema de cablage : la note sur l'USBCAN-Z donne le pilote ZLG identifie au lieu
    de "protocole a verifier"
2026-11-09 docs: liens vers bit_timing.md et architecture.md, jamais ecrits, redriges
    Le calcul du temps de bit et de la tolerance d'oscillateur est dans
    config_logicielle.md §3, l'architecture temps reel dans son §9, et le protocole
    ARM/GO dans protocole_validation.md (T3). README, bringup.md,
    protocole_validation.md et board.h pointent desormais vers ces sections.
    PLAN.md garde la mention de ces fichiers : c'est le plan initial.
2026-11-10 docs(presentation): diaporama recentre sur la technique, ouvrable dans PowerPoint
    - retire « Ou en est le projet », « Planning » et « Limites connues et
    prochaines etapes » : 16 -> 13 diapos
    - le besoin : retire l'encadre des parametres, « Debit et temps de bit » pour T2
    - materiel : terminaisons integrees, activees par interrupteur
    - demonstration : les constats montrent ce que le tableau prouve (decoupage
    en trames, reponse en 300 ms) au lieu des heartbeats et de l'arbitrage
    - merci : retire la phrase sur les demonstrations
    - ICD : deux fleches avaient une hauteur negative, ce qui empechait
    PowerPoint d'ouvrir le fichier ; meme trace, retournees verticalement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
2026-11-10 docs(presentation): explications diapo par diapo, a lire avant l'oral
    Samuel, lis bien EXPLICATIONS_DIAPOS.md en entier avant la presentation.
    Il explique ce que montre chaque diapo de la nouvelle version (13 diapos) et
    comment repondre aux questions probables :
    - les sept tests T1 a T7, et le fait qu'aucun n'est encore deroule en entier ;
    - l'ICD et son generateur (C, Python, DBC, LaTeX), les 248 vecteurs ;
    - les terminaisons 120 ohms, integrees et activees par interrupteur, et
    comment les verifier au multimetre (60 ohms) ;
    - l'architecture en couches des firmwares ;
    - la demo du 03/11 : ce que le tableau montre, et ce qu'il ne montre pas ;
    - le role de chaque composant de l'adaptateur U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
2026-11-10 feat(hardware): bornier a vis 3 points a la place de la DB9 sur l'adaptateur USB-CAN
    Le bus du banc est cable en fils nus, visses sur les borniers de l'USBCAN-Z et
    des CAN Pal : la DB9 obligeait a fabriquer un cable a part.
    - J2 : bornier Phoenix MKDS 1,5/3-5,08 (1 GND, 2 CAN_L, 3 CAN_H), au bord droit,
    entree des fils vers l'exterieur ; de haut en bas H, L, G comme l'USBCAN-Z,
    reperes en serigraphie
    - PCB : CAN_H, CAN_L et la masse de C14 retraces jusqu'au bornier
    - ERC 0 ; DRC regles ENSEA 0 erreur, 0 liaison manquante, parite schema OK
    (7 avertissements de serigraphie, comme avant)
    - fabrication, nomenclature, commande, SOURCES_COMPOSANTS.md et images de la
    presentation regeneres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
2026-11-10 feat(hardware): adaptateur USB-CAN v0.2, 60 x 30 mm, fiche USB-A en cle
    Carte deux fois plus petite que la v0.1 (87,7 x 41 mm) :
    - 60 x 30 mm, composants sur les deux faces, sans trou de fixation
    - fiche USB-A male (CNCTech 1001-011-01101) : branchement direct sur le PC,
    comme une cle USB
    - passifs en 0805 HandSolder, quartz CMS 5 x 3,2 mm, boutons CMS Omron B3U
    - LED RX/TX sur PA7/PB0 (broches du bas du STM32, a cote des LED)
    - SWD sur 4 broches dans l'ordre du STM32 : SWCLK, SWDIO, GND, 3V3
    - plan de masse sur les deux faces, relie par des vias de couture
    Routage : Freerouting pour les signaux (route_freerouting.py, 4 essais en
    parallele), dernieres liaisons autour du STM32 et de l'USB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
2026-11-13 fix(hardware): adaptateur USB-CAN conforme au cours PCB de l'option Maker
    - champs Manufacturer et MPN sur les 37 symboles, datasheet sur 14
    - classe de nets « Puissance » (VBUS, +5V, +3V3) a 0,6 mm ; 52 segments elargis
    la ou l'isolation et le plan de masse le permettent
    - 370 teardrops sur les pastilles et les vias
    - U5 : piste de masse pour supprimer le goulot de 0,27 mm
    - C7 (10 nF de VDDA) a 3,6 mm de la broche 15, echange avec C8
    - dossier de fabrication et tableau de commande regeneres
    ERC 0, DRC 0 erreur (12 avertissements de serigraphie inchanges).
2026-11-13 feat(hardware): boitier imprime en 3D de l'adaptateur USB-CAN
    Deux coques encliquetables (64 x 34,4 x 10,7 mm) modelisees en OpenSCAD :
    fiche USB-A en cle a l'avant, bornier traversant a l'arriere, trous des LED,
    poussoirs souples pour RESET et BOOT0, fenetre pour les barrettes SWD et TERM.
    Imprimable sans support ; STL, projet Bambu Studio et G-code pour la
    Bambu Lab X1 Carbon du FabLab (plateau texture PEI ou Cool Plate).
2026-11-13 feat(hardware): cablage du bus a 4 Nucleo-G431KB et TJA1051T/3 sur adaptateur SOP8
    Le schema de cablage passe de 3 Nucleo + 3 Adafruit CAN Pal a 4 Nucleo-G431KB et
    4 TJA1051T/3 soudes sur adaptateurs SOP8 (commande BC-2026-G69-001), avec
    l'interface ZLG USBCAN-UC12. Terminaisons : interrupteur 120 ohms du ZLG et
    resistance de 120 ohms sur l'adaptateur de N4. Alimentation par le hub USB
    alimente Velleman HQM121C.
2026-11-13 feat(pc): adaptateur ZLG USBCAN-UC12 par WinUSB et panneau Qualite
    - canbench --interface zlg : pilote WinUSB du depot (pc/canbench/zlg_usbcan/),
    sans le pilote noyau de ZLG refuse par l'integrite de la memoire de Windows ;
    protocole decrit dans PROTOCOLE.md, outil bas niveau `python -m canbench.zlg_usbcan`
    - panneau Qualite de l'interface : etat du controleur de l'adaptateur, trames non
    acquittees, periode, gigue et trames manquees par identifiant
    - lancer_banc.bat zlg ; extra `zlg` dans pyproject
    121 tests Python passent.
2026-11-13 refactor!: noeud N4 sur Nucleo-G431KB, abandon de la Blue Pill STM32F103
    Les quatre noeuds du banc sont desormais des Nucleo-G431KB identiques.
    - firmware : N4 compile sur le port FDCAN du G431 ; retrait du port
    ports/f103_bxcan, de boards/bluepill_f103, de cmake/openocd_f1.cfg et des
    sous-modules ST cmsis_device_f1 et stm32f1xx_hal_driver
    - presets : n4 et n4-selftest sur G431, nouveau n4-selftest-hsi
    - ICD : N4 sur nucleo_g431kb ; schema, code genere, simulation 3D regeneres
    - outils : bit_timing.py et extrait LaTeX de configuration a une seule carte
    - simulation 3D : N4 represente par une Nucleo, modele de la Blue Pill retire
    - schema fonctionnel (phase 0) mis a jour et renvoyant au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
2026-11-13 docs: point d'etat du projet et liste des choix abandonnes
    - docs/ETAT_PROJET.md : ce qui est fait et verifie, ce qui a ete abandonne
    (Blue Pill, CANable, pilote ZLG, CAN Pal, DB9, alimentation 12 V + LM2596,
    LQFP48 de l'adaptateur, Amazon Business, SN65HVD230) avec la raison et le
    remplacement, les points a confirmer et ce qui reste a faire
    - PLAN.md : etat reel des lots, questions Q2/Q5b/Q5c tranchees, points a verifier
    propres a la Blue Pill marques sans objet
    - README : lien vers l'etat du projet, organisation du depot et sous-modules a
    jour, section sur l'adaptateur ZLG par WinUSB
    - CHANGELOG : sections Modifie et Retire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
2026-11-13 refactor!: retrait du pont slcan L476 et des afficheurs LCD 16x2
    Decisions du groupe du 13/11/2026.
    - pont CAN-USB sur Nucleo-L476RG : entry/slcan_bridge.c, boards/nucleo_l476rg,
    ports/l476_bxcan, cmake/openocd_l4.cfg, presets bridge et bridge-direct,
    sous-modules cmsis_device_l4 et stm32l4xx_hal_driver retires. Le module de
    protocole common/app/slcan.c et son test sont gardes pour le firmware de
    l'adaptateur USB-CAN.
    - afficheurs LCD 16x2 : pilote HD44780, mise en forme lcd_text et son test,
    broches de board.h et schema retires ; les firmwares scope et dialogue gardent
    leur journal serie. Les ecrans OLED SSD1306 les remplacent.
    - tous les noeuds compilent sur la seule cible Nuc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
2026-11-13 docs: decisions du 13/11 dans l'etat du projet
    - interrupteurs de faute SW1 a SW3 gardes, a cabler
    - seul le MPU-6050 recu est ajoute ; capteur a effet Hall et DS18B20 reportes
    - pont slcan L476 et LCD 16x2 ajoutes aux choix abandonnes
    - reste a faire : commande complementaire pour N4 (adaptateur SOP8, OLED),
    MPU-6050, firmware de l'adaptateur, mise a jour de la simulation 3D
2026-11-13 feat(hardware): carte porteuse d'un noeud (Nucleo-G431KB, TJA1051T/3, OLED, MPU-6050)
    Schema, PCB 65 x 50 mm route (ERC 0, DRC 0 erreur), dossier de fabrication et commande. Teardrops et relecture restent a faire.
2026-11-13 feat(hardware): teardrops sur la carte porteuse, fabrication regeneree
    105 teardrops ; DRC 0 erreur, 0 non connecte (avertissements de serigraphie seulement).
2026-11-13 feat(hardware): carte porteuse v0.2 compacte, modules debout, fixations M3
    - contour en escalier : 2 050 mm2 au lieu de 3 250 (-37 %), deux angles rentrants
    - Nucleo dans la profondeur, USB vers l'arriere ; bus entre a gauche, sort a droite
    - OLED et MPU-6050 sur barrettes coudees : modules debout au-dela du bord
    - deux trous M3 entre les barrettes de la Nucleo (cours : fixations d'abord)
    - une seule barrette capteurs (non montee), tirage 1-Wire retire
    - masse routee aussi par Freerouting ; 111 teardrops
    - controle 3D des encombrements : aucun conflit (verification/)
    - ERC 0, DRC 0 erreur, 0 non connecte
2026-11-13 fix(hardware): retrait des vias de masse superflus (adaptateur 254 -> 35, carte porteuse 137 -> 16)
    Script hardware/elaguer_vias.py : retire un via de masse s'il ne sert à
    aucune liaison (plans remplis et liaisons recomptées après chaque retrait),
    avec les pistes et teardrops qui ne menaient qu'à lui. Les vias de couture
    seront posés à la main. DRC : 0 erreur, 0 liaison manquante sur les deux
    cartes. Dossiers fabrication régénérés.
2026-11-13 feat(hardware): vias de couture sur l'adaptateur (USB, quartz, TJA1051)
    Script hardware/poser_vias_couture.py : pose un via GND au plus près de
    chaque cible, uniquement là où son disque tient entièrement dans le plan
    rempli des deux faces. 5 vias ajoutés (43 au total), teardrops refaits,
    DRC : 0 erreur, 0 liaison manquante. Fabrication régénérée.
2026-11-13 feat(hardware): couches de pâte pour les pochoirs, vias de couture de la carte porteuse
    - generate_fabrication.py (adaptateur, carte porteuse) : export de F.Paste et
    B.Paste, une ouverture par pastille CMS, pour découper les pochoirs du four
    (cours Option Maker Soudure) ;
    - carte porteuse : vias de couture posés à la main (34 vias), teardrops
    refaits ; DRC 0 erreur, 0 liaison manquante ;
    - dossiers fabrication régénérés.
2026-11-13 docs(carte porteuse): vias de couture posés (34 vias), 99 teardrops
